johnnyclem/EP-DJ3000/artifacts/searched_images/0aDA2.jpg

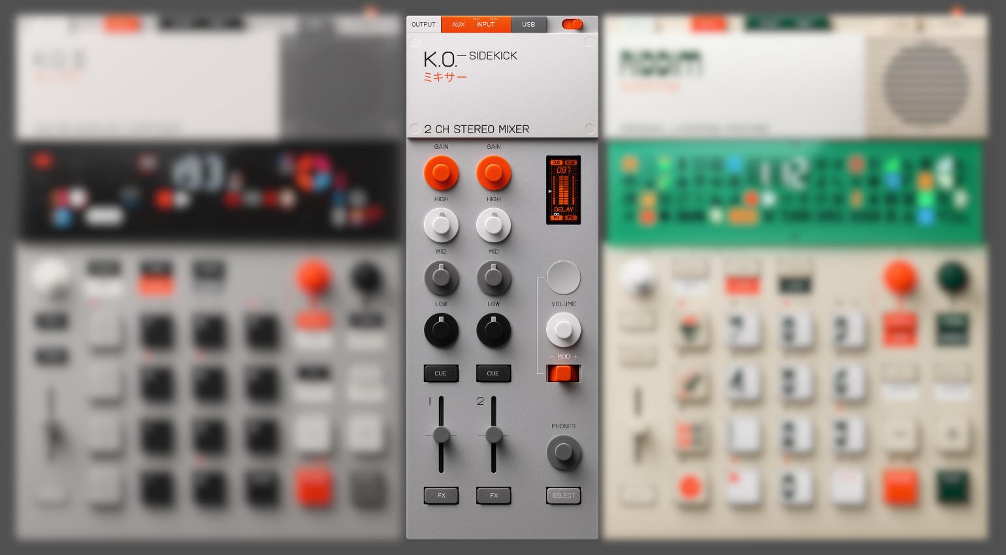
artifacts/searched_images/0aDA2.jpg
