johnnyclem/EP-DJ3000/artifacts/searched_images/1Hn3o.jpg

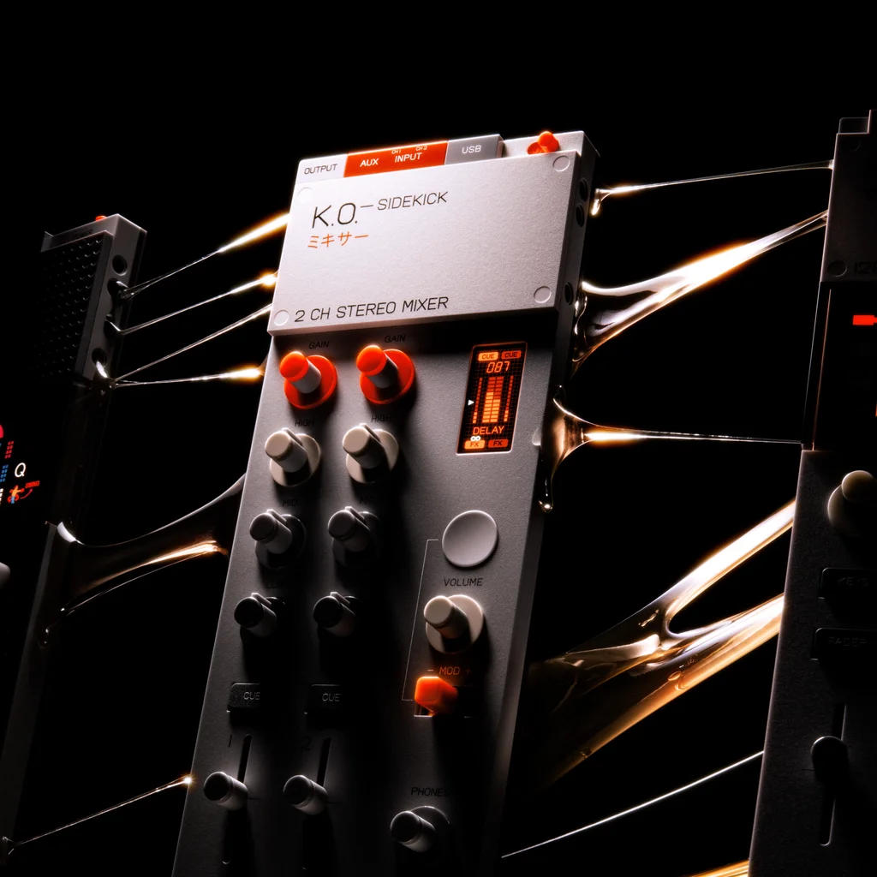
artifacts/searched_images/1Hn3o.jpg
