johnnyclem/EP-DJ3000/artifacts/searched_images/2lIIS.jpg

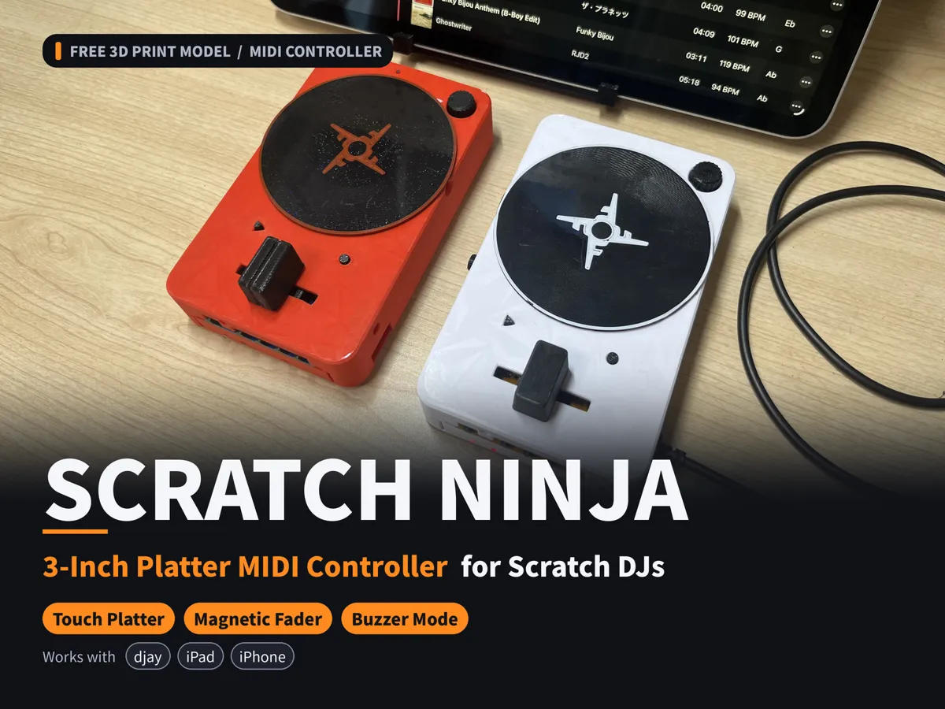
artifacts/searched_images/2lIIS.jpg
