johnnyclem/EP-DJ3000/artifacts/searched_images/Bpl0B.jpg

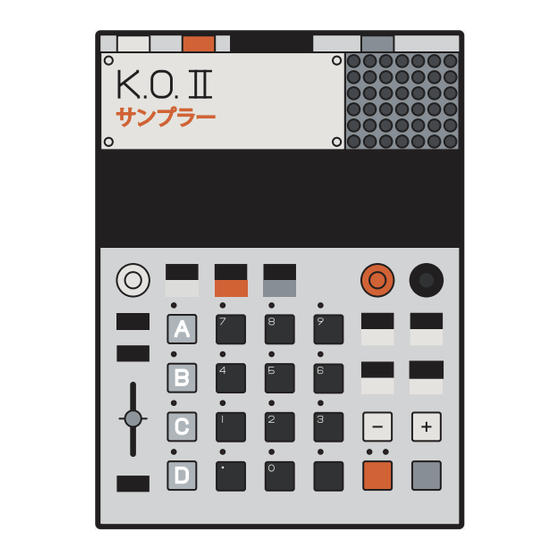
artifacts/searched_images/Bpl0B.jpg
