johnnyclem/EP-DJ3000/artifacts/searched_images/CU1t4.jpg

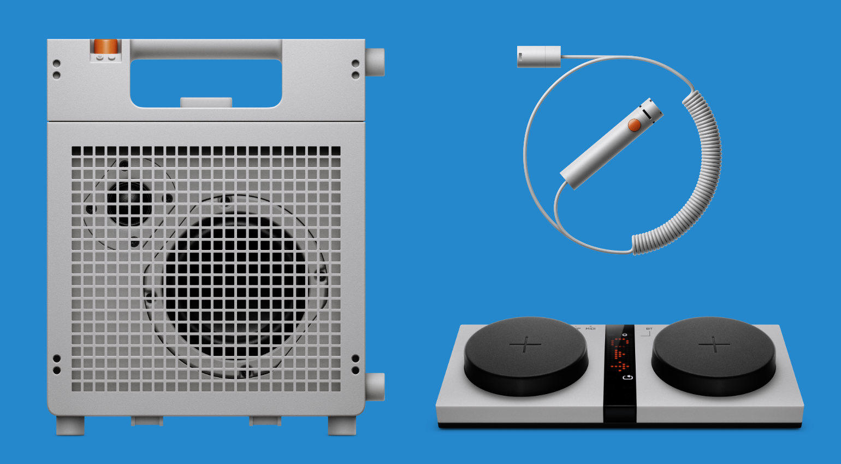
artifacts/searched_images/CU1t4.jpg
