johnnyclem/EP-DJ3000/artifacts/searched_images/eoEJe.jpg

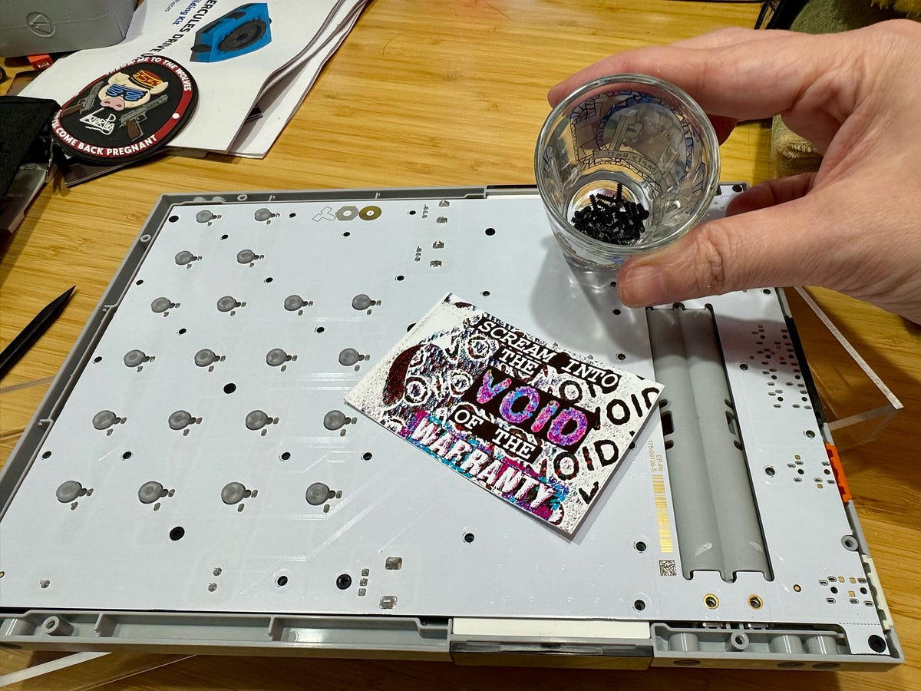
artifacts/searched_images/eoEJe.jpg
