johnnyclem/EP-DJ3000/artifacts/searched_images/ep7Hu.jpg

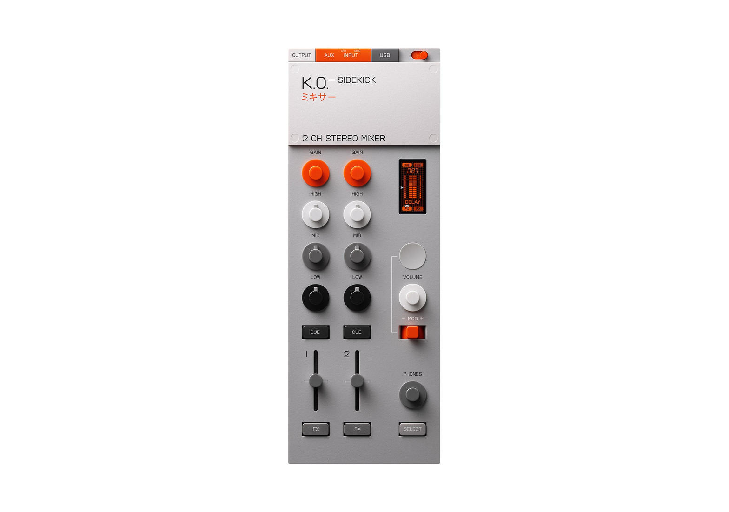
artifacts/searched_images/ep7Hu.jpg
