johnnyclem/EP-DJ3000/artifacts/searched_images/fRpeS.jpg

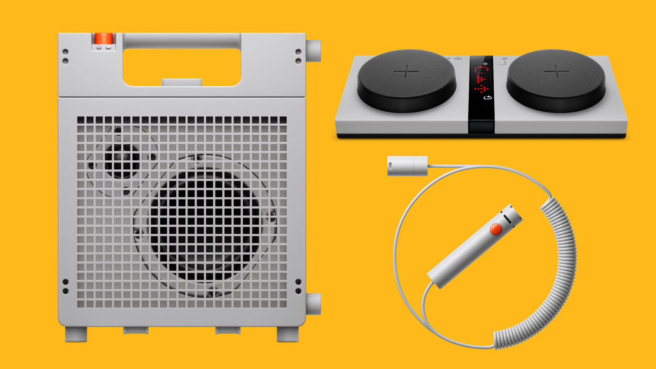
artifacts/searched_images/fRpeS.jpg
