johnnyclem/EP-DJ3000/artifacts/searched_images/FZIE1.jpg

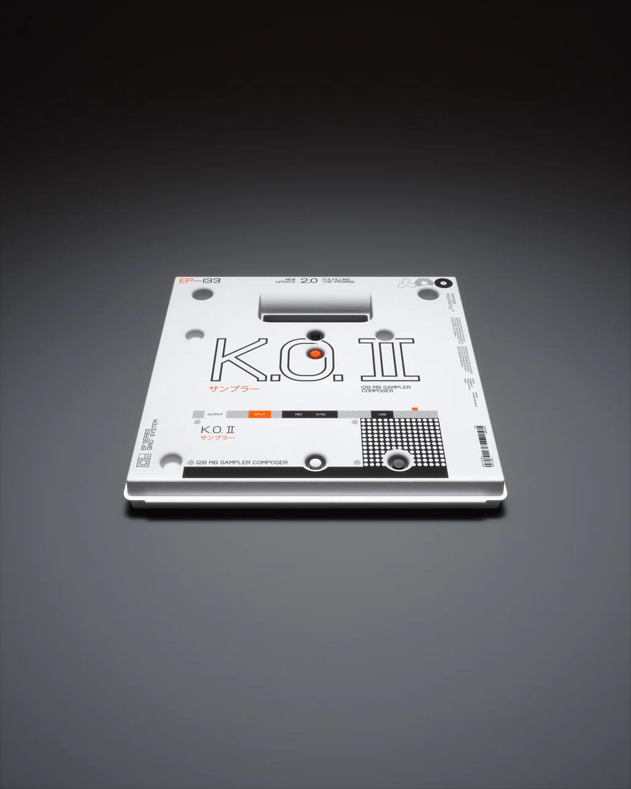
artifacts/searched_images/FZIE1.jpg
