johnnyclem/EP-DJ3000/artifacts/searched_images/GA8qb.jpg

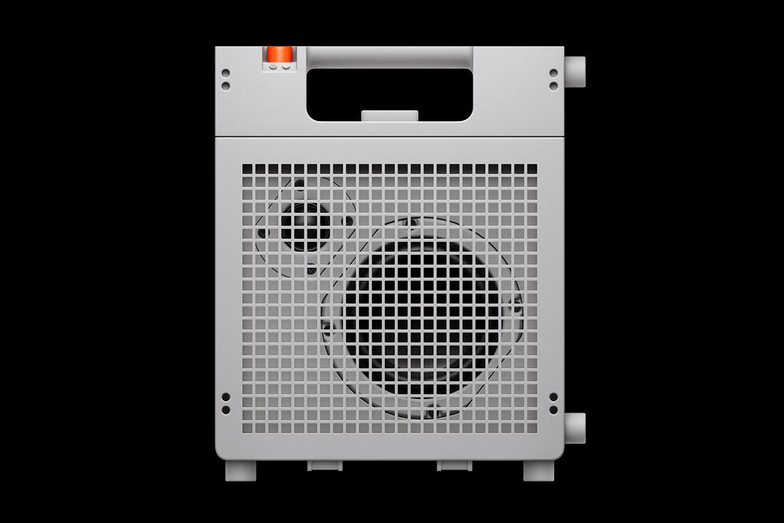
artifacts/searched_images/GA8qb.jpg
