johnnyclem/EP-DJ3000/artifacts/searched_images/iFiOh.jpg

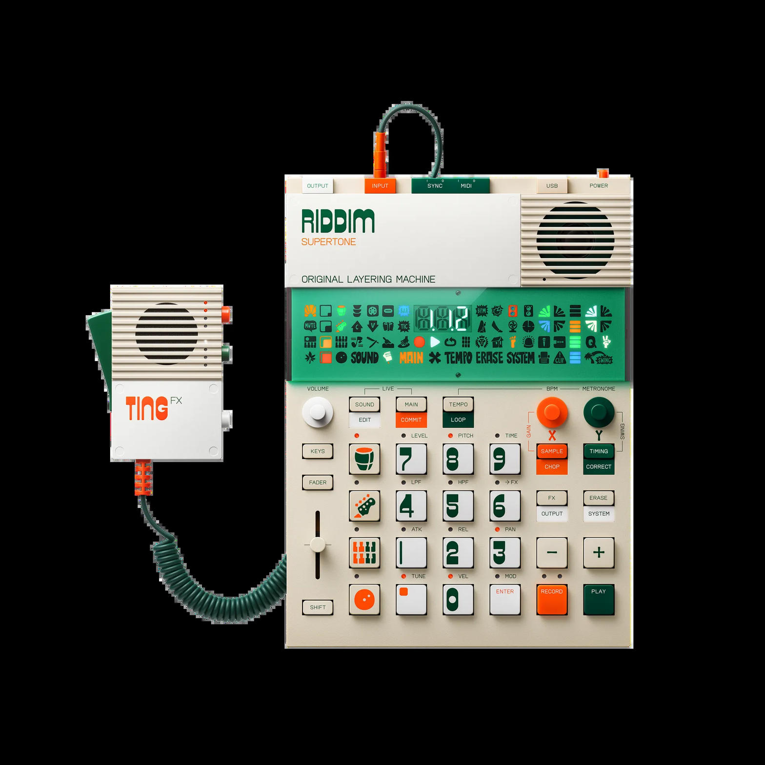
artifacts/searched_images/iFiOh.jpg
