johnnyclem/EP-DJ3000/artifacts/searched_images/ihluV.jpg

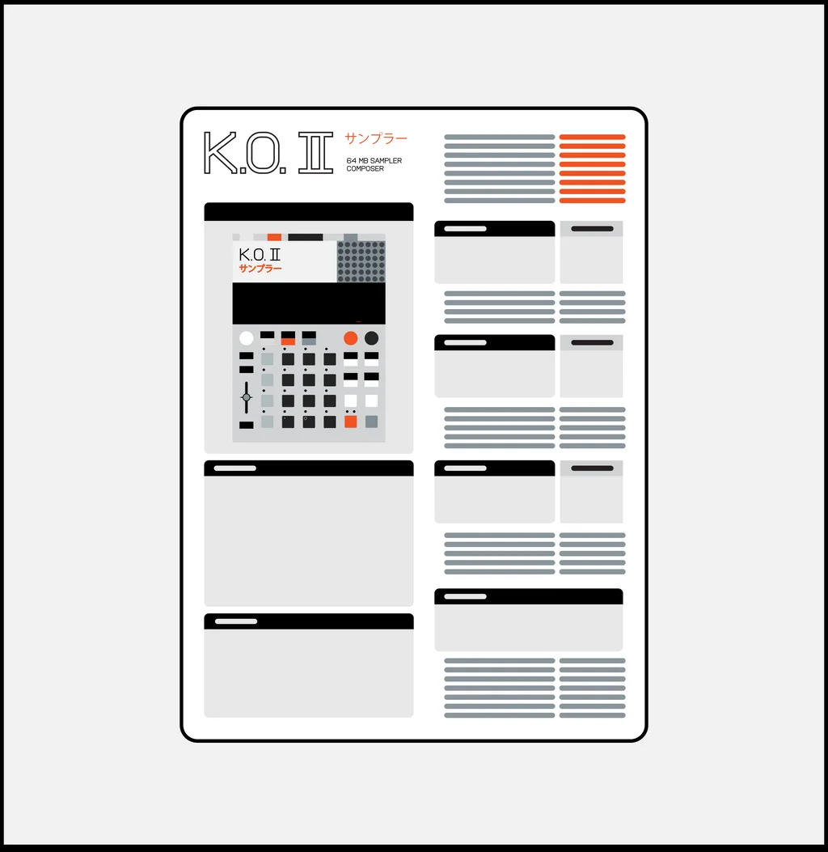
artifacts/searched_images/ihluV.jpg
