johnnyclem/EP-DJ3000/artifacts/searched_images/Iwwkr.jpg

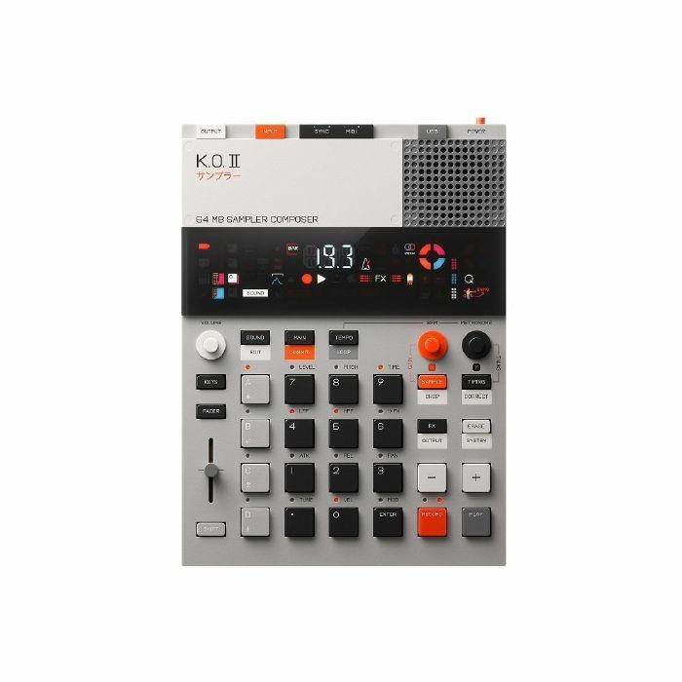
artifacts/searched_images/Iwwkr.jpg
