johnnyclem/EP-DJ3000/artifacts/searched_images/KVUyy.jpg

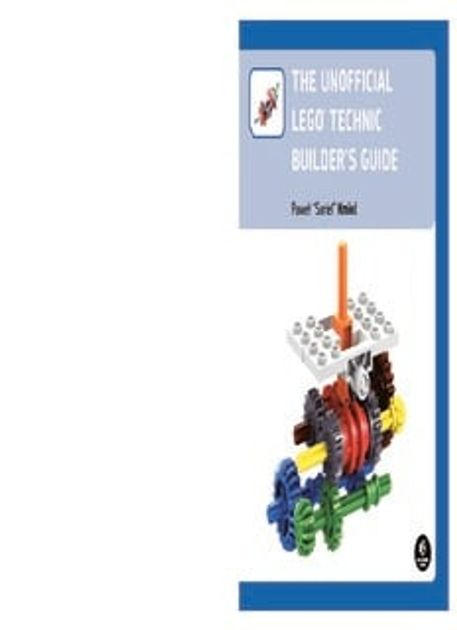
artifacts/searched_images/KVUyy.jpg
