johnnyclem/EP-DJ3000/artifacts/searched_images/Lq6Z9.jpg

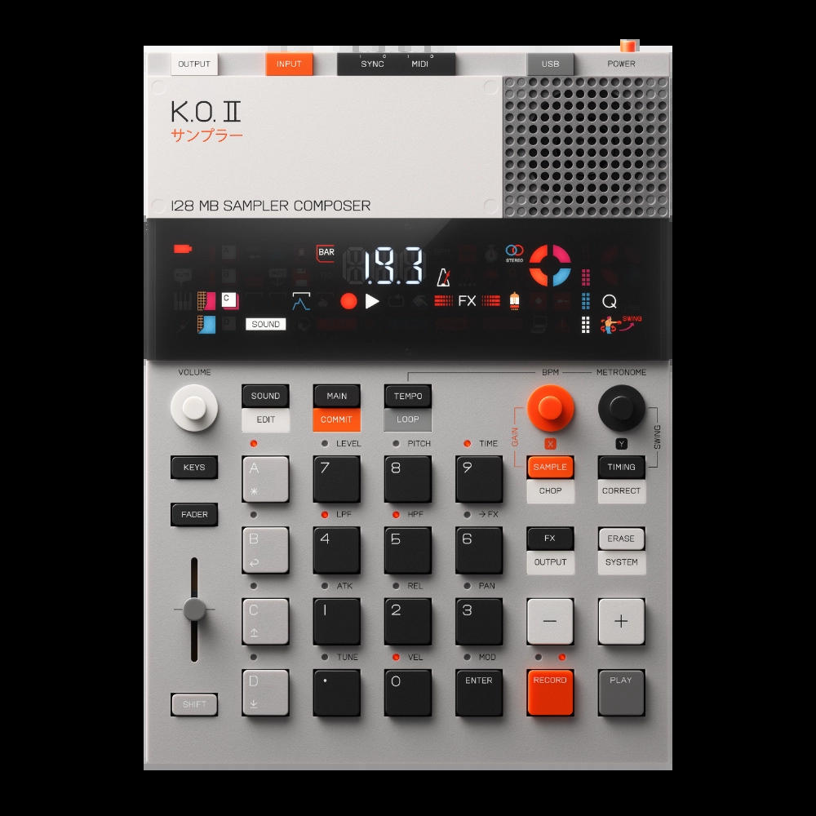
artifacts/searched_images/Lq6Z9.jpg
