johnnyclem/EP-DJ3000/artifacts/searched_images/m1aqs.jpg

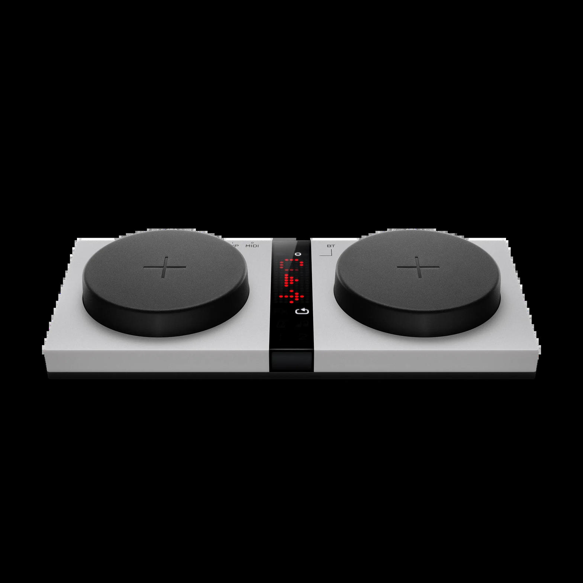
artifacts/searched_images/m1aqs.jpg
