johnnyclem/EP-DJ3000/artifacts/searched_images/nP86a.jpg

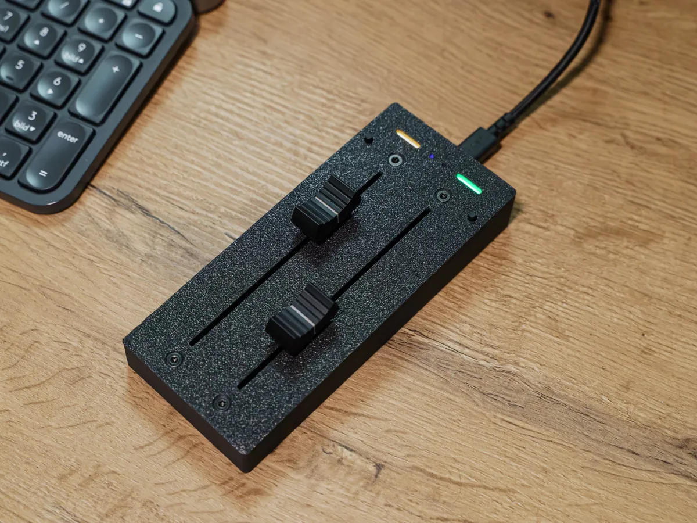
artifacts/searched_images/nP86a.jpg
