johnnyclem/EP-DJ3000/artifacts/searched_images/pBY69.jpg

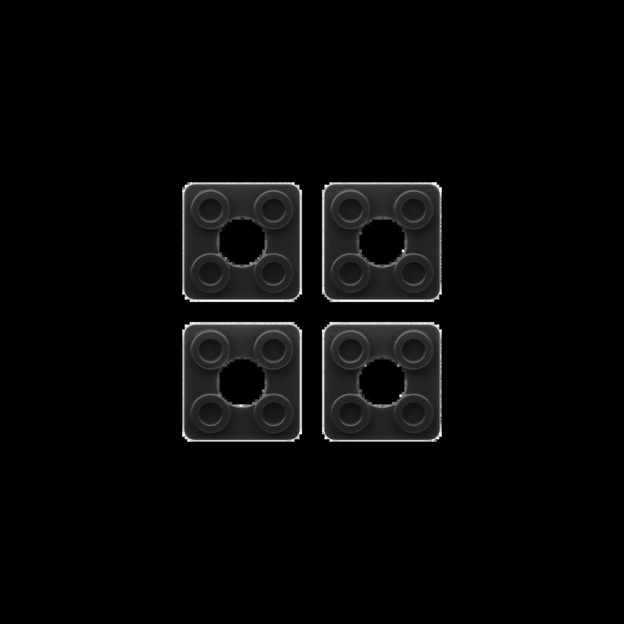
artifacts/searched_images/pBY69.jpg
