johnnyclem/EP-DJ3000/artifacts/searched_images/RAQyJ.jpg

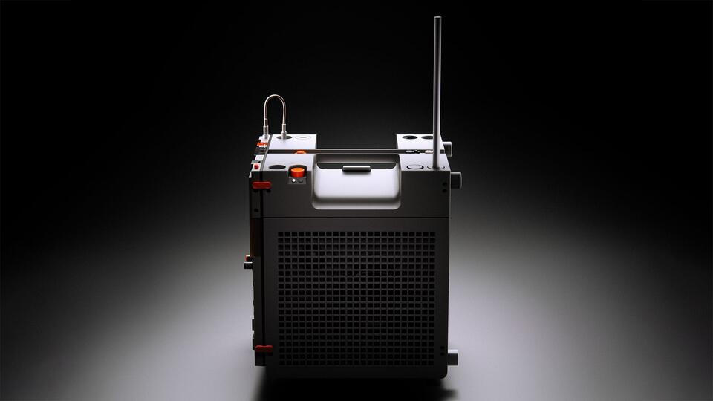
artifacts/searched_images/RAQyJ.jpg
