johnnyclem/EP-DJ3000/artifacts/searched_images/Tj97H.jpg

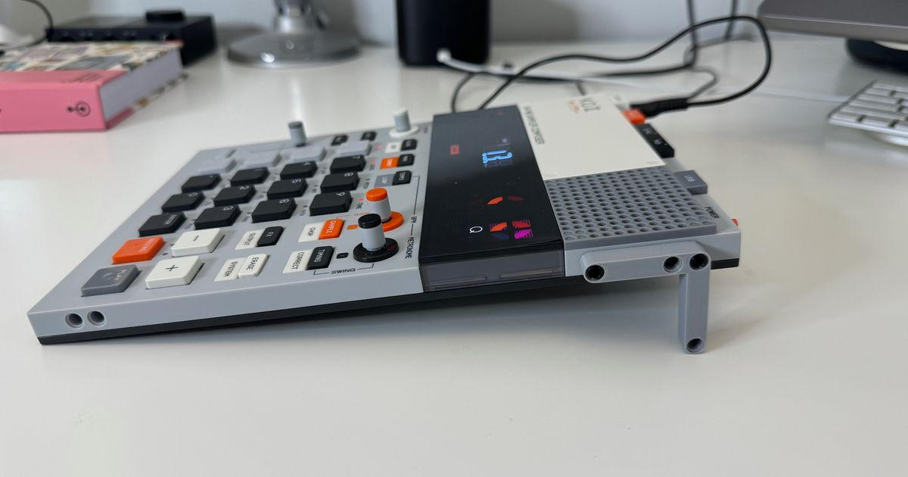
artifacts/searched_images/Tj97H.jpg
