johnnyclem/EP-DJ3000/artifacts/searched_images/U6moF.jpg

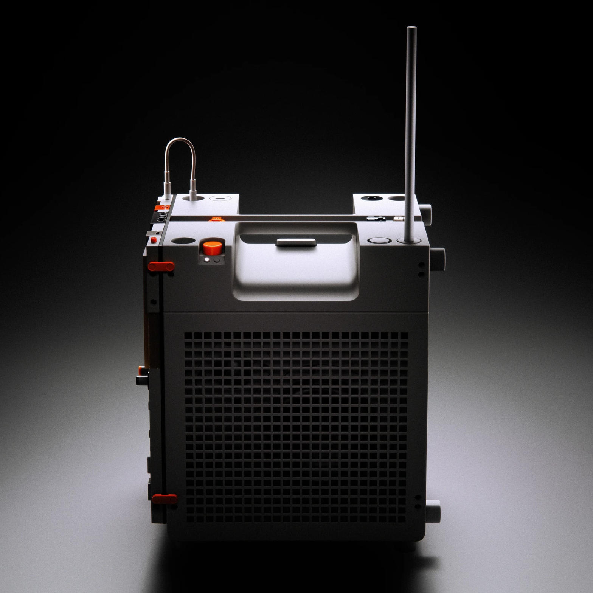
artifacts/searched_images/U6moF.jpg
