johnnyclem/EP-DJ3000/artifacts/searched_images/ufimg.jpg

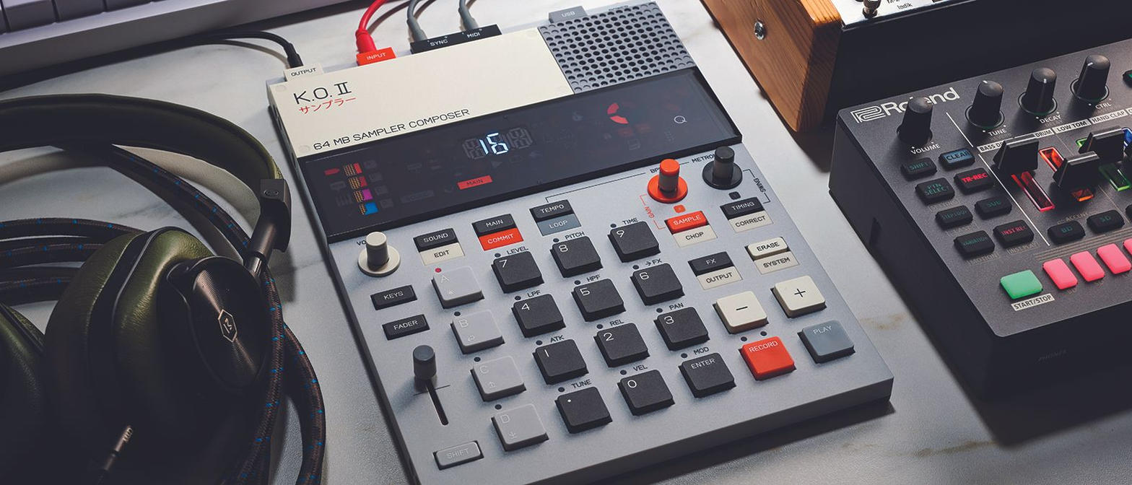
artifacts/searched_images/ufimg.jpg
