johnnyclem/EP-DJ3000/artifacts/searched_images/W83gK.jpg

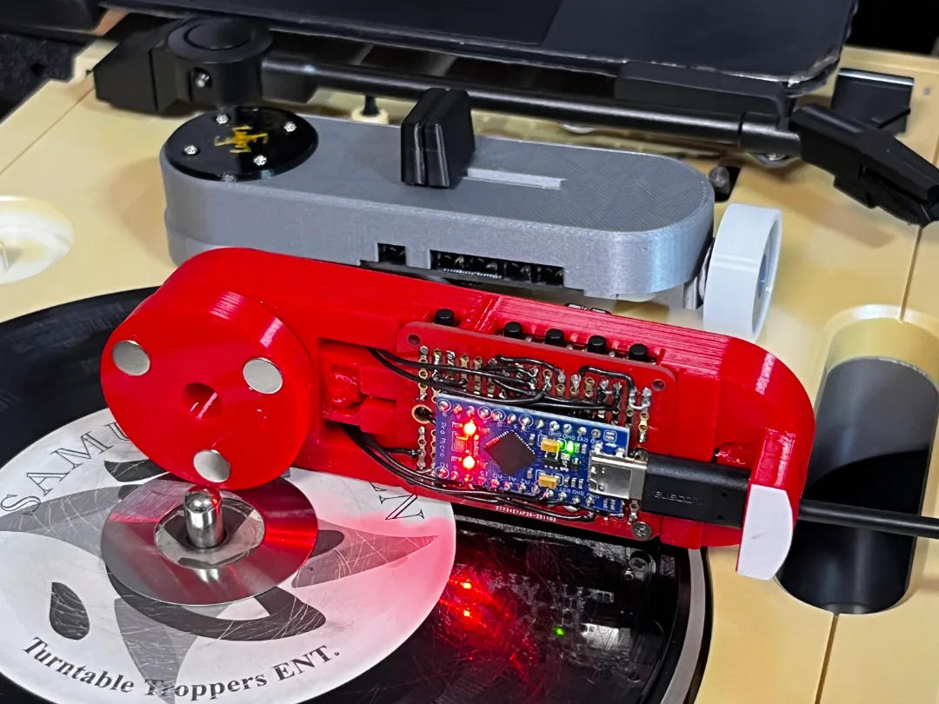
artifacts/searched_images/W83gK.jpg
