johnnyclem/EP-DJ3000/attachments/IMG_1222.jpg

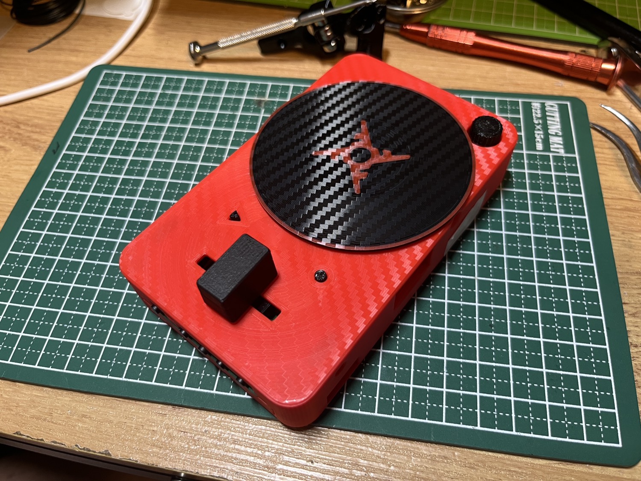
attachments/IMG_1222.jpg
