johnnyclem/EP-DJ3000/attachments/IMG_1223.jpg

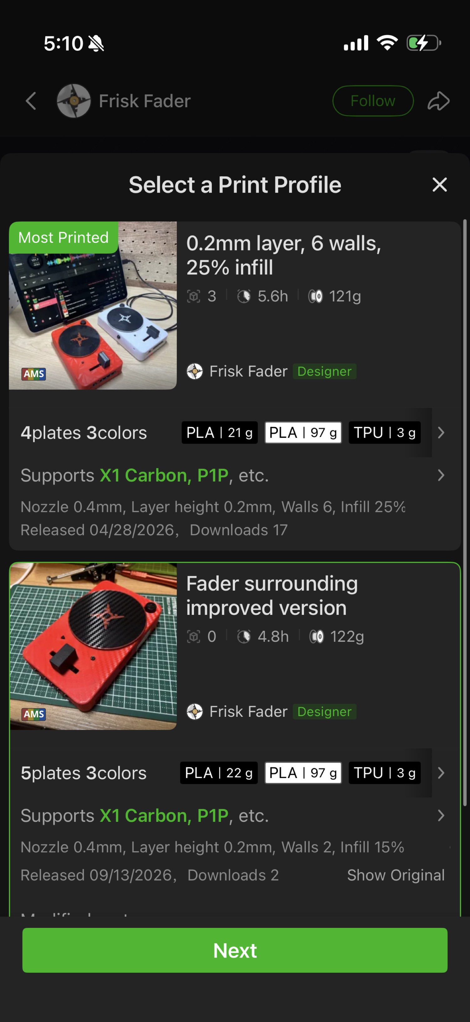
attachments/IMG_1223.jpg
