johnnyclem/EP-DJ3000/attachments/IMG_1224.jpg

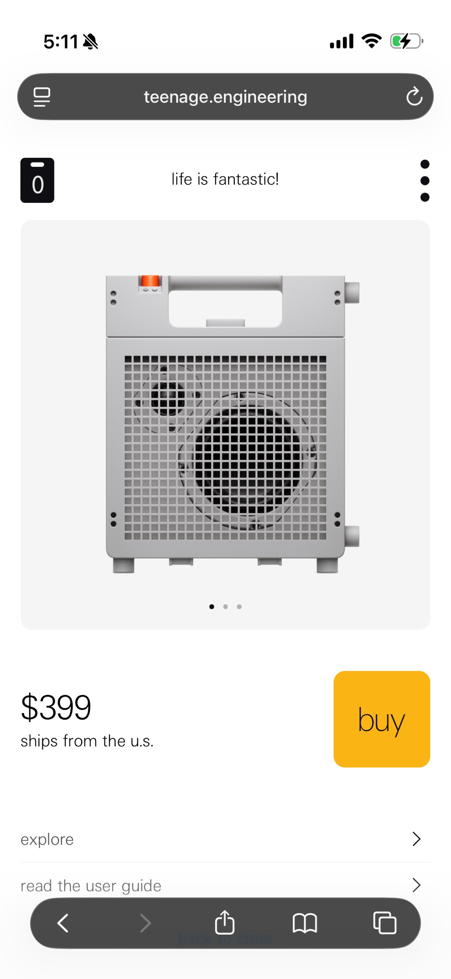
attachments/IMG_1224.jpg
