johnnyclem/EP-DJ3000/attachments/IMG_1225.jpg

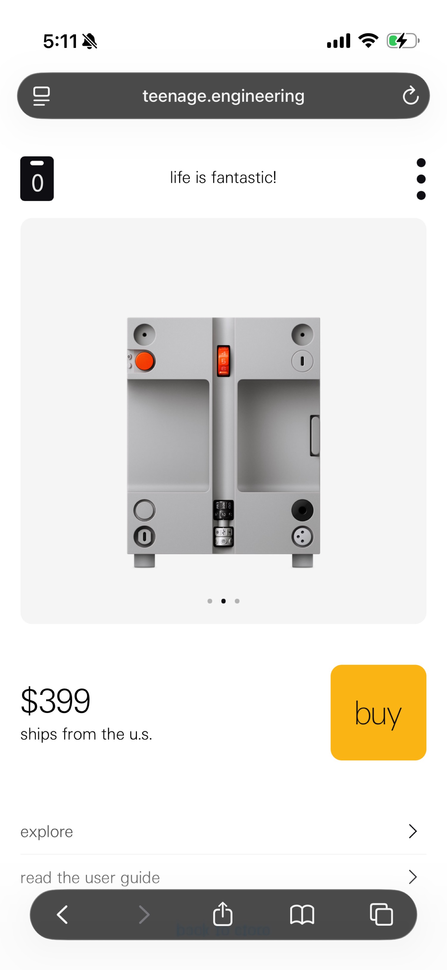
attachments/IMG_1225.jpg
