johnnyclem/EP-DJ3000/attachments/IMG_1226.jpg

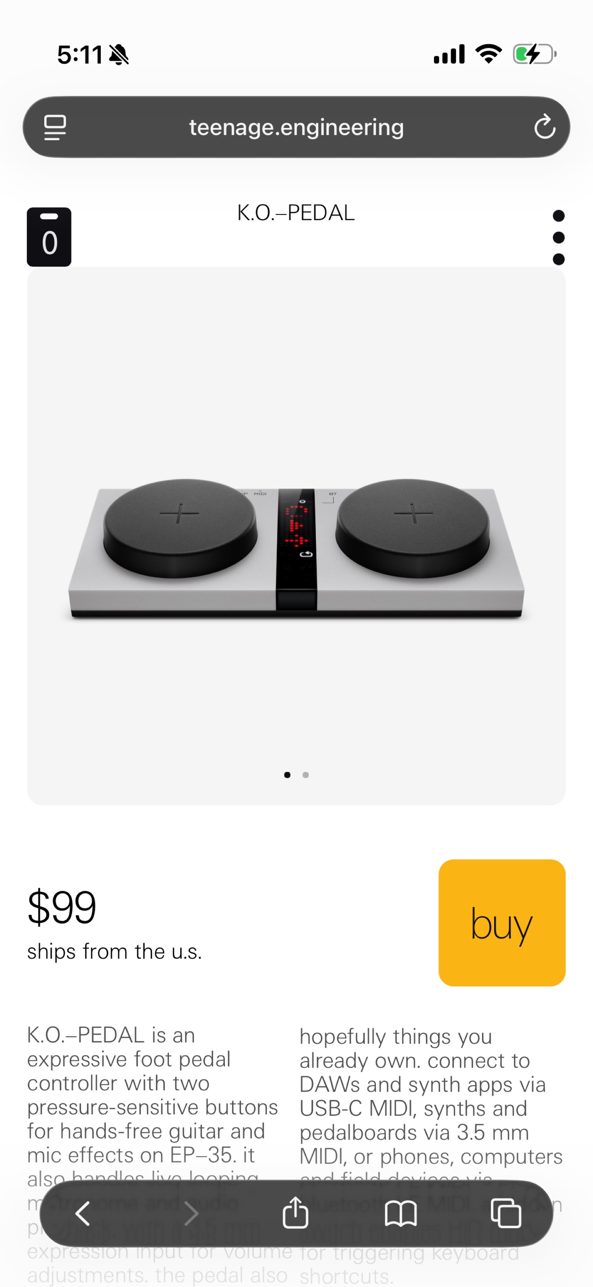
attachments/IMG_1226.jpg
