johnnyclem/EP-DJ3000/attachments/IMG_1227.jpg

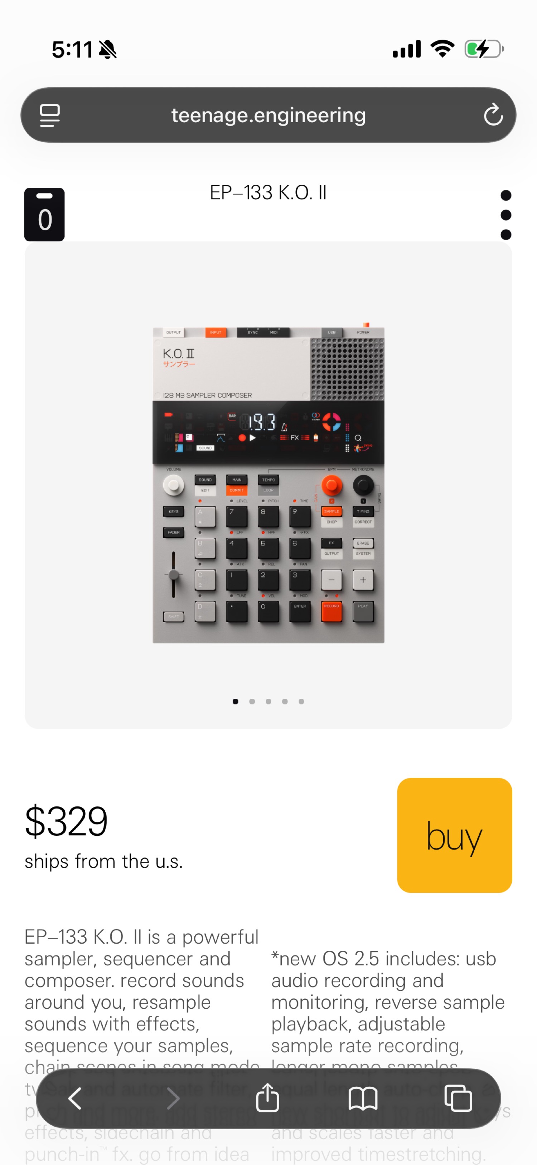
attachments/IMG_1227.jpg
