johnnyclem/EP-DJ3000/attachments/IMG_1228.jpg

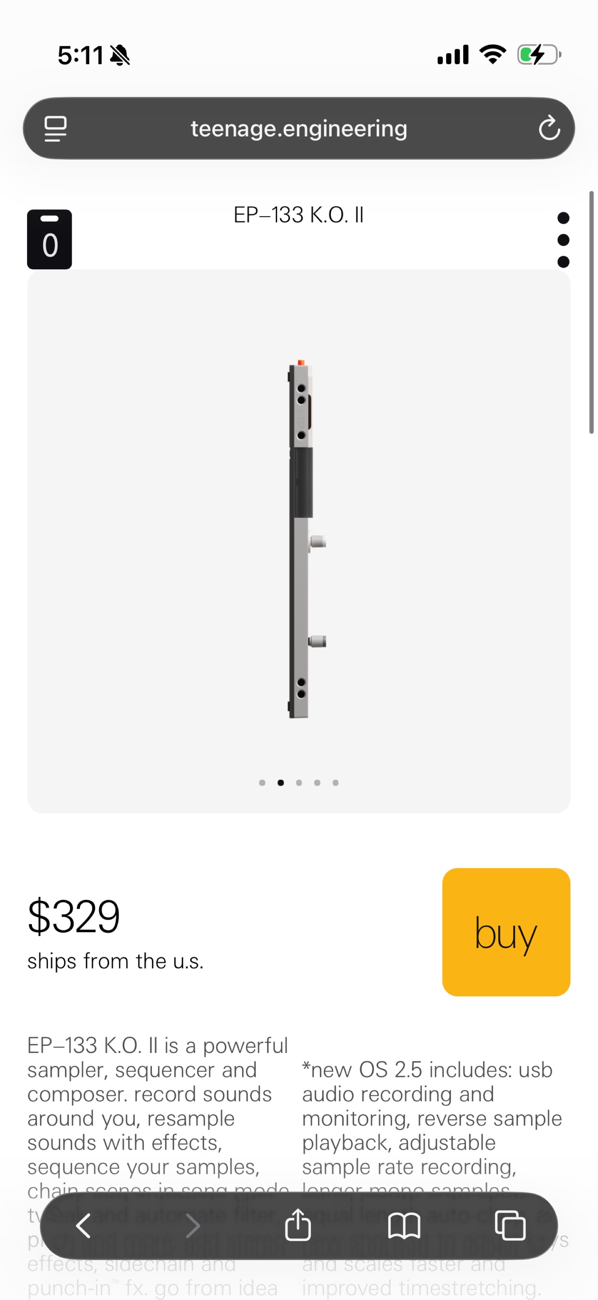
attachments/IMG_1228.jpg
