johnnyclem/EP-DJ3000/attachments/IMG_1229.jpg

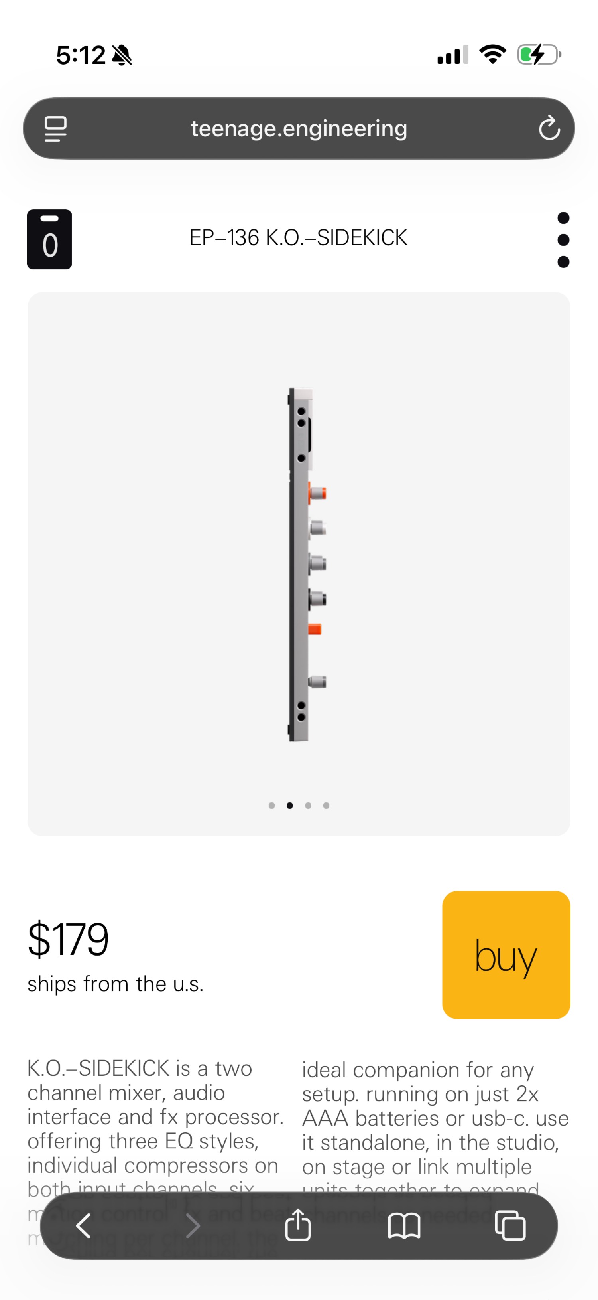
attachments/IMG_1229.jpg
