johnnyclem/EP-DJ3000/attachments/IMG_1230.jpg

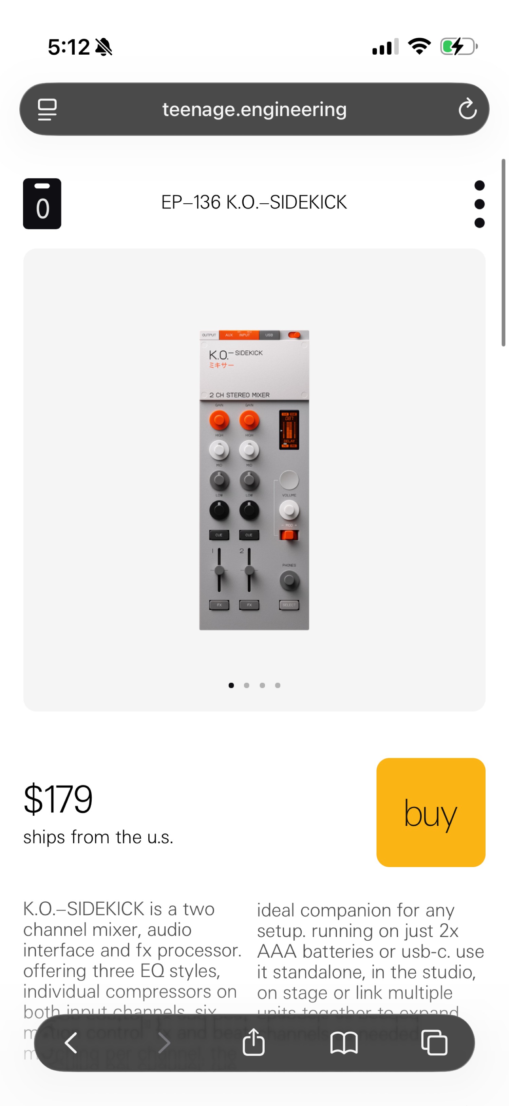
attachments/IMG_1230.jpg
