johnnyclem/EP-DJ3000/field-jog/preview/pins-section.png

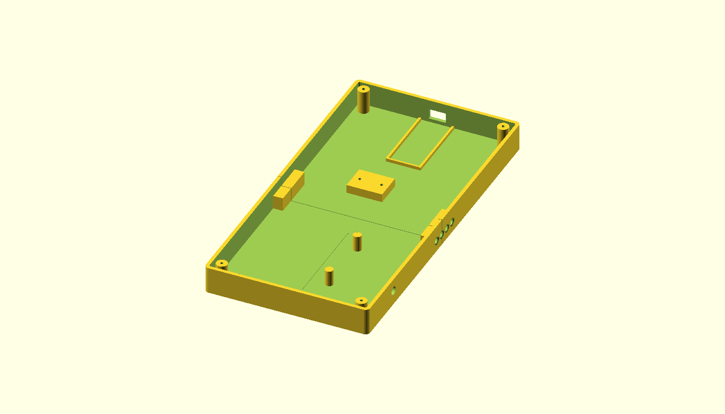
field-jog/preview/pins-section.png
