johnnyclem/EP-DJ3000/field-jog/preview/section.png

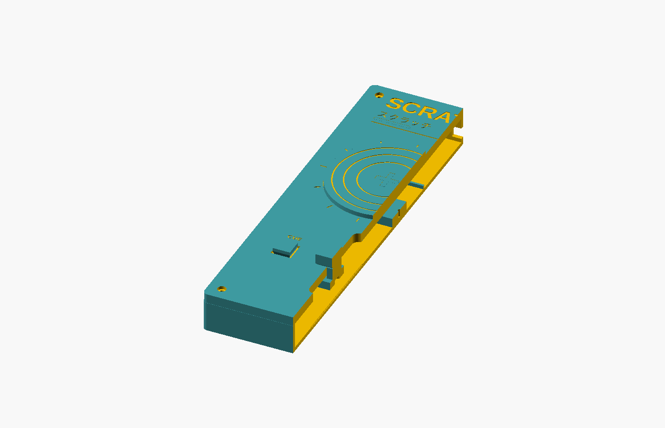
field-jog/preview/section.png
