johnnyclem/EP-DJ3000/field-jog/preview/side.png

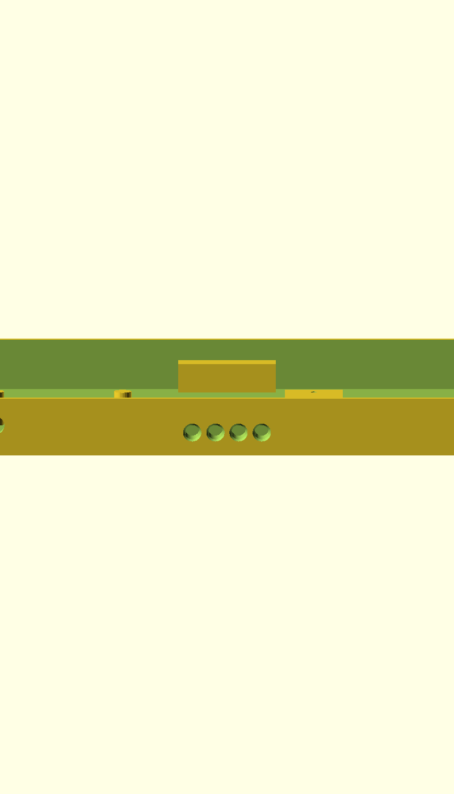
field-jog/preview/side.png
