johnnyclem/EP-DJ3000/screenshots/built-now-mobile.png

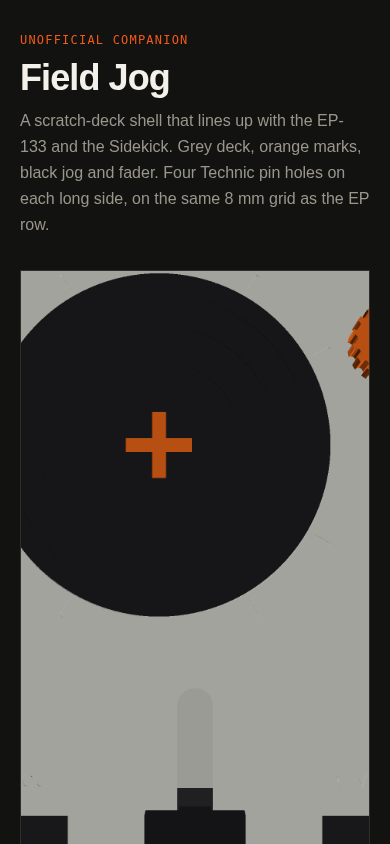
screenshots/built-now-mobile.png
