johnnyclem/EP-DJ3000/screenshots/built-now.png

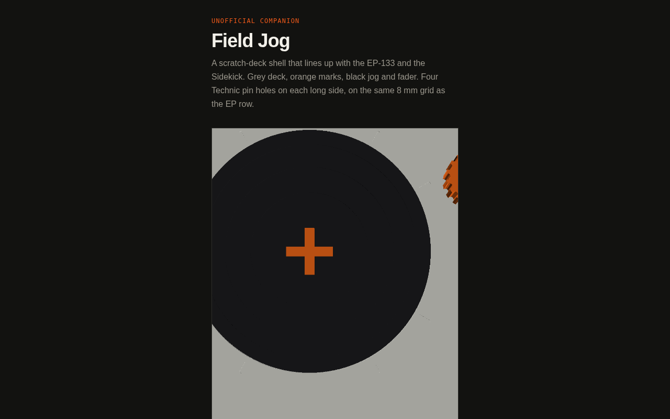
screenshots/built-now.png
