johnnyclem/EP-DJ3000/screenshots/viewer-built.png

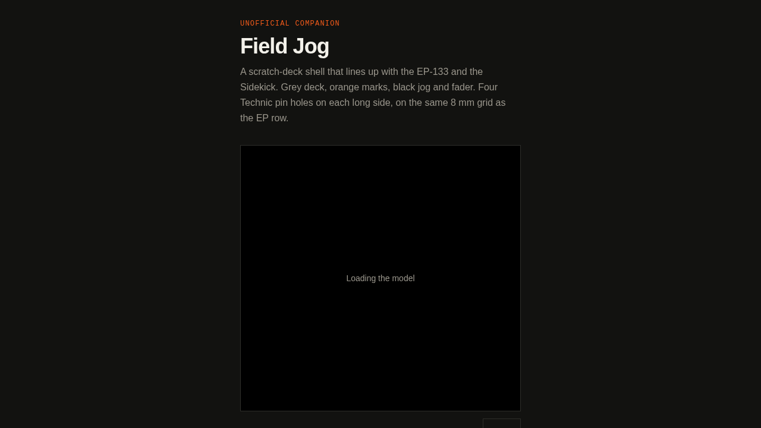
screenshots/viewer-built.png
