johnnyclem/EP-DJ3000/screenshots/viewer-fader.png

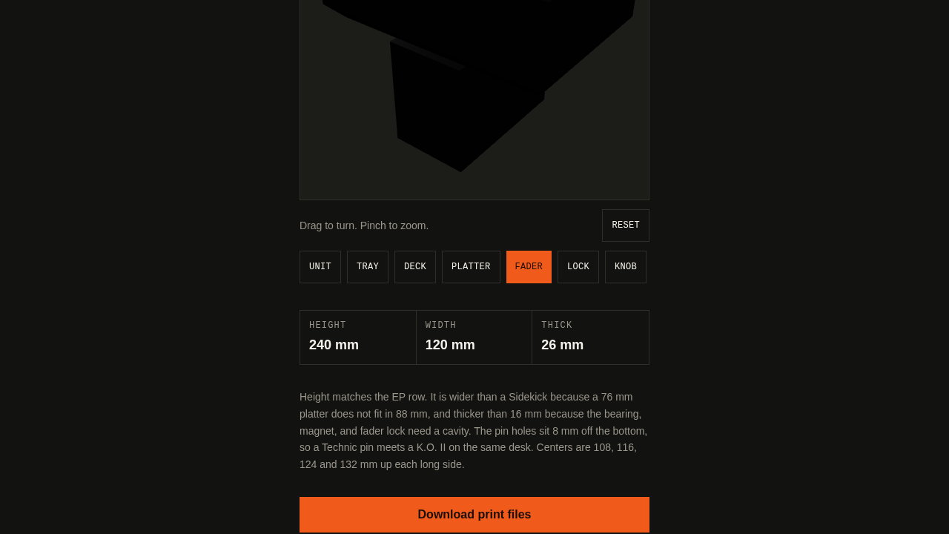
screenshots/viewer-fader.png
