johnnyclem/EP-DJ3000/screenshots/viewer-knob.png

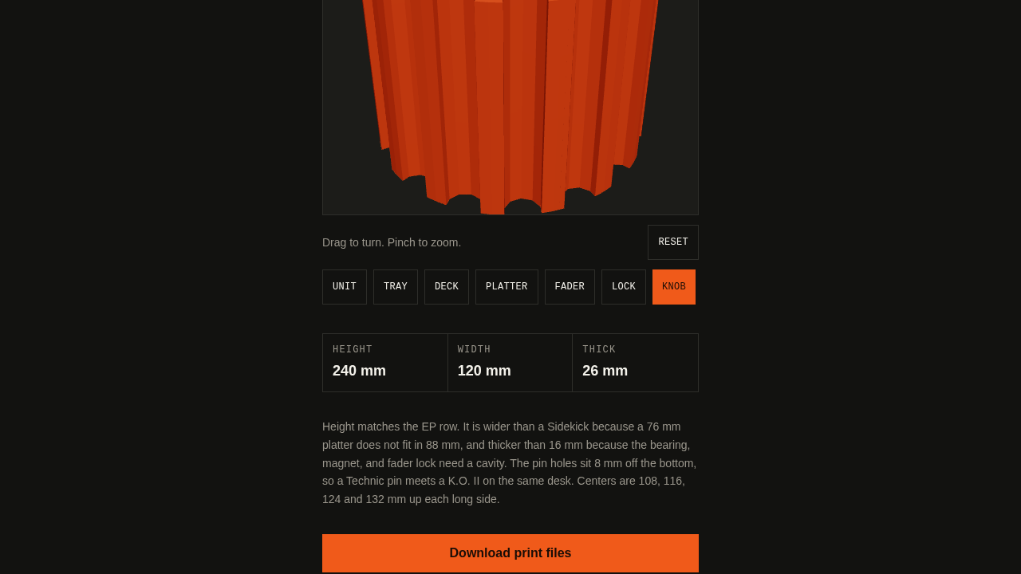
screenshots/viewer-knob.png
