johnnyclem/EP-DJ3000/screenshots/viewer-platter.png

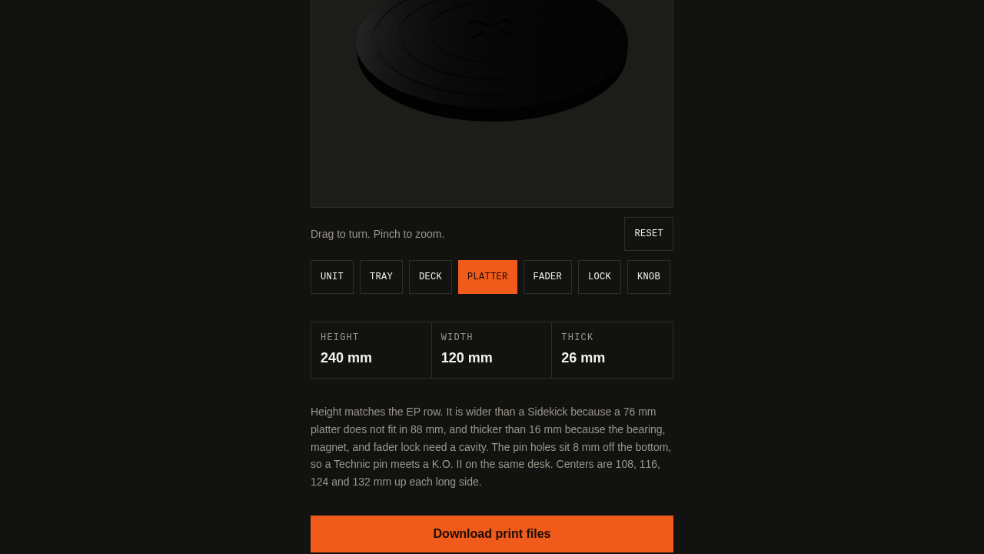
screenshots/viewer-platter.png
