johnnyclem/EP-DJ3000/screenshots/viewer-show.png

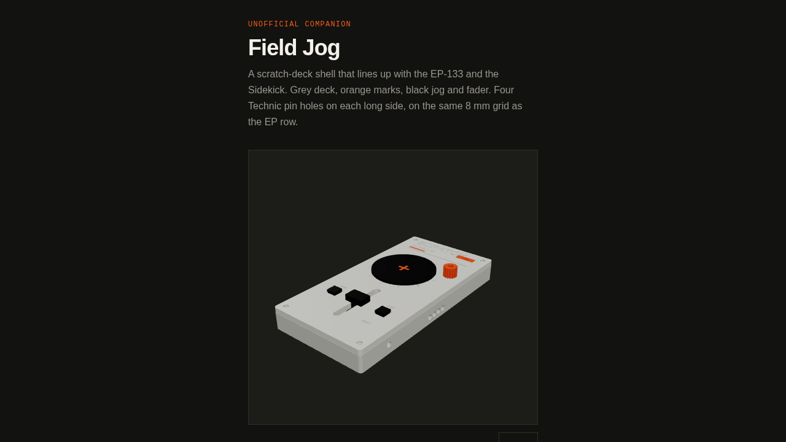
screenshots/viewer-show.png
