johnnyclem/EP-DJ3000/.vercel/output/static/ecm-handy/button.stl

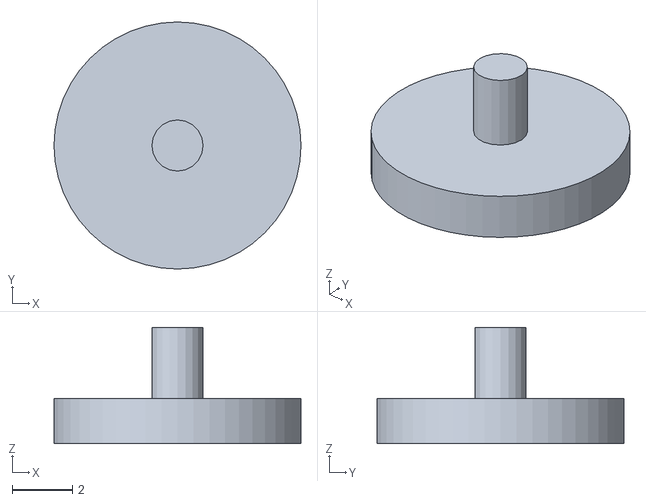
[picture p50: CAD file, 2026-11-05]
.vercel/output/static/ecm-handy/button.stl
8.20 x 8.20 x 3.86
