johnnyclem/EP-DJ3000/.vercel/output/static/field-jog/four/tray.stl

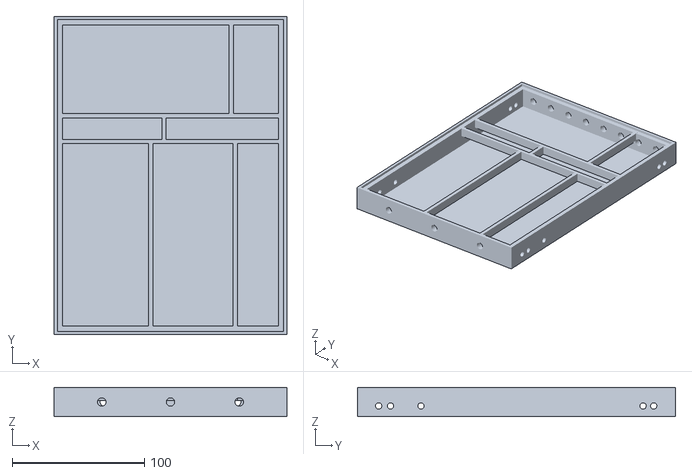
[picture p51: CAD file, 2026-11-06]
.vercel/output/static/field-jog/four/tray.stl
176.0 x 240.5 x 22.0
