johnnyclem/EP-DJ3000/.vercel/output/static/field-jog/stl/wide-twin-top.stl

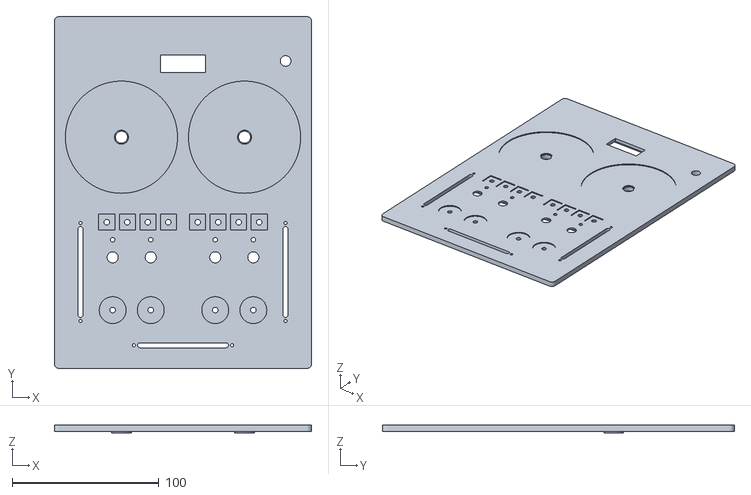
[picture p52: CAD file, 2026-11-08]
.vercel/output/static/field-jog/stl/wide-twin-top.stl
175.7 x 240.2 x 5.30
