johnnyclem/EP-DJ3000/field-jog/stl/go-util.stl

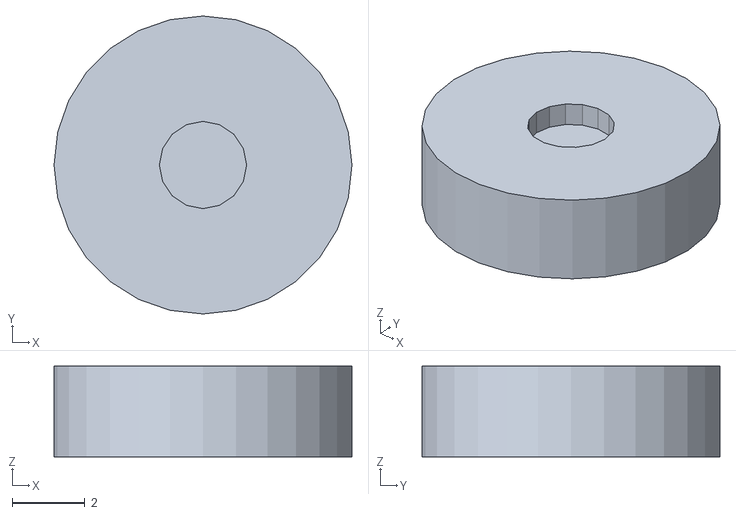
[picture p53: CAD file, 2026-11-13]
field-jog/stl/go-util.stl
8.20 x 8.20 x 2.50
