johnnyclem/EP-DJ3000/hardware/platter-test/stl/wedge.stl

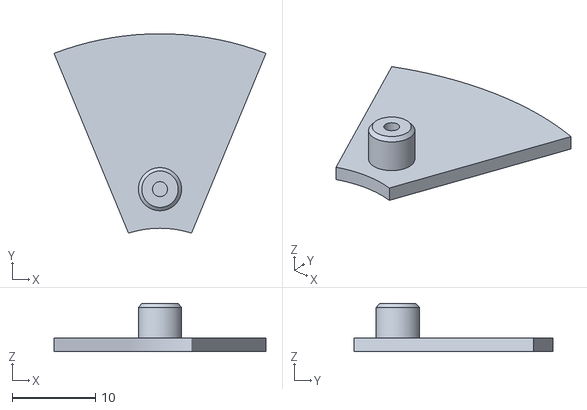
[picture p54: CAD file, 2026-11-05]
hardware/platter-test/stl/wedge.stl
25.5 x 24.0 x 5.78
