johnnyclem/EP-DJ3000/public/field-jog/loop.stl

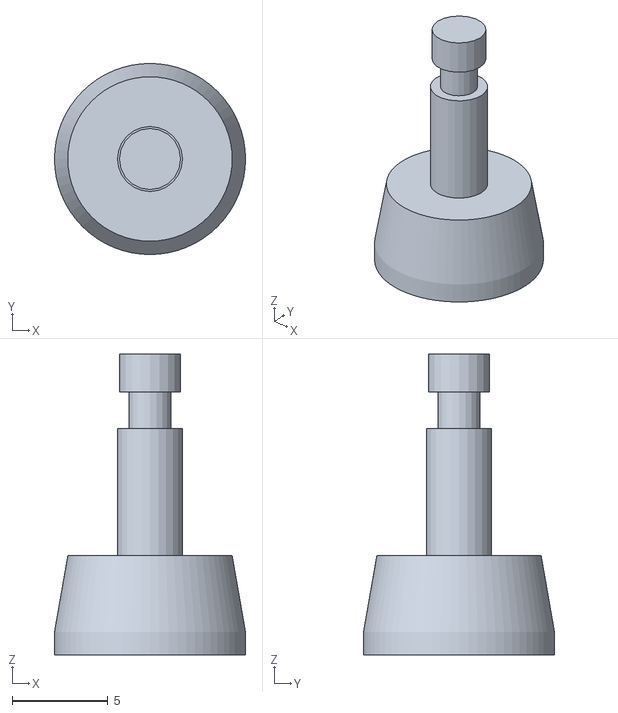
[picture p55: CAD file, 2026-11-10]
public/field-jog/loop.stl
10.0 x 10.0 x 15.8
