johnnyclem/EP-DJ3000/public/field-jog/stl/go-cap.stl

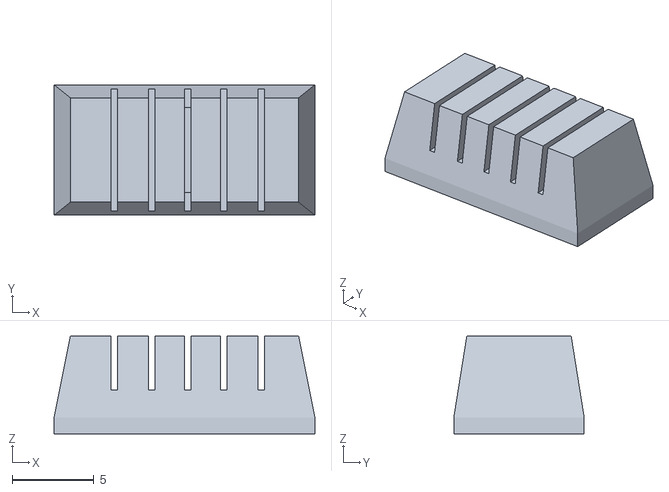
[picture p56: CAD file, 2026-11-13]
public/field-jog/stl/go-cap.stl
16.0 x 8.00 x 6.00
