johnnyclem/EP-DJ3000/.vercel/output/static/ecm-handy/body.stl

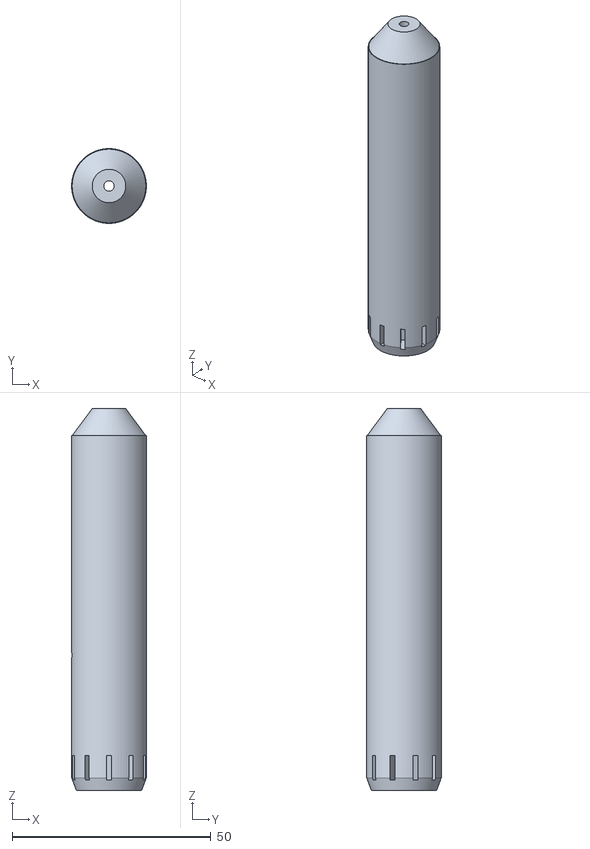
[picture p57: CAD file, 2026-11-05]
.vercel/output/static/ecm-handy/body.stl
18.8 x 18.8 x 96.0
