johnnyclem/EP-DJ3000/.vercel/output/static/field-jog/four/faders-34.stl

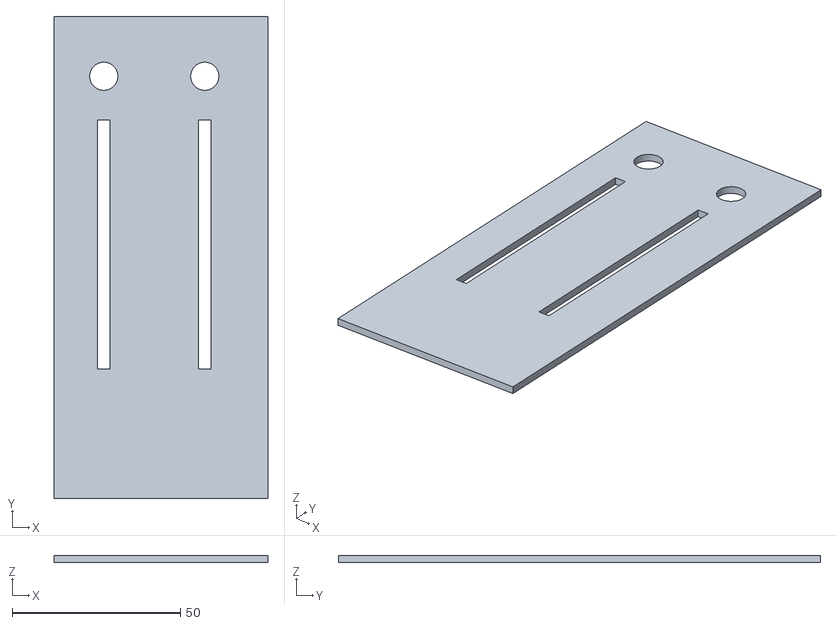
[picture p58: CAD file, 2026-11-06]
.vercel/output/static/field-jog/four/faders-34.stl
63.5 x 143.2 x 2.20
