johnnyclem/EP-DJ3000/.vercel/output/static/field-jog/stl/wide-six-bottom.stl

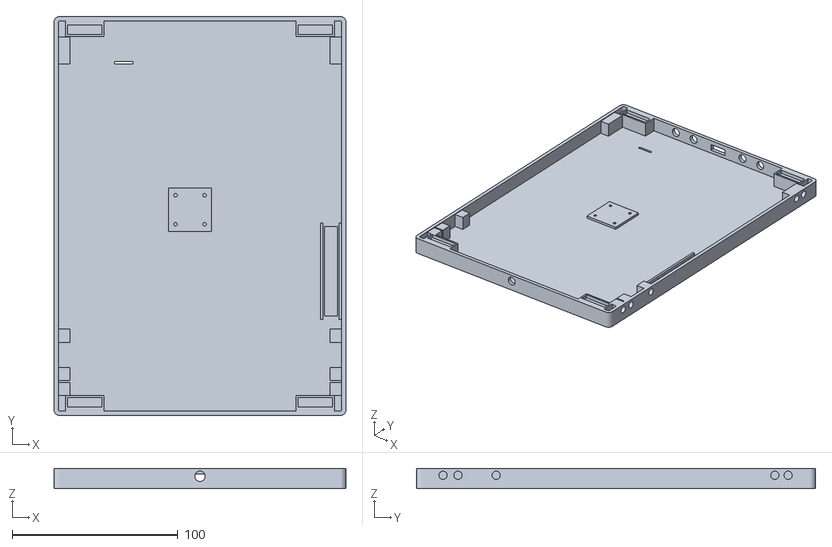
[picture p59: CAD file, 2026-11-08]
.vercel/output/static/field-jog/stl/wide-six-bottom.stl
176.0 x 240.5 x 12.1
