johnnyclem/EP-DJ3000/field-jog/stl/go-bezel.stl

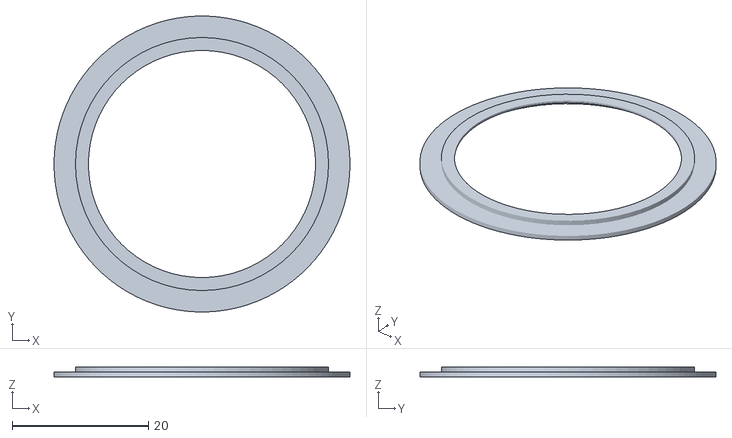
[picture p60: CAD file, 2026-11-13]
field-jog/stl/go-bezel.stl
43.4 x 43.4 x 1.45
