johnnyclem/EP-DJ3000/hardware/platter-test/stl/wedges.stl

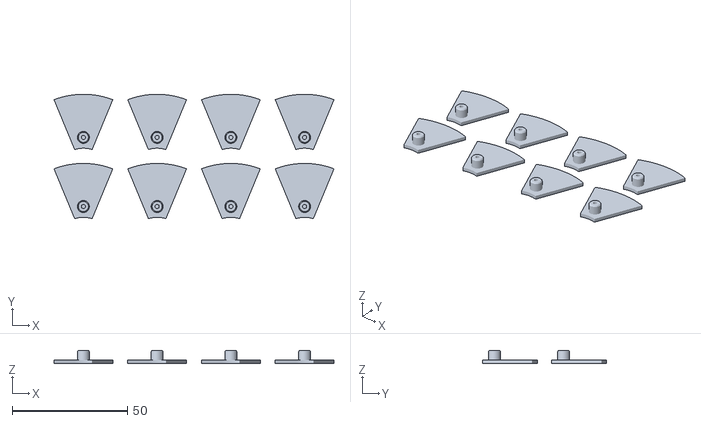
[picture p61: CAD file, 2026-11-05]
hardware/platter-test/stl/wedges.stl
121.5 x 54.0 x 5.78
