johnnyclem/EP-DJ3000/public/field-jog/button.stl

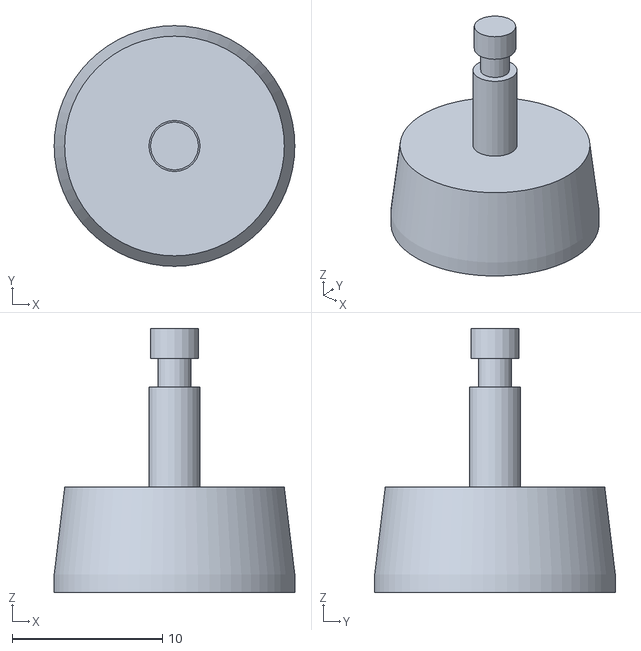
[picture p62: CAD file, 2026-11-10]
public/field-jog/button.stl
16.0 x 16.0 x 17.6
