johnnyclem/EP-DJ3000/public/field-jog/stl/go-knob.stl

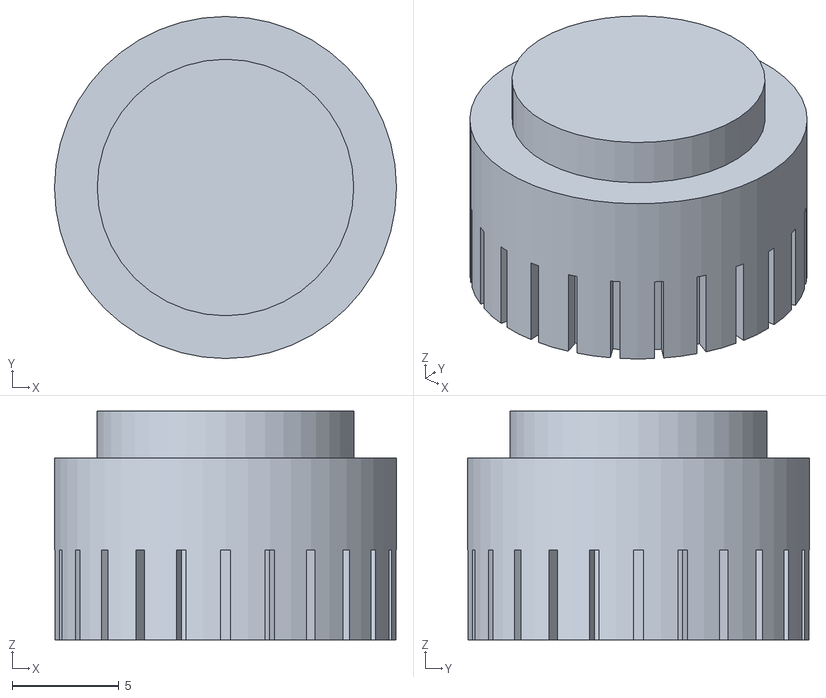
[picture p63: CAD file, 2026-11-13]
public/field-jog/stl/go-knob.stl
16.0 x 16.0 x 10.7
