johnnyclem/EP-DJ3000/.vercel/output/static/field-jog/four/cap-master.stl

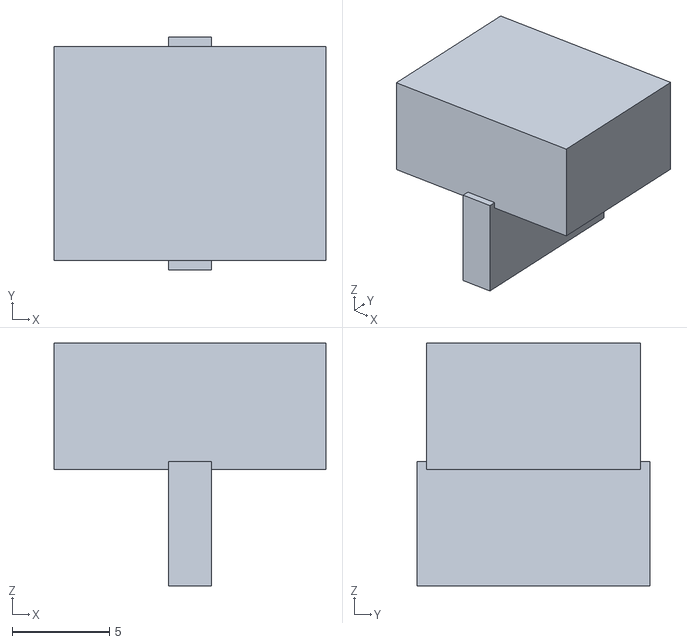
[picture p64: CAD file, 2026-11-06]
.vercel/output/static/field-jog/four/cap-master.stl
14.0 x 12.0 x 12.5
