johnnyclem/EP-DJ3000/.vercel/output/static/field-jog/stl/wide-six-top.stl

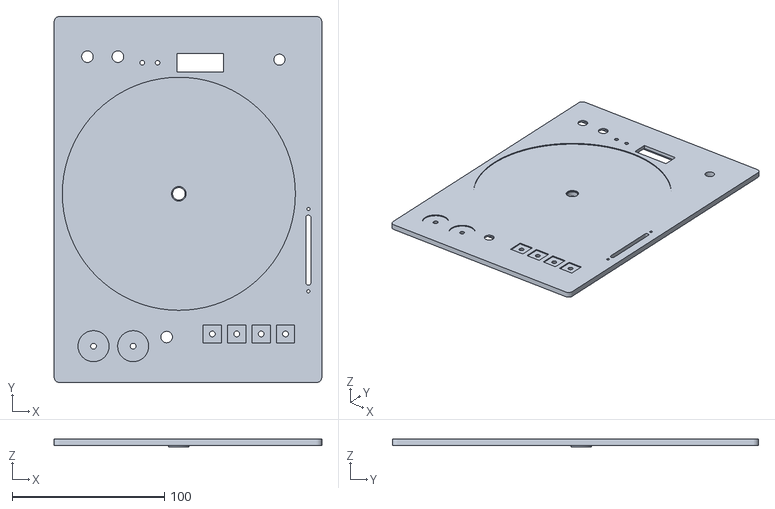
[picture p65: CAD file, 2026-11-08]
.vercel/output/static/field-jog/stl/wide-six-top.stl
175.7 x 240.2 x 5.30
