johnnyclem/EP-DJ3000/field-jog/stl/go-bottom.stl

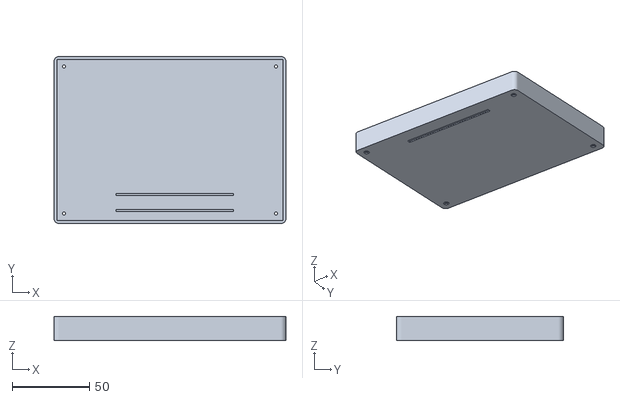
[picture p66: CAD file, 2026-11-13]
field-jog/stl/go-bottom.stl
150.0 x 108.0 x 15.6
