johnnyclem/EP-DJ3000/hardware/platter-test/stl/stand.stl

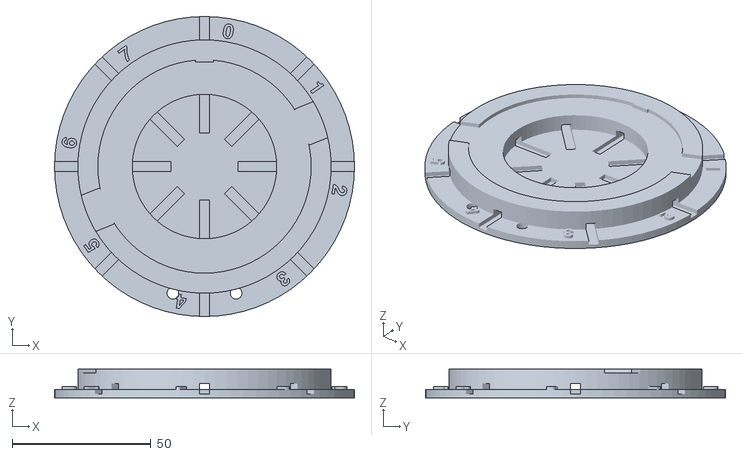
[picture p67: CAD file, 2026-11-05]
hardware/platter-test/stl/stand.stl
108.0 x 108.0 x 10.4
