johnnyclem/EP-DJ3000/public/field-jog/stl/go-pinion.stl

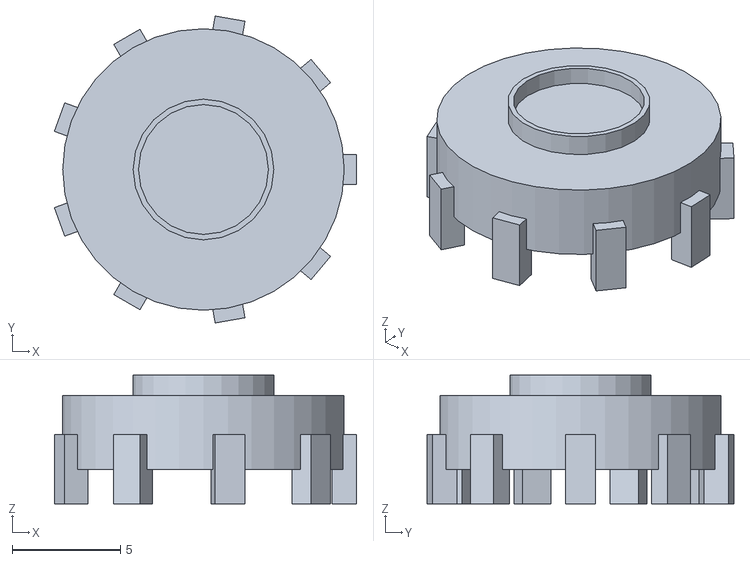
[picture p68: CAD file, 2026-11-13]
public/field-jog/stl/go-pinion.stl
14.0 x 14.2 x 5.95
