johnnyclem/EP-DJ3000/.vercel/output/static/field-jog/four/master.stl

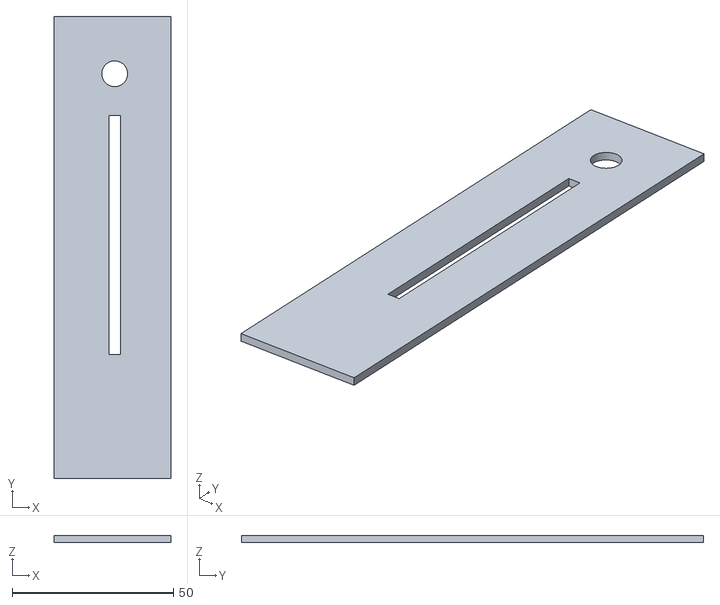
[picture p69: CAD file, 2026-11-06]
.vercel/output/static/field-jog/four/master.stl
36.1 x 143.2 x 2.20
