johnnyclem/EP-DJ3000/hardware/platter-test/stl/carrier.stl

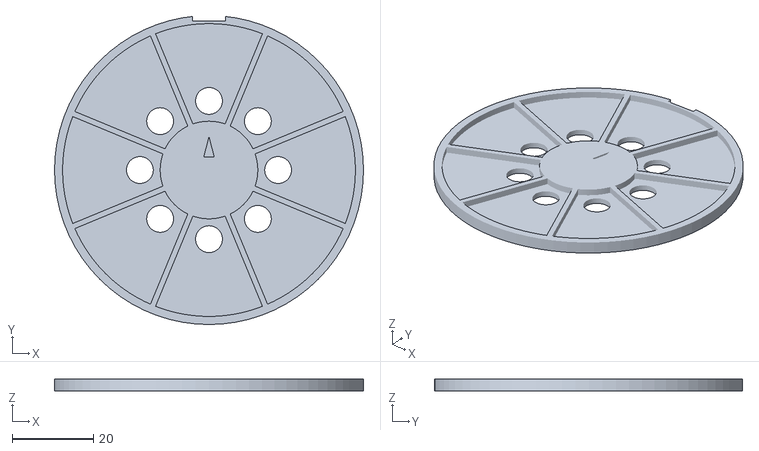
[picture p70: CAD file, 2026-11-05]
hardware/platter-test/stl/carrier.stl
76.0 x 75.8 x 3.00
