johnnyclem/EP-DJ3000/public/field-jog/stl/go-top.stl

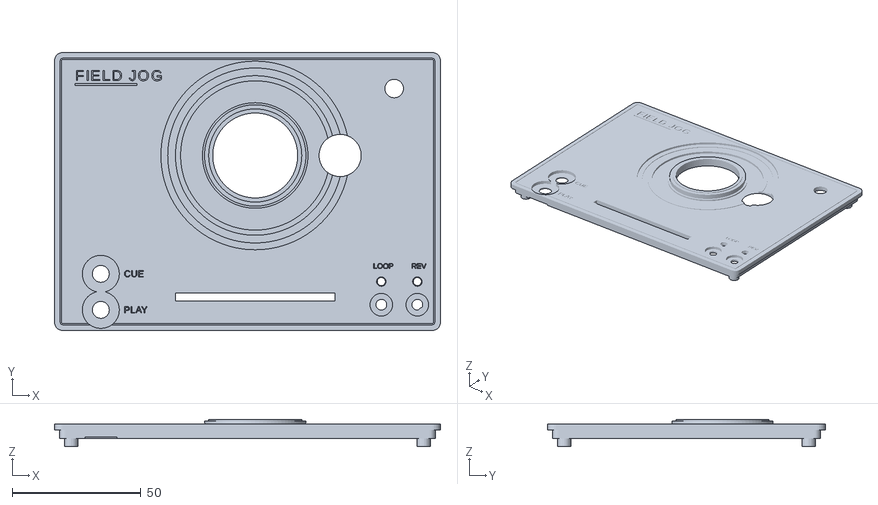
[picture p71: CAD file, 2026-11-13]
public/field-jog/stl/go-top.stl
150.0 x 108.0 x 10.5
