johnnyclem/EP-DJ3000/.vercel/output/static/field-jog/four/transport-l.stl

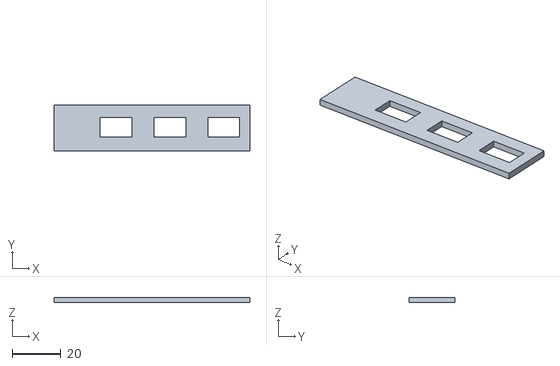
[picture p72: CAD file, 2026-11-06]
.vercel/output/static/field-jog/four/transport-l.stl
80.2 x 19.0 x 2.20
