johnnyclem/EP-DJ3000/.vercel/output/static/field-jog/stl/bottom.stl

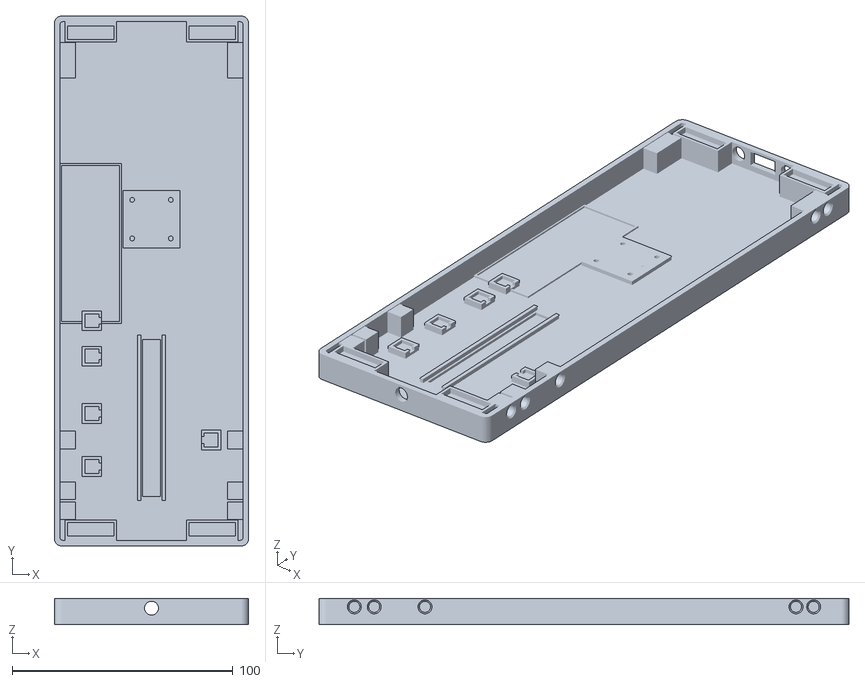
[picture p73: CAD file, 2026-11-07]
.vercel/output/static/field-jog/stl/bottom.stl
88.0 x 240.0 x 11.8
