johnnyclem/EP-DJ3000/.vercel/output/static/field-jog/four/ear-r.stl

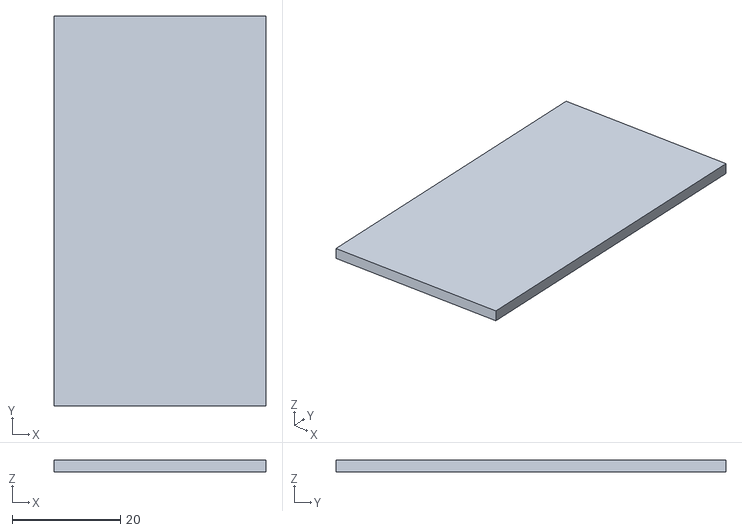
[picture p74: CAD file, 2026-11-06]
.vercel/output/static/field-jog/four/ear-r.stl
39.1 x 72.1 x 2.20
