johnnyclem/EP-DJ3000/.vercel/output/static/field-jog/stl/top.stl

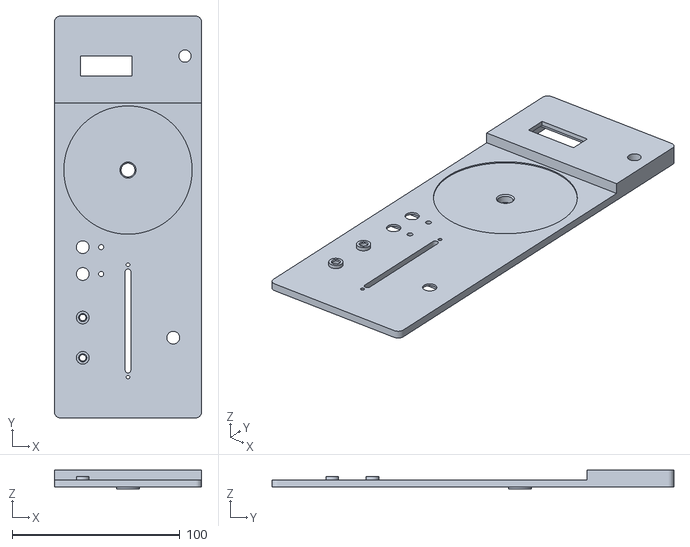
[picture p75: CAD file, 2026-11-07]
.vercel/output/static/field-jog/stl/top.stl
87.7 x 239.7 x 11.3
