johnnyclem/EP-DJ3000/.vercel/output/static/field-jog/four/faders-12.stl

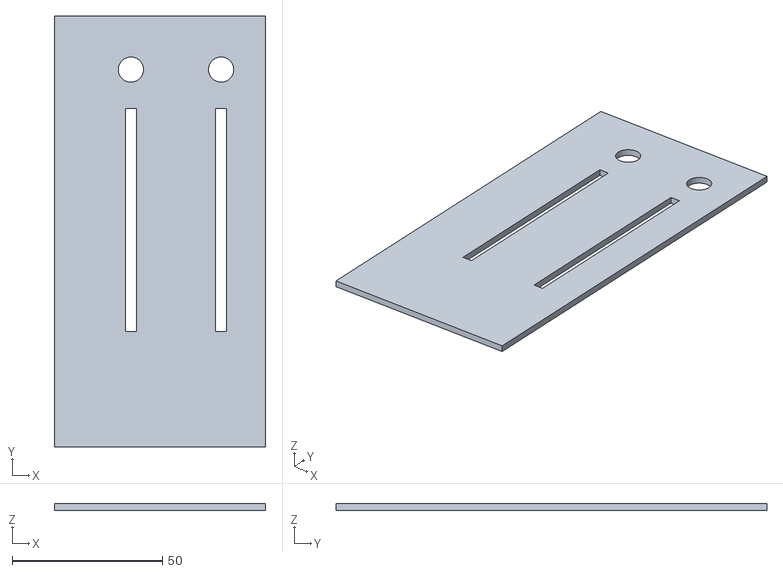
[picture p76: CAD file, 2026-11-06]
.vercel/output/static/field-jog/four/faders-12.stl
70.2 x 143.2 x 2.20
