johnnyclem/EP-DJ3000/.vercel/output/static/field-jog/stl/platter.stl

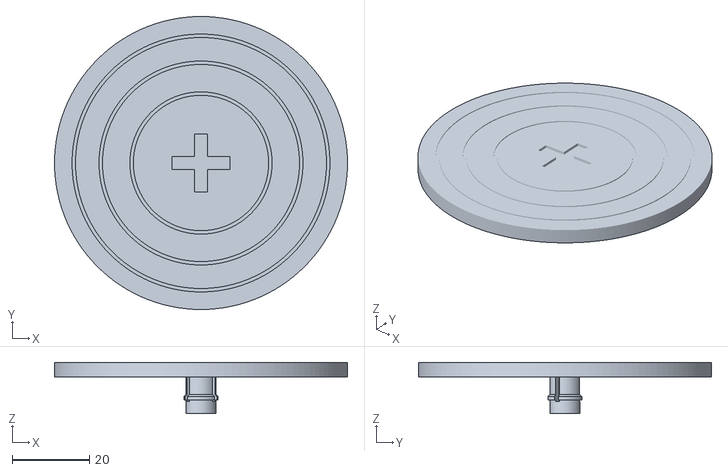
[picture p77: CAD file, 2026-11-06]
.vercel/output/static/field-jog/stl/platter.stl
76.0 x 76.0 x 13.4
