johnnyclem/EP-DJ3000/field-jog/stl/go-ring.stl

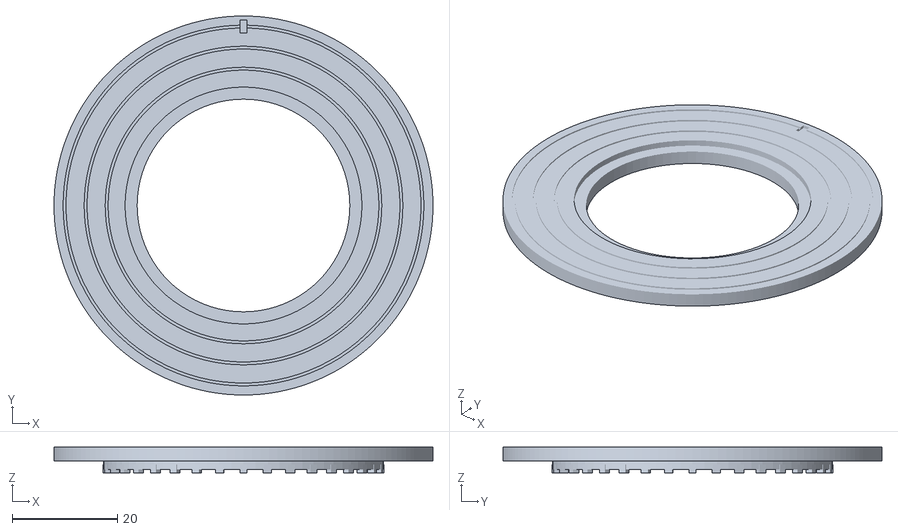
[picture p78: CAD file, 2026-11-13]
field-jog/stl/go-ring.stl
72.0 x 72.0 x 4.90
