johnnyclem/EP-DJ3000/.vercel/output/static/field-jog/four/transport-r.stl

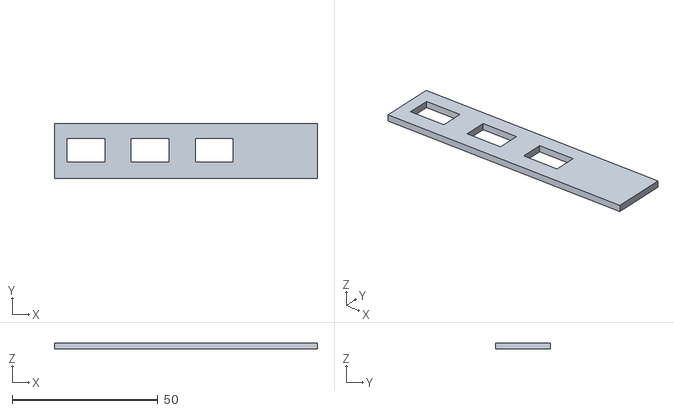
[picture p79: CAD file, 2026-11-06]
.vercel/output/static/field-jog/four/transport-r.stl
90.1 x 19.0 x 2.20
