johnnyclem/EP-DJ3000/.vercel/output/static/field-jog/stl/wide-six-platter.stl

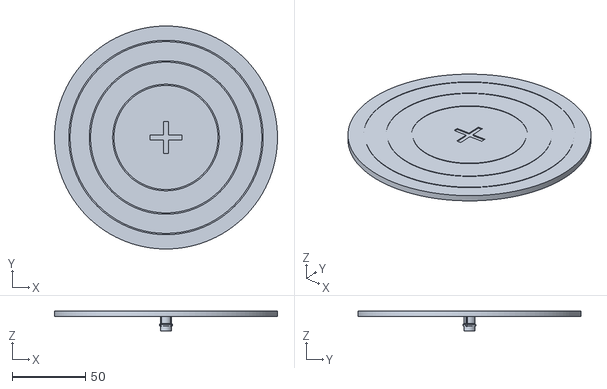
[picture p80: CAD file, 2026-11-06]
.vercel/output/static/field-jog/stl/wide-six-platter.stl
152.4 x 152.4 x 13.7
