johnnyclem/EP-DJ3000/public/field-jog/stl/go-cue.stl

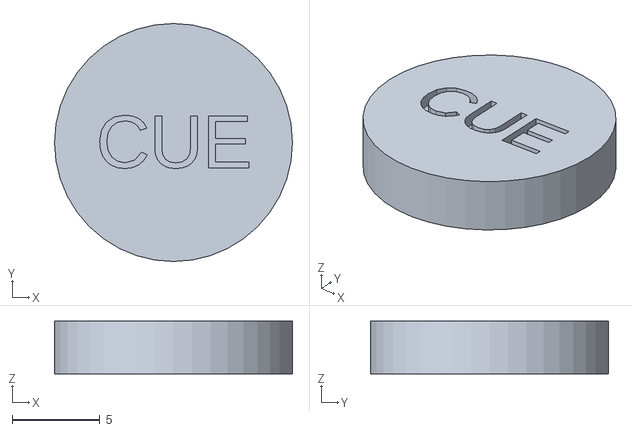
[picture p81: CAD file, 2026-11-13]
public/field-jog/stl/go-cue.stl
13.6 x 13.6 x 3.00
