johnnyclem/EP-DJ3000/.vercel/output/static/field-jog/four/rec.stl

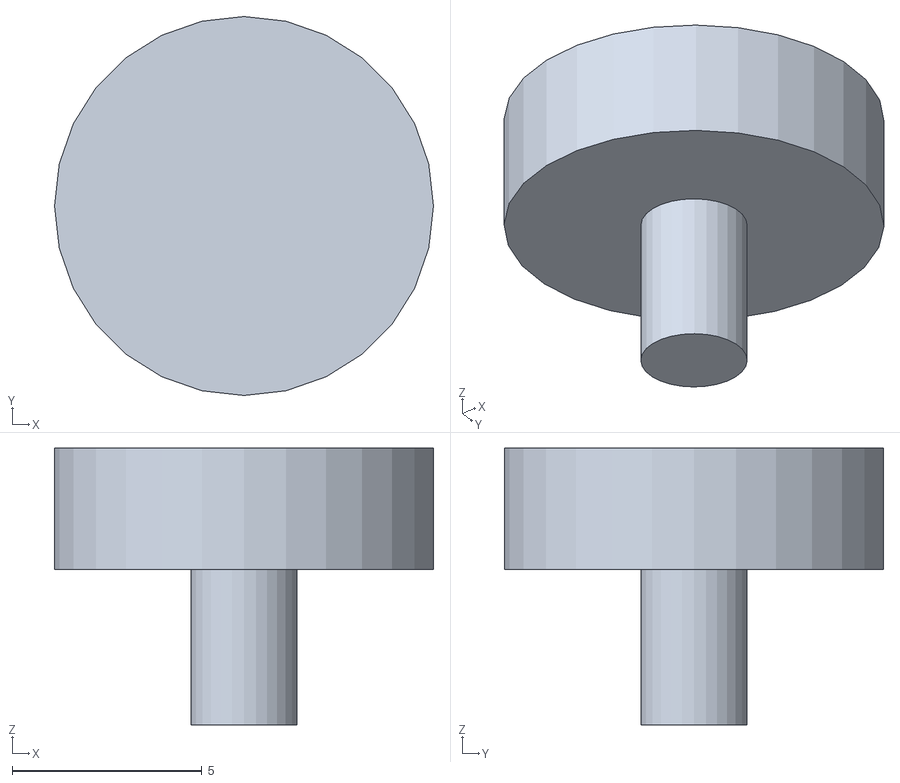
[picture p82: CAD file, 2026-11-06]
.vercel/output/static/field-jog/four/rec.stl
10.0 x 10.0 x 7.30
