johnnyclem/EP-DJ3000/.vercel/output/static/field-jog/stl/wide-twin-platter.stl

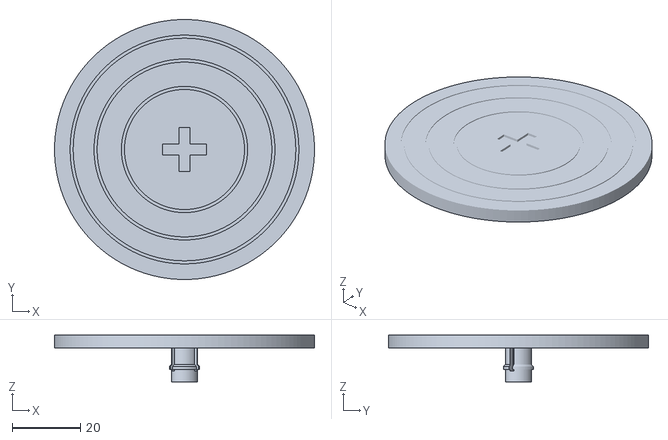
[picture p83: CAD file, 2026-11-06]
.vercel/output/static/field-jog/stl/wide-twin-platter.stl
76.0 x 76.0 x 13.7
