johnnyclem/EP-DJ3000/.vercel/output/static/field-jog/four/caps-plate.stl

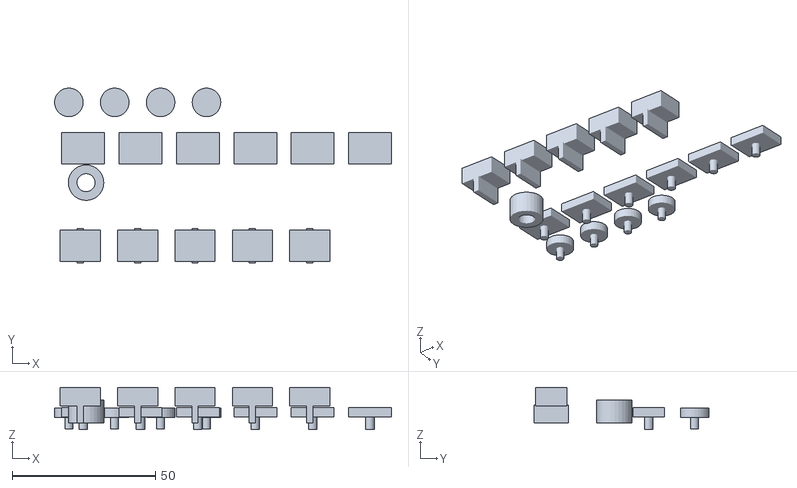
[picture p84: CAD file, 2026-11-06]
.vercel/output/static/field-jog/four/caps-plate.stl
117.5 x 61.0 x 14.8
