johnnyclem/EP-DJ3000/field-jog/stl/go-play.stl

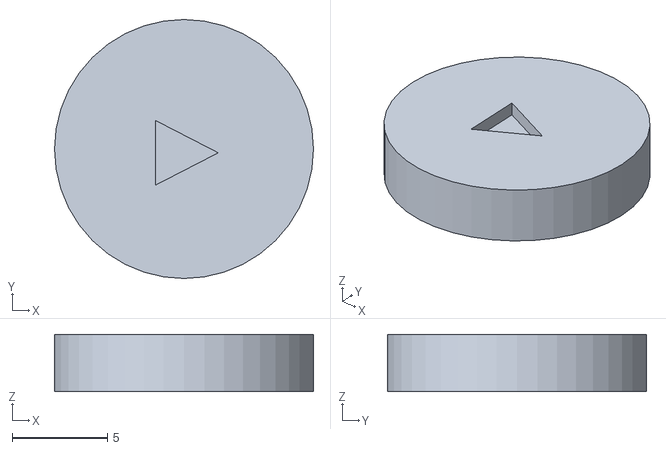
[picture p85: CAD file, 2026-11-12]
field-jog/stl/go-play.stl
13.6 x 13.6 x 3.00
