johnnyclem/EP-DJ3000/.vercel/output/static/field-jog/four/screen.stl

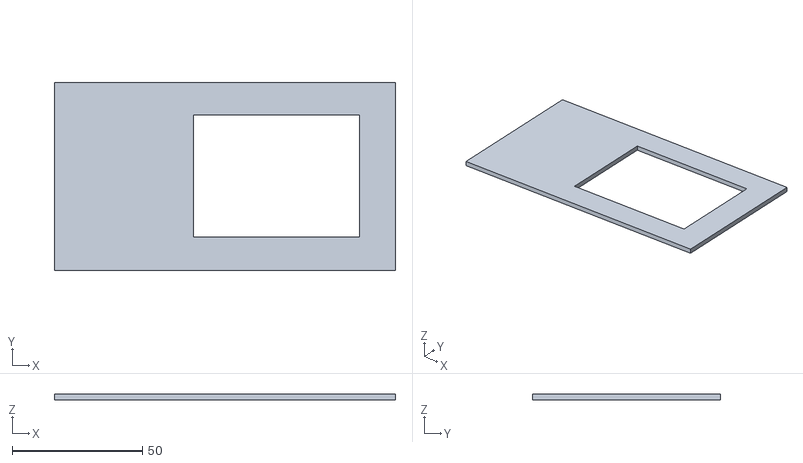
[picture p86: CAD file, 2026-11-06]
.vercel/output/static/field-jog/four/screen.stl
131.2 x 72.1 x 2.20
