johnnyclem/EP-DJ3000/.vercel/output/static/field-jog/stl/flange.stl

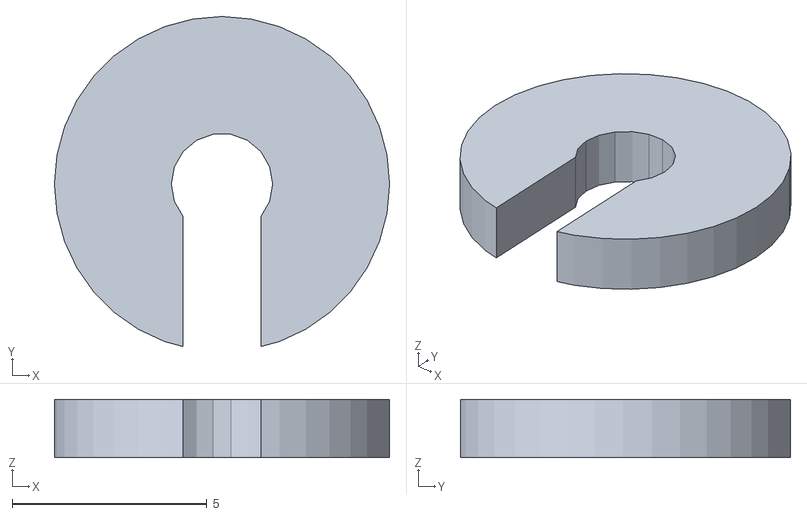
[picture p87: CAD file, 2026-11-04]
.vercel/output/static/field-jog/stl/flange.stl
8.60 x 8.47 x 1.50
