johnnyclem/EP-DJ3000/public/field-jog/stl/knob.stl

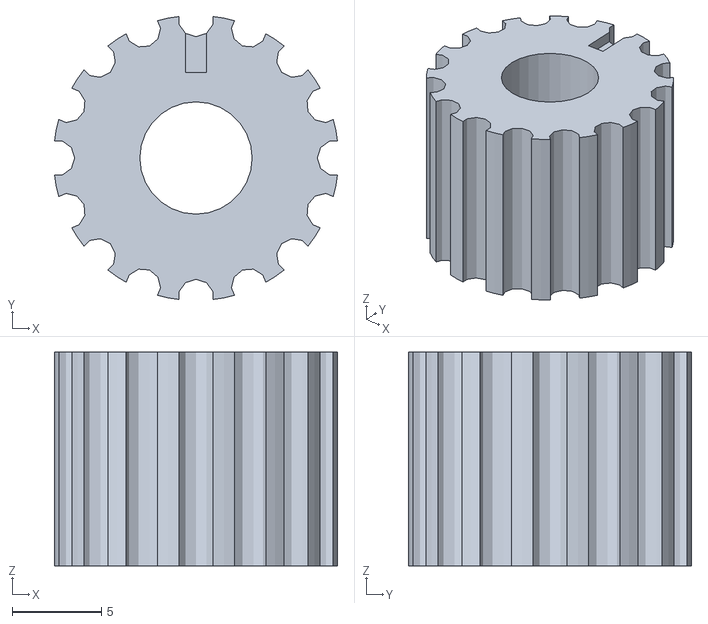
[picture p88: CAD file, 2026-11-10]
public/field-jog/stl/knob.stl
15.9 x 15.9 x 12.0
