johnnyclem/EP-DJ3000/.vercel/output/static/field-jog/four/knob.stl

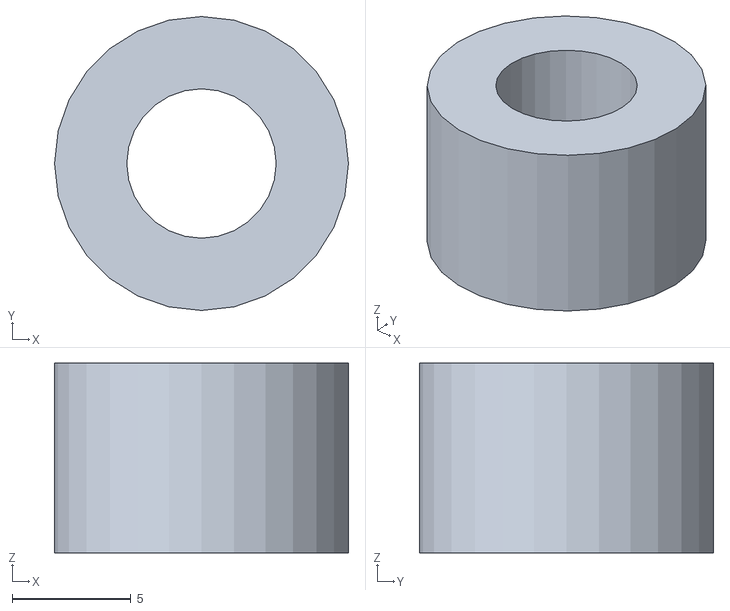
[picture p89: CAD file, 2026-11-06]
.vercel/output/static/field-jog/four/knob.stl
12.4 x 12.4 x 8.00
