johnnyclem/EP-DJ3000/.vercel/output/static/field-jog/stl/faceplate.stl

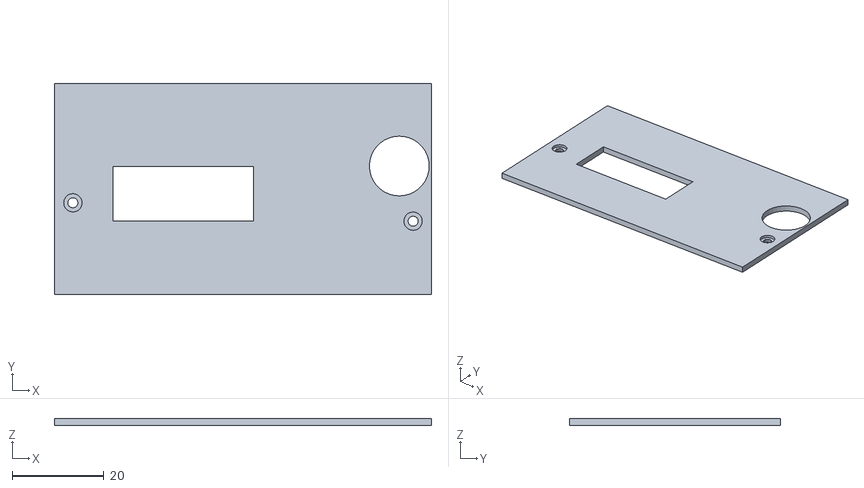
[picture p90: CAD file, 2026-11-04]
.vercel/output/static/field-jog/stl/faceplate.stl
82.0 x 46.0 x 1.60
