johnnyclem/EP-DJ3000/.vercel/output/static/field-jog/four/key.stl

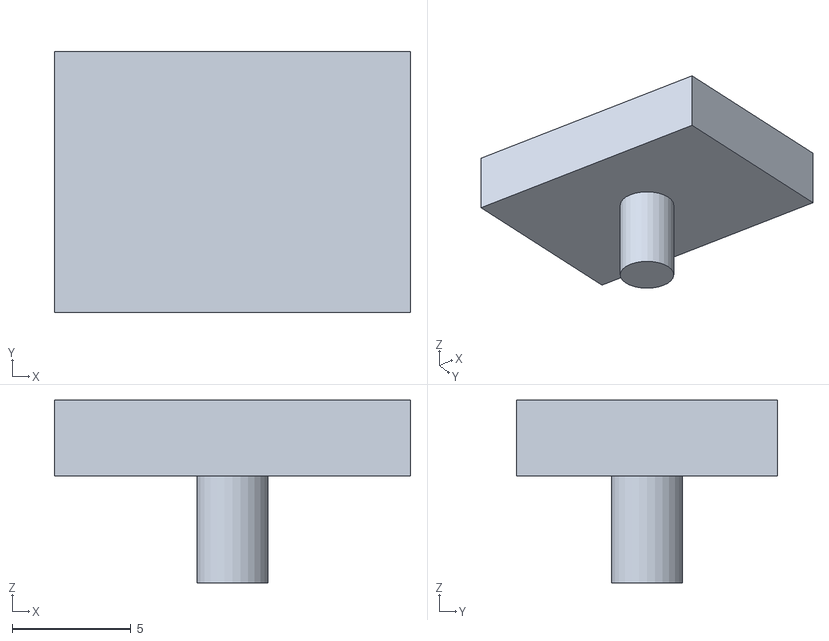
[picture p91: CAD file, 2026-11-06]
.vercel/output/static/field-jog/four/key.stl
15.0 x 11.0 x 7.70
