johnnyclem/EP-DJ3000/.vercel/output/static/field-jog/stl/fader.stl

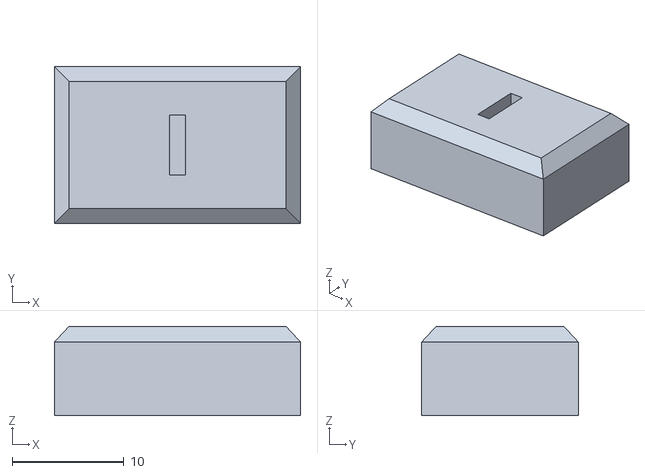
[picture p92: CAD file, 2026-11-04]
.vercel/output/static/field-jog/stl/fader.stl
22.0 x 14.0 x 8.00
