johnnyclem/EP-DJ3000/.vercel/output/static/field-jog/stl/foot.stl

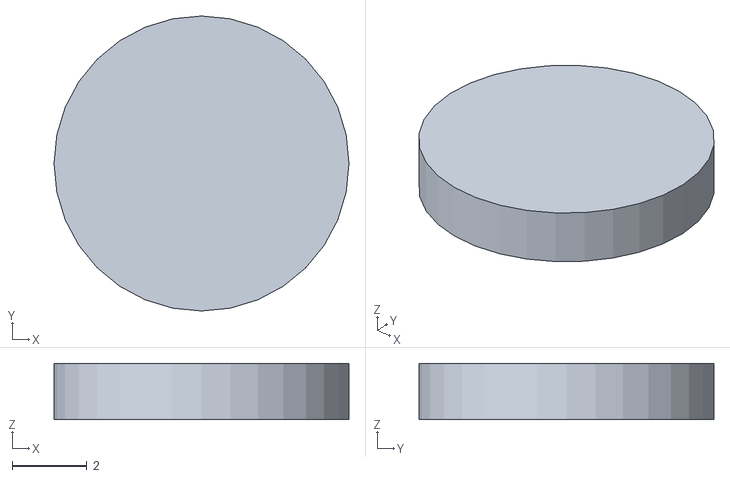
[picture p93: CAD file, 2026-10-31]
.vercel/output/static/field-jog/stl/foot.stl
7.90 x 7.90 x 1.50
