johnnyclem/EP-DJ3000/field-jog/stl/fader_lock.stl

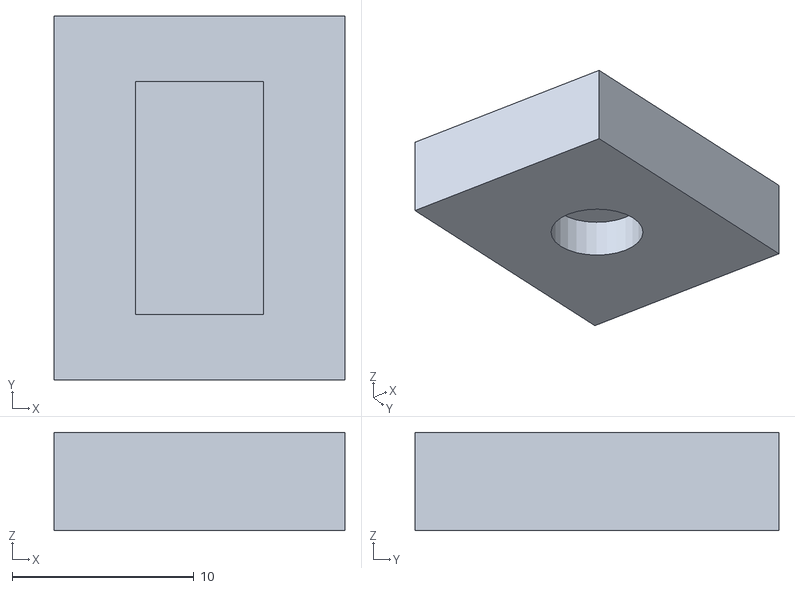
[picture p94: CAD file, 2026-11-10]
field-jog/stl/fader_lock.stl
16.0 x 20.0 x 5.40
