johnnyclem/EP-DJ3000/.vercel/output/static/field-jog/stl/bar.stl

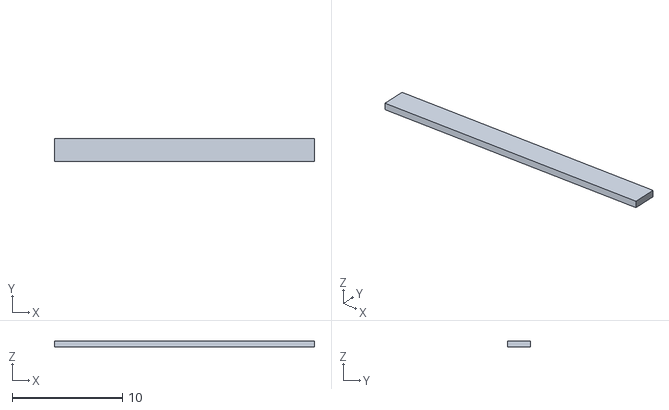
[picture p95: CAD file, 2026-10-31]
.vercel/output/static/field-jog/stl/bar.stl
23.6 x 2.05 x 0.55
