johnnyclem/EP-DJ3000/.vercel/output/static/field-jog/stl/plus.stl

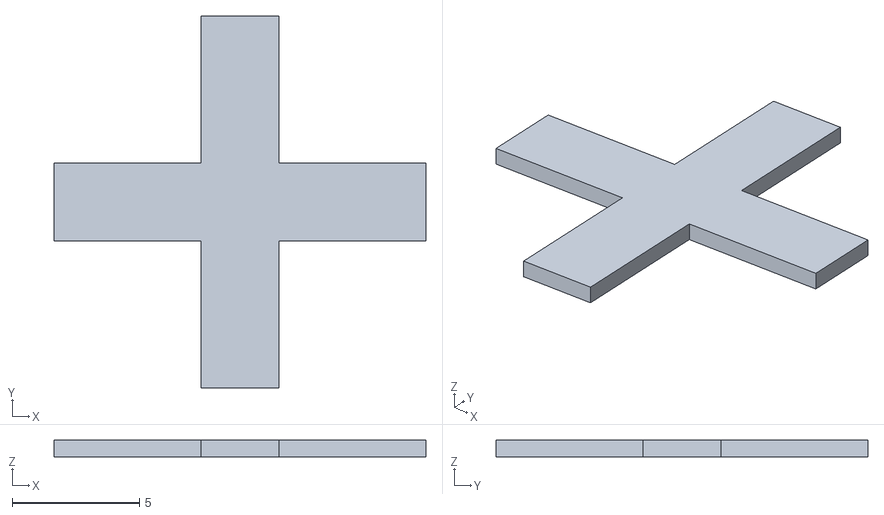
[picture p96: CAD file, 2026-10-31]
.vercel/output/static/field-jog/stl/plus.stl
14.6 x 14.6 x 0.65
