johnnyclem/EP-DJ3000/.vercel/output/static/field-jog/stl/tab.stl

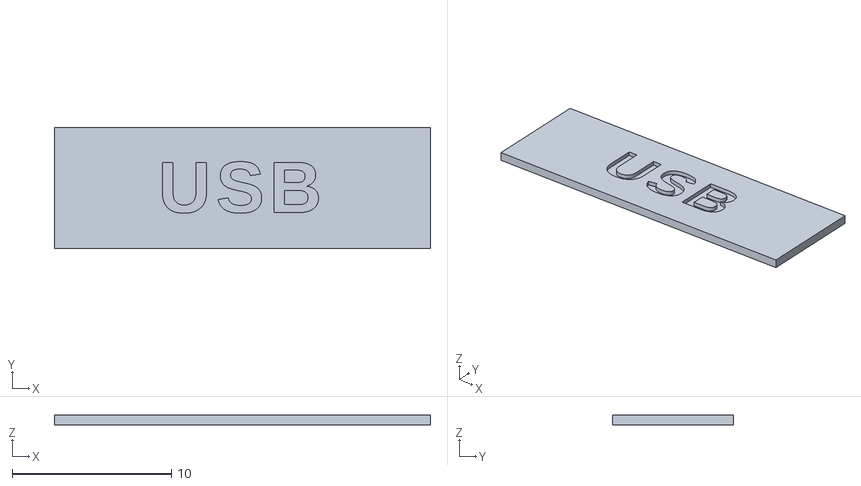
[picture p97: CAD file, 2026-10-31]
.vercel/output/static/field-jog/stl/tab.stl
23.6 x 7.60 x 0.6
