johnnyclem/EP-DJ3000/field-jog/stl/carry-bottom.stl

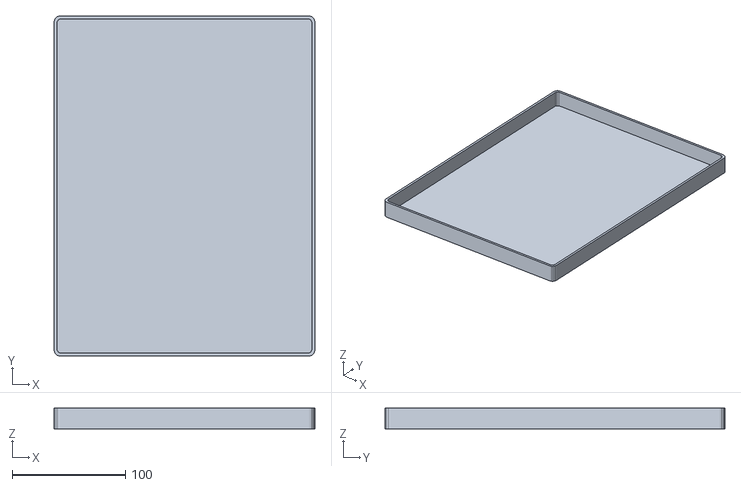
[picture p98: CAD file, 2026-11-10]
field-jog/stl/carry-bottom.stl
230.0 x 300.0 x 18.4
