johnnyclem/EP-DJ3000/public/field-jog/stl/carry-top.stl

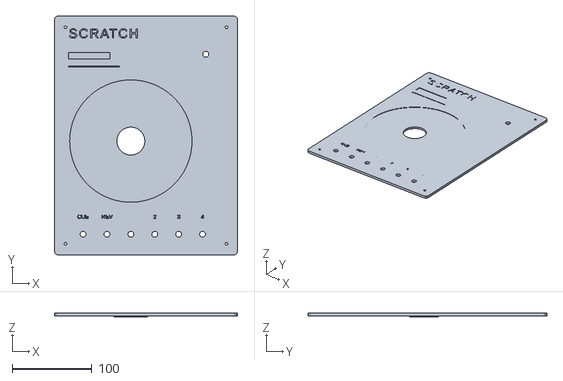
[picture p99: CAD file, 2026-11-10]
public/field-jog/stl/carry-top.stl
230.0 x 300.0 x 4.80
