johnnyclem/EP-DJ3000/field-jog/stl/carry-ring.stl

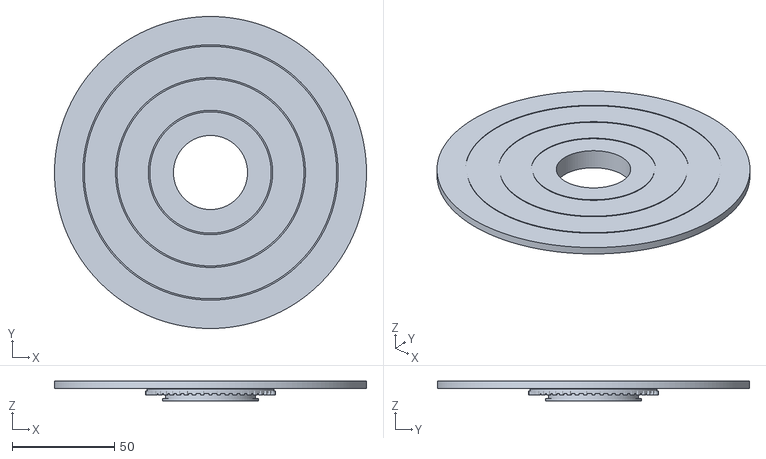
[picture p100: CAD file, 2026-11-10]
field-jog/stl/carry-ring.stl
152.4 x 152.4 x 9.60
