johnnyclem/EP-DJ3000/public/field-jog/stl/carry-knob.stl

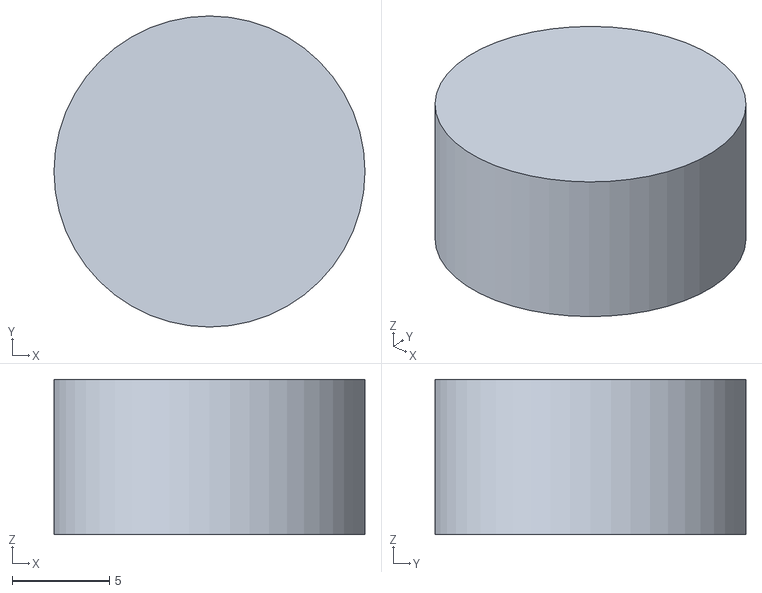
[picture p101: CAD file, 2026-11-10]
public/field-jog/stl/carry-knob.stl
16.0 x 16.0 x 8.00
