johnnyclem/EP-DJ3000/public/field-jog/stl/carry-pinion.stl

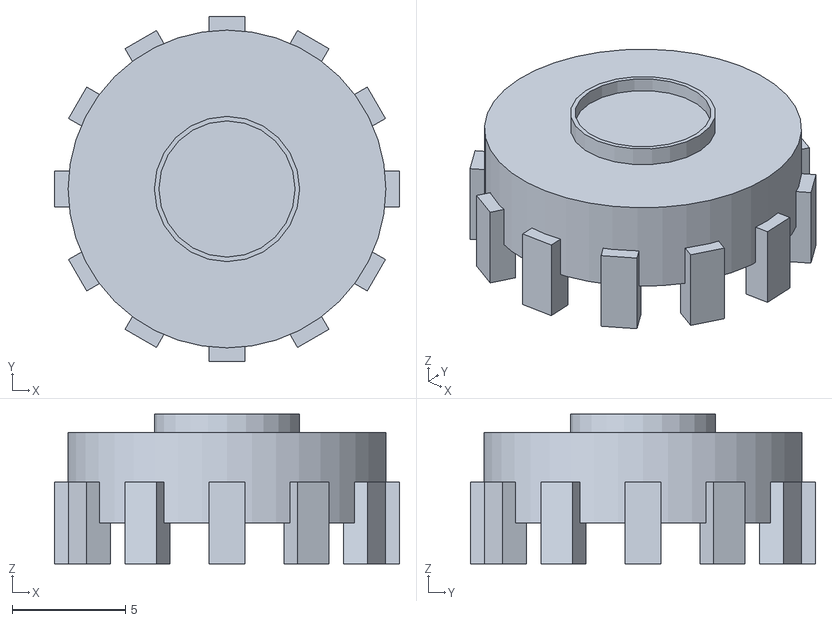
[picture p102: CAD file, 2026-11-10]
public/field-jog/stl/carry-pinion.stl
15.2 x 15.2 x 6.60
