johnnyclem/EP-DJ3000/field-jog/stl/v5.3mf

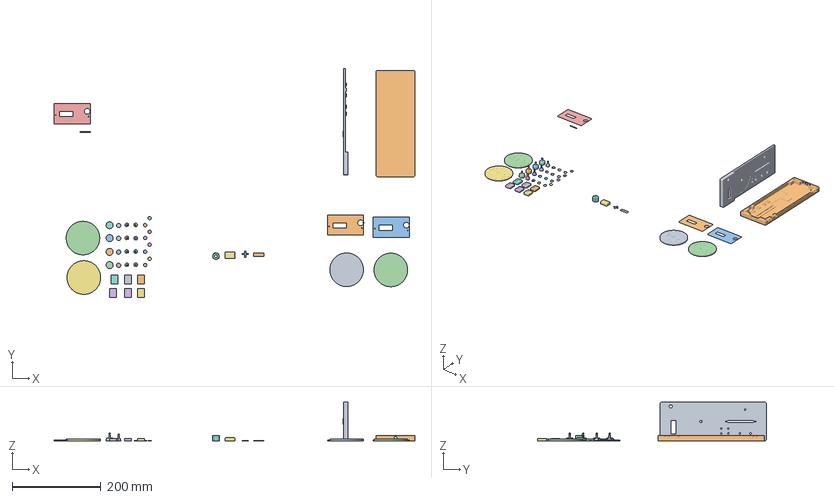
[picture p103: CAD file, 2026-11-06]
field-jog/stl/v5.3mf
815.0 x 516.3 x 87.7 mm
top.stl
bottom.stl
button.stl x 4
platter.stl x 4
faceplate.stl x 3
fader_lock.stl x 6
fader.stl
knob.stl
loop.stl x 4
tab.stl
plus.stl
bar.stl
flange.stl x 8
foot.stl x 8
