johnnyclem/EP-DJ3000/field-jog/stl/long-print.3mf

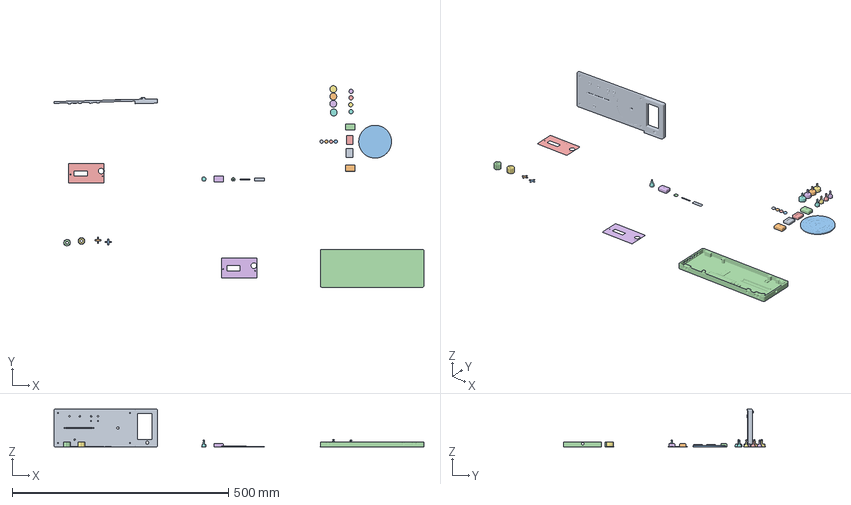
[picture p104: CAD file, 2026-11-05]
field-jog/stl/long-print.3mf
856.4 x 466.7 x 87.7 mm
top.stl
button.stl x 4
platter.stl
bottom.stl
fader_lock.stl x 2
fader.stl x 3
knob.stl x 2
loop.stl x 5
tab.stl
plus.stl x 2
bar.stl
flange.stl
foot.stl x 4
Assembly x 2
