johnnyclem/EP-DJ3000/(list of files, cad)

Other CAD files:
.vercel/output/static/field-jog/stl/wide-twin-bottom.stl
.vercel/output/static/field-jog/stl/button.stl
field-jog/stl/platter.stl
.vercel/output/static/field-jog/stl/loop.stl
public/field-jog/stl/bottom.stl
field-jog/stl/flange.stl
public/field-jog/stl/flange.stl
field-jog/stl/faceplate.stl
public/field-jog/stl/fader.stl
.vercel/output/static/field-jog/stl/knob.stl
public/field-jog/stl/platter.stl
.vercel/output/static/field-jog/stl/fader_lock.stl
field-jog/stl/bottom.stl
public/field-jog/stl/faceplate.stl
field-jog/stl/fader.stl
public/field-jog/stl/top.stl
field-jog/stl/top.stl
public/field-jog/stl/wide-twin-platter.stl
public/field-jog/stl/wide-twin-bottom.stl
field-jog/stl/wide-twin-top.stl
public/field-jog/stl/wide-six-bottom.stl
field-jog/stl/wide-twin-bottom.stl
public/field-jog/stl/wide-six-top.stl
field-jog/stl/wide-six-top.stl
public/field-jog/stl/wide-six-platter.stl
field-jog/stl/wide-twin-platter.stl
field-jog/stl/wide-six-platter.stl
public/field-jog/stl/wide-twin-top.stl
field-jog/stl/wide-six-bottom.stl
.vercel/output/static/field-jog/field-jog.scad
.vercel/output/static/field-jog/wide.scad
.vercel/output/static/field-jog/button.stl
.vercel/output/static/field-jog/loop.stl
field-jog/stl/v4.3mf
