johnnyclem/EP-DJ3000/screenshots/app-builder-built-mobile.png

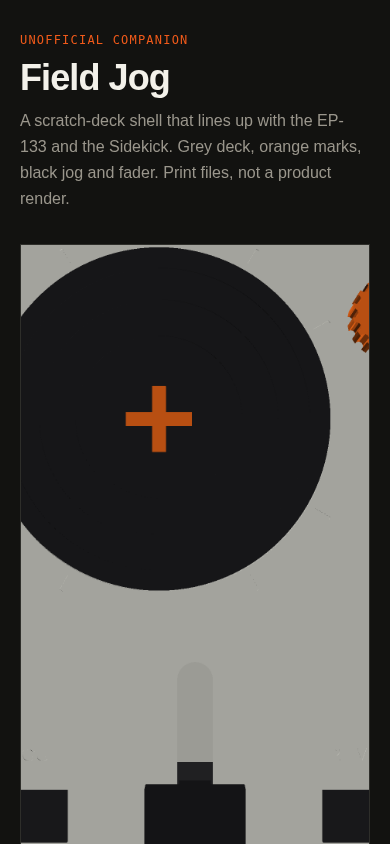
screenshots/app-builder-built-mobile.png
