johnnyclem/EP-DJ3000/screenshots/app-builder-preview-mobile.png

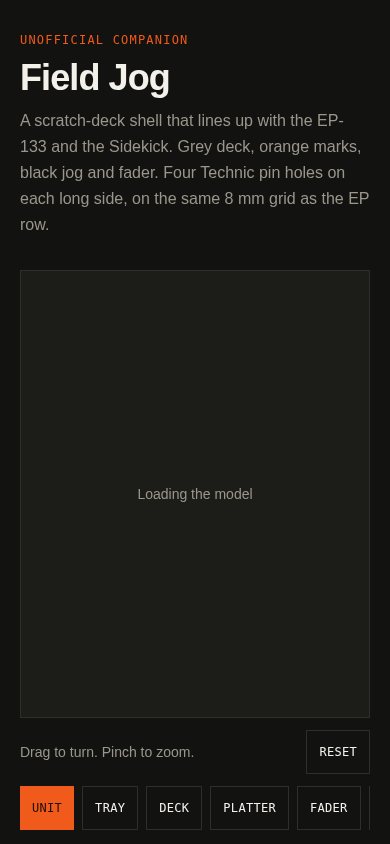
screenshots/app-builder-preview-mobile.png
