johnnyclem/EP-DJ3000/screenshots/app-builder-preview.png

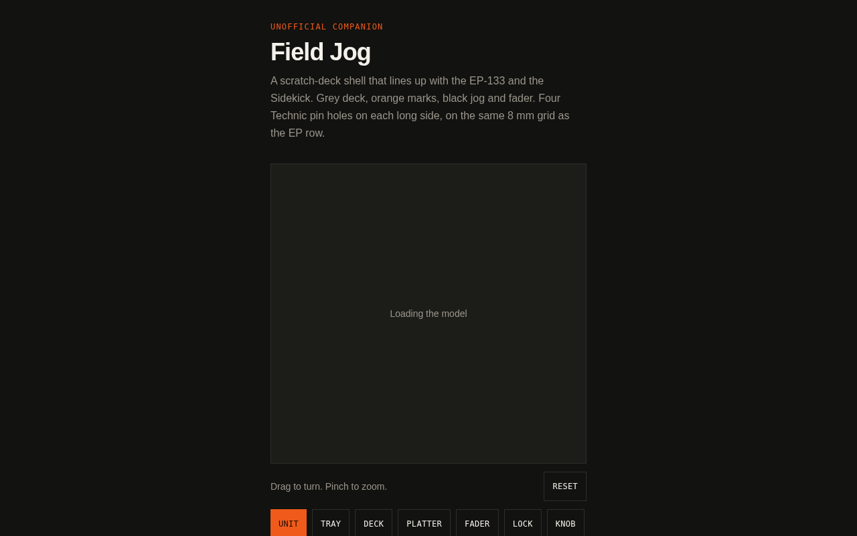
screenshots/app-builder-preview.png
