johnnyclem/EP-DJ3000/hardware/platter-test/preview/section.png

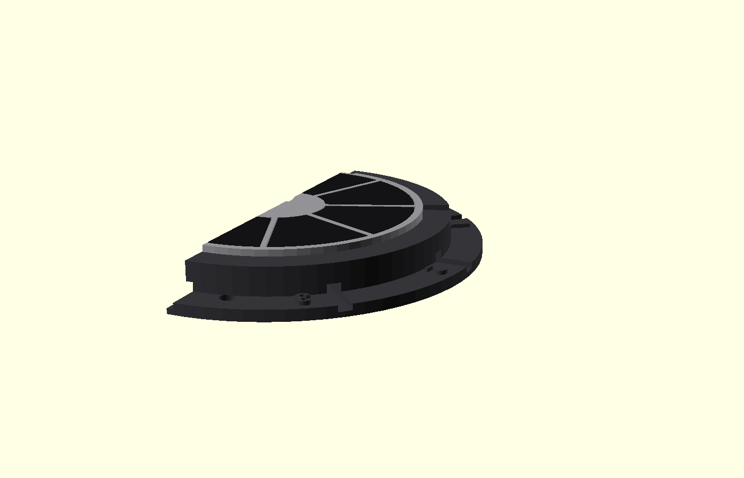
hardware/platter-test/preview/section.png
