johnnyclem/EP-DJ3000/hardware/platter-test/preview/top.png

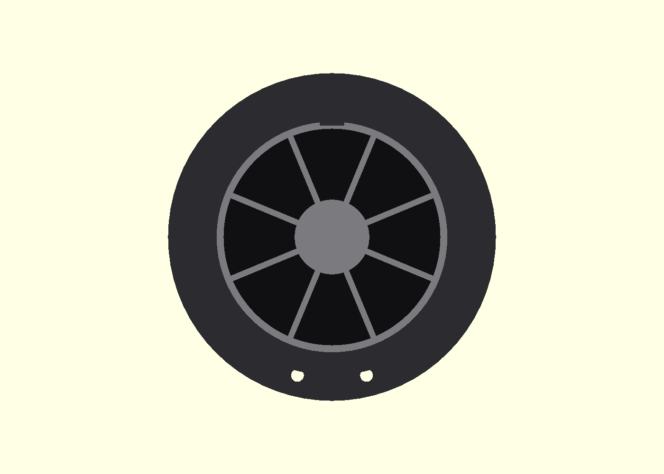
hardware/platter-test/preview/top.png
