johnnyclem/EP-DJ3000/hardware/platter-test/preview/wedges.png

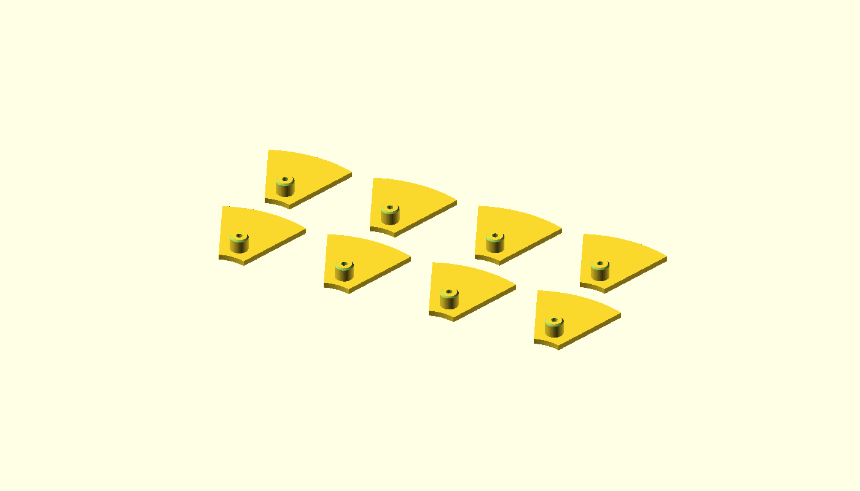
hardware/platter-test/preview/wedges.png
