johnnyclem/EP-DJ3000/firmware/esp32s3/main/main.cpp

/*
 * EP-DJ3000 firmware for the ESP32-S3: boots the hardware, then hands everything to the portable engine
 * (firmware/core) which runs on one task.
 *
 * THREADING MODEL
 * ---------------
 *   task            core  prio  what it does
 *   engine           1     24   every 1 ms: drain input queues -> sample AS5600/ADC/touch/buttons -> Engine::step()
 *                               -> deliver Engine output (USB, TRS, radio) -> LED. The ONLY caller of the core.
 *   tinyusb          1     22   esp_tinyusb's tud_task(): enumeration, control requests (USB audio volume/mute),
 *                               MIDI endpoint servicing. Its callbacks only copy into queues or atomics.
 *   audio            0     22   one 48-frame block per ms: ring -> drift compensator -> volume/tone -> I2S. Paced by
 *                               i2s_channel_write blocking on the DMA ring; computes the USB audio feedback value.
 *   link             0     21   paces ESP-NOW sends (one in flight, waits for the send callback).
 *   trs_rx           0     20   UART1 events -> time-stamped byte chunks.
 *   diag             0      3   the only task that prints in steady state.
 *   (IDF) Wi-Fi 23, esp_timer 22 (restart timer), main task (this function) exits after boot.
 *   interrupts: USB OTG (on the TinyUSB task's core), I2S DMA, UART1, RMT.
 *
 *   What crosses a task boundary, and how
 *     input to the engine   every producer time-stamps at RECEIPT (esp_timer) and pushes to its own FreeRTOS queue;
 *                           the engine task pops a bounded number per millisecond.
 *                             USB MIDI   TinyUSB task, tud_midi_rx_cb        -> usb_dev::popRx
 *                             TRS MIDI   trs_rx task, UART event             -> TrsMidi::pop
 *                             radio      Wi-Fi task, ESP-NOW recv callback   -> radio::pop
 *     output of the engine  USB: tud_midi_n_packet_write straight from the engine task (TinyUSB serialises endpoint
 *                           access with a priority-inheriting mutex; the pattern its own FreeRTOS examples use). A full
 *                           FIFO keeps ONE event in hand and retries next tick; after 100 ms it is dropped, and from then
 *                           on USB is "stalled": later events are dropped on their first refused packet instead of each
 *                           waiting 100 ms, so a host that does not read the port never slows TRS or the radio (output_pump.h).
 *                           TRS: UART TX ring, never blocks (drops when full). Radio: radio::send -> tx queue -> link task.
 *     USB audio             USB interrupt -> lock-free SPSC ring (no float, no locks) -> audio task. Feedback goes back
 *                           as one 32-bit store (tud_audio_n_fb_set). Float is used only in tasks: the S3 does not allow
 *                           FPU instructions in interrupts.
 *     engine <-> audio      atomics only (test tone request, volume, streaming flag).
 *
 *   Pacing: the engine task sleeps until the next 1 ms tick every iteration; after an overrun of more than two ticks
 *   the lost ticks are dropped rather than caught up (tick_pacing.h), so it can never run without sleeping and starve the
 *   TinyUSB task (same core, lower priority), IDLE1 or the watchdog. ADC conversions run with interrupts off and the
 *   AS5600 read waits on the I2C driver; both are timed at boot and together kept under 400 us of each millisecond
 *   (hal/sensor_budget.h; the ADC oversampling gives way to the I2C read).
 *
 *   Priority inversion: the engine task is the highest application priority but waits on nothing a lower task can hold
 *   except TinyUSB's endpoint mutex (inheritance, critical sections of microseconds). Every queue operation it makes is
 *   non-blocking, the UART write checks for room first, and it does not log in normal operation (only when a reboot or
 *   deck swap is requested). The audio task blocks only on the I2S DMA.
 *
 *   Known stall: a flash write (NVS save on SAVE_CONFIG / SET_DECK) disables the flash cache for its duration. The USB
 *   interrupt handler is not in IRAM, so USB audio can glitch and one or more engine ticks run late while a save is in
 *   progress. Saves are user-initiated; nothing in normal playing writes flash.
 */

#include <cstdio>
#include <cstring>
#include <new>

#include "device_platform.h"
#include "diag_task.h"
#include "engine_task.h"
#include "epdj/config.h"
#include "epdj/engine.h"
#include "epdj/protocol.h"
#include "epdj/version.h"
#include "epdj_audio/audio_out.h"
#include "epdj_hal/dac_detect.h"
#include "epdj_hal/board_pins.h"
#include "epdj_hal/i2c_bus.h"
#include "epdj_hal/oled.h"
#include "epdj_hal/twin_io.h"
#include "epdj_hal/twin_pins.h"
#include "epdj_sd/sd_card.h"
#include "epdj_hal/nvs_store.h"
#include "epdj_hal/sensor_budget.h"
#include "epdj_link/radio.h"
#include "epdj_usb/usb_device.h"
#include "esp_idf_version.h"
#include "esp_log.h"
#include "esp_random.h"
#include "freertos/FreeRTOS.h"
#include "freertos/task.h"
#include "sdkconfig.h"

using namespace epdj;

namespace {

const char* TAG = "main";

hal::NvsConfigStore g_store;
Config g_cfg;
hal::TouchPads g_touch;
hal::AdcInputs g_adc;
hal::ButtonPins g_buttons;
hal::I2cBus g_i2c;
hal::I2cBus g_i2cB;
hal::As5600 g_as5600;
hal::TwinIo g_twin;
hal::TrsMidi g_trs;
hal::StatusLed g_led;
app::DevicePlatform g_platform(g_store);
app::Runtime g_rt;
alignas(Engine) uint8_t g_engineStorage[sizeof(Engine)];  // constructed once the identity is known; never freed

const char* loadStatusText(LoadStatus s) {
  switch (s) {
    case LoadStatus::Ok: return "ok";
    case LoadStatus::Repaired: return "ok, some out-of-range values reset";
    case LoadStatus::Empty: return "nothing saved";
    case LoadStatus::BadLength: return "bad length";
    case LoadStatus::BadMagic: return "bad magic";
    case LoadStatus::BadVersion: return "written by another firmware version";
    case LoadStatus::BadCrc: return "bad CRC";
  }
  return "?";
}

const char* platterText(proto::PlatterSource s) {
  switch (s) {
    case proto::PlatterSource::As5600: return "AS5600";
    case proto::PlatterSource::TouchRing: return "TOUCH_RING (experimental)";
    case proto::PlatterSource::TouchHoldOnly: return "TOUCH_HOLD_ONLY";
  }
  return "?";
}

// What the platter sensing found, in one line, then a WARN for each thing that will make the platter misbehave.
// Needs the config, the I2C bus, the AS5600 and the touch pads to be initialised.
void logPlatter() {
  using hal::sensor_budget::Magnet;
  const auto source = static_cast<proto::PlatterSource>(g_cfg.get(proto::ConfigKey::PlatterSource));
  const bool encoder = g_as5600.present();
  const unsigned pads = g_touch.count();

  char enc[200];
  if (encoder) {
    std::snprintf(enc, sizeof enc, "MT6701 answered at 0x%02X, 14-bit angle reg 0x%02X (top 12 bits), read %u us",
                  hal::As5600::kAddress, static_cast<unsigned>(hal::As5600::angleRegister()), g_as5600.readUs());
  } else {
    std::snprintf(enc, sizeof enc, "MT6701 NOT answering at 0x%02X (SDA GPIO%d, SCL GPIO%d)%s", hal::As5600::kAddress,
                  pins::kI2cSda, pins::kI2cScl, g_as5600.canRetry() ? ", asking again every 500 ms" : "");
  }
  ESP_LOGI(TAG, "platter: source %s | %s | touch pads wired: %u%s", platterText(source), enc, pads,
           pads == 1 ? " (GPIO4 = hold pad)" : (pads == 0 ? " (no hold pad)" : ""));

  if (source == proto::PlatterSource::As5600 && !encoder) {
#if CONFIG_EPDJ_AS5600_ENABLE
    const char* why = !g_i2c.ok() ? "the I2C bus did not start" : "nothing ACKed the address";
#else
    const char* why = "the AS5600 probe is compiled out (EPDJ_AS5600_ENABLE is off)";
#endif
    if (g_as5600.canRetry()) {
      ESP_LOGW(TAG, "!!! platterSource is AS5600 but no encoder answered (%s): JOG IS SILENT until one does. It is asked again every 500 ms, "
                    "so fixing the wiring is enough, no reboot. Check the I2C wiring (SDA GPIO%d, SCL GPIO%d, 3V3, GND). "
                    "The chip is an MT6701 at 0x06. Leave Analog/PWM open. Magnet gap is about 1 mm off the SOP-8 !!!",
               why, pins::kI2cSda, pins::kI2cScl);
    } else {
      ESP_LOGW(TAG, "!!! platterSource is AS5600 but no encoder answered (%s): JOG WILL BE SILENT. Check the I2C wiring (SDA GPIO%d, SCL GPIO%d, "
                    "3V3, GND). The chip is an MT6701 at 0x06. Leave Analog/PWM open. Then reboot !!!",
               why, pins::kI2cSda, pins::kI2cScl);
    }
  }
  if (encoder && hal::As5600::writesConf() && !g_as5600.confOk()) {
    if (g_as5600.confKnown()) {
      ESP_LOGW(TAG, "AS5600 CONF reads back 0x%04X after writing 0x%04X: the chip did not take the filter settings (a burned configuration "
                    "or a bus fault). Jog still works with whatever the chip does",
               static_cast<unsigned>(g_as5600.conf()), static_cast<unsigned>(hal::as5600::kScratchConfWord));
    } else {
      ESP_LOGW(TAG, "AS5600 CONF could not be written or read back (I2C error): the filter settings are whatever the chip powered up with");
    }
  }
  if (encoder && hal::As5600::reportsMagnet() && g_as5600.magnet() != Magnet::Ok) {
    ESP_LOGW(TAG, "AS5600 magnet %s (STATUS 0x%02X): %s", hal::sensor_budget::magnetText(g_as5600.magnet()), g_as5600.status(),
             g_as5600.magnet() == Magnet::TooStrong ? "move it away from the chip (gap 1-3 mm)"
             : g_as5600.magnet() == Magnet::Unknown ? "the status register could not be read"
                                                    : "move it closer, centre it on the chip, and check it is diametrically magnetised");
  }
  if (encoder && source != proto::PlatterSource::As5600) {
    ESP_LOGW(TAG, "an encoder answered but platterSource is %s, so it is ignored (a config saved before contract v1.3 keeps "
                  "TOUCH_RING: LOAD_DEFAULTS and SAVE_CONFIG, or set platterSource 0)",
             platterText(source));
  }
  if (source == proto::PlatterSource::As5600 && pads == 0) {
    ESP_LOGW(TAG, "no hold pad wired (EPDJ_TOUCH_PAD_COUNT = 0): the unit never sends a touch note, so DJ apps never enter scratch mode");
  }
  if (source == proto::PlatterSource::As5600) {
    const auto policy = static_cast<proto::JogUntouched>(g_cfg.get(proto::ConfigKey::JogUntouched));
    const char* what = policy == proto::JogUntouched::Report    ? "REPORT: always sent"
                       : policy == proto::JogUntouched::Suppress ? "SUPPRESS: never sent"
                       : pads > 0 ? "AUTO: sent until the hold pad registers a touch, then NOT sent"
                                  : "AUTO: sent, no hold pad configured";
    ESP_LOGI(TAG, "jog: platter motion with no hand on it is %s", what);
  }
  if (source == proto::PlatterSource::TouchRing && pads < 3) {
    ESP_LOGW(TAG, "platterSource is TOUCH_RING but only %u pad(s) are wired: touch works, finger angle does not", pads);
  }
}

}  // namespace

extern "C" void app_main(void) {
  ESP_LOGI(TAG, "EP-DJ3000 core %d.%d.%d, protocol v%u, ESP-IDF %s", kVersionMajor, kVersionMinor, kVersionPatch,
           static_cast<unsigned>(proto::kProtocolVersion), esp_get_idf_version());

  // ---- configuration ----
  if (!g_store.begin()) ESP_LOGE(TAG, "NVS unavailable: running on defaults, nothing can be saved");
  const LoadStatus ls = loadConfig(g_store, &g_cfg);
  if (ls == LoadStatus::Empty) app::applyFirstBootDefaults(&g_cfg);
#if CONFIG_EPDJ_TWIN
  if (g_cfg.deck() != proto::Deck::A) {
    g_cfg.set(proto::ConfigKey::DeckId, static_cast<int32_t>(proto::Deck::A));
    ESP_LOGW(TAG, "twin is both decks; ignoring a saved deck B. Left is channel 1, right is channel 2");
  }
#endif
  ESP_LOGI(TAG, "config: %s; deck %c", loadStatusText(ls), g_cfg.deck() == proto::Deck::A ? 'A' : 'B');

  uint8_t mac[6];
  radio::readStationMac(mac);

  // ---- sensors ----
  // The encoder first: the ADC's share of the 1 ms sensor budget is what the AS5600 read leaves (sensor_budget.h).
  g_buttons.begin();
  if (pins::kLoopOutRight >= 0) {
    ESP_LOGI(TAG,
             "twin: right pitch GPIO%d, crossfader GPIO%d, play GPIO%d, loop in GPIO%d, "
             "right cue/play/in/out GPIO%d/%d/%d/%d",
             pins::kPitchRight, pins::kCrossfader, pins::kPlay, pins::kLoopIn, pins::kCueRight, pins::kPlayRight,
             pins::kLoopInRight, pins::kLoopOutRight);
  } else {
    ESP_LOGI(TAG, "twin: right pitch GPIO%d, crossfader GPIO%d; right loop out has no pin (status LED owns GPIO48)",
             pins::kPitchRight, pins::kCrossfader);
  }
#if CONFIG_EPDJ_AS5600_ENABLE || CONFIG_EPDJ_DAC_PROBE_I2C
  g_i2c.begin();
#endif
#if CONFIG_EPDJ_AS5600_ENABLE
  if (g_i2c.ok()) g_as5600.begin(g_i2c);
#endif
#if CONFIG_EPDJ_TWIN
  if (!g_i2cB.beginOn(twin_pins::kEncSda, twin_pins::kEncScl)) {
    ESP_LOGE(TAG, "twin: second I2C bus failed (SDA GPIO%d SCL GPIO%d)", twin_pins::kEncSda, twin_pins::kEncScl);
  }
  g_twin.begin(g_i2c, g_i2cB);
  ESP_LOGI(TAG, "twin: right encoder %s", g_twin.encoderB().present() ? "answered at 0x06" : "NOT answering at 0x06");
#endif
  // The ADC takes what the encoder read leaves of the 400 us. An encoder that did not answer may still turn up (it is asked
  // again while running), so its share is reserved anyway when the AS5600 is the platter: finding it later must not push the
  // sensors past the budget.
  const bool encoderExpected = g_as5600.canRetry() && g_cfg.get(proto::ConfigKey::PlatterSource) ==
                                                           static_cast<int32_t>(proto::PlatterSource::As5600);
  if (!g_adc.begin(hal::sensor_budget::i2cReserveUs(encoderExpected, g_as5600.present(), g_as5600.readUs()))) {
    ESP_LOGE(TAG, "ADC failed: the slide pots and the knob will read 0");
  }
  unsigned touchPads = CONFIG_EPDJ_TOUCH_PAD_COUNT;
#if CONFIG_EPDJ_TWIN
  if (touchPads != 2) {
    ESP_LOGW(TAG, "twin scans exactly two hold pads (GPIO4 left, GPIO5 right); menuconfig had %u", touchPads);
    touchPads = 2;
  }
#endif
  if (touchPads > 0 && !g_touch.begin(touchPads)) {
    ESP_LOGE(TAG, "touch pads failed: no platter input");
  }
  logPlatter();

  // ---- DAC ----
  // dacMode decides at boot because the USB descriptors cannot change afterwards. Only AUTO looks at the strap
  // (16 ms of samples, so noise on an open wire cannot enable USB audio); ON and OFF are not second-guessed.
  const auto dacMode = static_cast<proto::DacMode>(g_cfg.get(proto::ConfigKey::DacMode));
  bool dacPresent = false;
  if (dacMode == proto::DacMode::On) {
    dacPresent = true;
    ESP_LOGI(TAG, "dac: mode ON (forced) -> present");
  } else if (dacMode == proto::DacMode::Off) {
    ESP_LOGI(TAG, "dac: mode OFF -> absent (MIDI only)");
  } else {
    const hal::DacDetection dd = hal::detectDac(&g_i2c);
    dacPresent = dd.present();
    ESP_LOGI(TAG, "dac: mode AUTO, strap low %u/%u samples%s, codec %s -> %s", static_cast<unsigned>(dd.strapLow),
             static_cast<unsigned>(hal::DacDetection::kStrapSamples), dd.strapUnstable() ? " (UNSTABLE: wire or contact?)" : "",
             dd.codec ? "found" : "none", dacPresent ? "present" : "absent (MIDI only)");
  }
  if (dacPresent && !audio_out::start(usb_dev::audioFeedbackSink())) {
    ESP_LOGE(TAG, "I2S output failed to start: continuing without audio");
    dacPresent = false;
  }

  // ---- USB ----
  usb_dev::Params up;
  up.deck = static_cast<uint8_t>(g_cfg.deck());
  up.audio = dacPresent;
  std::memcpy(up.mac, mac, sizeof mac);
  const bool usbOk = usb_dev::start(up);
  if (!usbOk) ESP_LOGE(TAG, "USB failed to start");

  // ---- radio, TRS MIDI, LED ----
  bool radioOn = false;
#if CONFIG_EPDJ_LINK
  radioOn = radio::start(CONFIG_EPDJ_LINK_CHANNEL);
#endif
  bool trsOn = false;
#if CONFIG_EPDJ_TRS_MIDI
  trsOn = g_trs.begin();
#endif
  const bool ledOn = g_led.begin();

  // ---- engine ----
  Engine::Identity id;
  id.hwRev = CONFIG_EPDJ_HW_REV;
  id.serial = (static_cast<uint32_t>(mac[2]) << 24) | (static_cast<uint32_t>(mac[3]) << 16) |
              (static_cast<uint32_t>(mac[4]) << 8) | mac[5];
  if (g_as5600.present()) id.caps |= proto::caps::kAs5600;
  if (g_touch.count() >= 3) id.caps |= proto::caps::kTouchRing;
  if (trsOn) id.caps |= proto::caps::kTrsMidi;
  if (radioOn) id.caps |= proto::caps::kLink;
  if (usbOk && usb_dev::audioEnabled()) id.caps |= proto::caps::kUsbAudio;
  if (ledOn) id.caps |= proto::caps::kStatusLed;
  std::memcpy(id.mac.b, mac, sizeof mac);
  id.epoch = static_cast<uint16_t>(esp_random() & 0xFFFFu);
  if (id.epoch == 0) id.epoch = 1;
#ifdef CONFIG_EPDJ_LINK_GROUP
  id.linkGroup = CONFIG_EPDJ_LINK_GROUP;  // build-time default: the engine uses it while the linkGroup config key is 0
#endif

  Engine* engine = new (g_engineStorage) Engine(g_cfg, g_platform, id);

  g_rt.cfg = &g_cfg;
  g_rt.engine = engine;
  g_rt.touch = &g_touch;
  g_rt.adc = &g_adc;
  g_rt.buttons = &g_buttons;
  g_rt.as5600 = &g_as5600;
#if CONFIG_EPDJ_TWIN
  g_rt.twin = &g_twin;
#endif
  g_rt.trs = trsOn ? &g_trs : nullptr;
  g_rt.led = ledOn ? &g_led : nullptr;
  g_rt.radioOn = radioOn;
  g_rt.linkGroupDefault = id.linkGroup;
  g_rt.caps = id.caps;
  g_rt.dacPresent = dacPresent;

  if (radioOn) ESP_LOGI(TAG, "link group %u (%s)", static_cast<unsigned>(app::effectiveLinkGroup(g_rt)),
                        g_cfg.get(proto::ConfigKey::LinkGroup) != 0 ? "linkGroup config key" : "build default");

  // 512 bytes on the 100 kHz display bus. Painted here, once, before the engine task exists, so a frame
  // can never sit in front of an encoder read.
  const char* encLine = "NO ENCODER";
  if (g_as5600.present()) {
    switch (g_as5600.magnet()) {
      case hal::sensor_budget::Magnet::Ok: encLine = "MAGNET OK"; break;
      case hal::sensor_budget::Magnet::TooWeak: encLine = "MAGNET TOO WEAK"; break;
      case hal::sensor_budget::Magnet::TooStrong: encLine = "MAGNET TOO CLOSE"; break;
      case hal::sensor_budget::Magnet::Missing: encLine = "NO MAGNET"; break;
      default: encLine = "MAGNET ?"; break;
    }
  }
  const hal::OledBringup oled = hal::oledBringup(g_i2c, g_cfg.deck() == proto::Deck::A ? 'A' : 'B', encLine);
  sd::start(g_i2c);
  if (ledOn) {
    // Long enough to read before the engine task takes the LED: green answered, red did not.
    g_led.set(oled.present ? hal::StatusLed::Rgb{0, 180, 0} : hal::StatusLed::Rgb{180, 0, 0});
    vTaskDelay(pdMS_TO_TICKS(600));
  }
  if (!oled.present && g_i2c.ok()) {
    ESP_LOGW(TAG, "oled stayed blank: no SSD1306 on SDA GPIO%d SCL GPIO%d", g_i2c.sda(), g_i2c.scl());
  }

  app::startEngineTask(&g_rt);
  app::startDiagTask(&g_rt);
  ESP_LOGI(TAG, "ready: caps 0x%04X, serial %08lX, MIDI channel %u", static_cast<unsigned>(id.caps),
           static_cast<unsigned long>(id.serial), static_cast<unsigned>(g_cfg.effectiveChannel()) + 1u);
}
