johnnyclem/EP-DJ3000/field-jog/firmware/rp2040/src/tusb_config.h

#ifndef TUSB_CONFIG_H_
#define TUSB_CONFIG_H_

#ifdef __cplusplus
extern "C" {
#endif

#ifndef BOARD_TUD_RHPORT
#define BOARD_TUD_RHPORT 0
#endif

#ifndef BOARD_TUD_MAX_SPEED
#define BOARD_TUD_MAX_SPEED OPT_MODE_FULL_SPEED
#endif

#ifndef CFG_TUSB_MCU
#error CFG_TUSB_MCU must be defined
#endif

#ifndef CFG_TUSB_OS
#define CFG_TUSB_OS OPT_OS_NONE
#endif

#ifndef CFG_TUSB_DEBUG
#define CFG_TUSB_DEBUG 0
#endif

#define CFG_TUD_ENABLED 1
#define CFG_TUD_MAX_SPEED BOARD_TUD_MAX_SPEED

#ifndef CFG_TUSB_MEM_SECTION
#define CFG_TUSB_MEM_SECTION
#endif

#ifndef CFG_TUSB_MEM_ALIGN
#define CFG_TUSB_MEM_ALIGN __attribute__((aligned(4)))
#endif

#ifndef CFG_TUD_ENDPOINT0_SIZE
#define CFG_TUD_ENDPOINT0_SIZE 64
#endif

#define CFG_TUD_AUDIO 1
#define CFG_TUD_CDC 0
#define CFG_TUD_MSC 0
#define CFG_TUD_HID 0
#define CFG_TUD_MIDI 0
#define CFG_TUD_VENDOR 0

// One format: 16-bit stereo, 48 kHz. RP2040 is full-speed, so this is UAC1.
#define CFG_TUD_AUDIO_FUNC_1_N_CHANNELS_TX 2
#define CFG_TUD_AUDIO_FUNC_1_FORMAT_1_N_BYTES_PER_SAMPLE_TX 2

#define CFG_TUD_AUDIO_ENABLE_EP_IN 1

// (48000 + 999) / 1000 + 1 samples, times 2 bytes, times 2 channels = 200.
#define CFG_TUD_AUDIO_FUNC_1_EP_IN_SZ_MAX \
  TUD_AUDIO_EP_SIZE(false, 48000, CFG_TUD_AUDIO_FUNC_1_FORMAT_1_N_BYTES_PER_SAMPLE_TX, CFG_TUD_AUDIO_FUNC_1_N_CHANNELS_TX)

// Flow control wants at least four packets queued.
#define CFG_TUD_AUDIO_FUNC_1_EP_IN_SW_BUF_SZ (4 * CFG_TUD_AUDIO_FUNC_1_EP_IN_SZ_MAX)

#ifdef __cplusplus
}
#endif

#endif
