johnnyclem/EP-DJ3000/firmware/esp32s3/main/device_platform.h

// What only the platform can do for the engine: restart, persist, play the test tone (epdj::EnginePlatform).
#pragma once
#include "epdj/config.h"
#include "epdj/engine.h"
#include "epdj_hal/nvs_store.h"

namespace epdj {
namespace app {

// Values a unit with nothing saved starts with, from Kconfig (first-boot platter source and deck).
void applyFirstBootDefaults(Config* cfg);

class DevicePlatform final : public EnginePlatform {
 public:
  explicit DevicePlatform(hal::NvsConfigStore& store) : store_(store) {}

  // Restarts in ~200 ms so the ACK that is already queued can leave on the USB endpoint first.
  // BOOTLOADER stops the USB stack, hands the native port back to the ROM's USB-Serial-JTAG and sets the ROM
  // "force download boot" flag (esptool over the native port). Not tested on a chip.
  void reboot(proto::RebootMode mode) override;
  // Persists the new deck (only the deck: unsaved live tweaks stay unsaved) and restarts to re-enumerate.
  void setDeck(proto::Deck deck) override;
  bool testTone(bool on, uint16_t freqHz, uint8_t attenDb) override;
  bool saveConfig(const Config& cfg) override;

 private:
  hal::NvsConfigStore& store_;
};

}  // namespace app
}  // namespace epdj
