johnnyclem/EP-DJ3000/firmware/core/test/test_engine_core.cpp

// Engine in DJ mode: platter, fader, knob, buttons and gestures, channels, host feedback, USB presence,
// TRS pass-through. Scripted sessions over simulated sensors, simulated time only.
#include <cstdlib>
#include <memory>

#include "test_engine_sim.h"

using namespace esim;

namespace {

constexpr int kSettleMs = 3600;  // the touch detector learns its baseline for 250 ms and settles for 3 s

// A unit as the firmware ships it: AS5600 platter, one hold pad, nothing configured.
std::unique_ptr<Deck> makeDeck(int deckId = 0) {
  std::unique_ptr<Deck> d(new Deck(deckId));
  d->touchIdle(kSettleMs);
  d->clearLog();
  return d;
}

// The experimental touch ring, selected explicitly: it is not the default platter.
std::unique_ptr<Deck> makeRingDeck(int deckId = 0) {
  std::unique_ptr<Deck> d(new Deck(deckId));
  d->useRing();
  d->touchIdle(kSettleMs);
  d->clearLog();
  return d;
}

// Runs a test body on the default platter (AS5600 + hold pad) and on the touch ring: touch, tap and scratch
// semantics are the same on both, the sensors in front of them are not.
std::unique_ptr<Deck> makeDeckFor(bool ring, int deckId = 0) { return ring ? makeRingDeck(deckId) : makeDeck(deckId); }

bool allOnChannel(const std::vector<Bytes>& v, uint8_t ch) {
  for (const Bytes& m : v) {
    if (m.empty() || m[0] < 0x80 || m[0] >= 0xF0) continue;
    if ((m[0] & 0x0F) != ch) return false;
  }
  return true;
}

std::vector<Bytes> notesOnly(const std::vector<Bytes>& v) {
  std::vector<Bytes> r;
  for (const Bytes& m : v) {
    if (m.size() == 3 && ((m[0] & 0xF0) == 0x90 || (m[0] & 0xF0) == 0x80)) r.push_back(m);
  }
  return r;
}

// USB cable 0 messages grouped by the step that produced them.
std::vector<std::vector<Bytes>> perStep(const std::vector<Rec>& log) {
  std::vector<std::vector<Bytes>> g;
  uint64_t last = ~0ull;
  for (const Rec& r : log) {
    if (r.kind != OutEvent::Kind::Message || !(r.portMask & ports::kUsb) || r.cable != 0) continue;
    if (r.t != last) g.emplace_back();
    last = r.t;
    g.back().push_back(r.bytes);
  }
  return g;
}

bool ccPresent(const std::vector<Bytes>& v, uint8_t cc) {
  for (const Bytes& m : v) {
    if (m.size() == 3 && (m[0] & 0xF0) == 0xB0 && m[1] == cc) return true;
  }
  return false;
}

}  // namespace

// ---- platter ---------------------------------------------------------------------------------

EPDJ_TEST(engine_ring_sweep_jog_on_channel_with_conservation) {
  for (int deckId = 0; deckId < 2; ++deckId) {
    for (int dir = -1; dir <= 1; dir += 2) {
      std::unique_ptr<Deck> d = makeRingDeck(deckId);
      d->ringGesture(0.25, 0.5 * dir, 2.0, 100);
      d->run(300);  // let the 500 Hz emitter flush

      const uint8_t ch = static_cast<uint8_t>(deckId);  // Deck B = channel 2 (zero-based 1)
      const std::vector<Bytes> msgs = usbMsgs(d->log, 0);
      CHECK(allOnChannel(msgs, ch));
      const int64_t sum = ccSum(msgs, ch, proto::cc::kJog);
      CHECK_EQ(sum, d->engine.jogTotal());  // every tick the tracker produced reached the host
      CHECK(sum * dir > 0);
      CHECK_NEAR(static_cast<double>(sum) * dir, 2.0 * 1024, 2.0 * 1024 * 0.04);  // two revolutions, within 4%

      // Wire rules: never 64 (no change), never 0, at most one message per 2 ms.
      uint64_t lastT = 0;
      int jogMsgs = 0;
      for (const Rec& r : d->log) {
        if (r.kind != OutEvent::Kind::Message || r.bytes.size() != 3 || r.bytes[1] != proto::cc::kJog) continue;
        CHECK(r.bytes[2] != 64 && r.bytes[2] != 0);
        if (jogMsgs++ > 0) CHECK(r.t - lastT >= 2000);
        lastT = r.t;
      }
      CHECK(jogMsgs > 100);
      CHECK_EQ(countEq(notesOnly(msgs), b({0x90 | ch, 38, 127})), 1);  // touch down
      CHECK_EQ(countEq(notesOnly(msgs), b({0x80 | ch, 38, 0})), 1);    // touch up
    }
  }
}

EPDJ_TEST(engine_as5600_spin_is_exact_and_respects_invert) {
  for (int invert = 0; invert <= 1; ++invert) {
    Deck d(0);  // contract defaults: the AS5600 is the platter
    CHECK_EQ(d.cfg.get(ConfigKey::PlatterSource), static_cast<int>(proto::PlatterSource::As5600));
    d.reportUntouched();  // nobody touches the hold pad here: this is about the exactness of the ticks, not the policy
    d.set(ConfigKey::JogInvert, invert);
    d.in.angle12 = 1234;
    d.run(50);
    d.clearLog();
    Rng rng(99);
    int64_t units = 0;  // angle units travelled, clockwise positive
    int angle = 1234;
    for (int i = 0; i < 8000; ++i) {
      const int speed = (i / 1000) % 2 == 0 ? 20 : -35;  // units per ms: about 5 and 8.5 ticks per ms
      const int delta = speed + rng.range(-3, 3);
      angle = (angle + delta + 4096) & 4095;
      units += delta;
      d.in.angle12 = static_cast<uint16_t>(angle);
      d.step();
    }
    d.run(300);
    const int64_t sum = ccSum(usbMsgs(d.log, 0), 0, proto::cc::kJog);
    CHECK_EQ(sum, d.engine.jogTotal());
    // Exact integer conservation: at most the sub-tick remainder (< 4 units) is held back.
    const int64_t want = invert ? -units : units;
    CHECK(std::llabs(sum * 4 - want) < 4);
    CHECK(std::llabs(sum) > 1000);
  }
}

EPDJ_TEST(engine_touch_and_tap_notes_and_play_pulse) {
  for (int ring = 0; ring <= 1; ++ring) {
    std::unique_ptr<Deck> d = makeDeckFor(ring != 0);
    for (int i = 0; i < 100; ++i) d->touchStep(true);  // a quick, motionless touch
    d->touchIdle(100);
    const std::vector<Bytes> notes = notesOnly(usbMsgs(d->log, 0));
    CHECK_EQ(notes.size(), 4);
    if (notes.size() == 4) {
      CHECK_BYTES(notes[0], b({0x90, 38, 127}));
      CHECK_BYTES(notes[1], b({0x80, 38, 0}));
      CHECK_BYTES(notes[2], b({0x90, 39, 127}));  // play pulse: 127 ...
      CHECK_BYTES(notes[3], b({0x80, 39, 0}));    // ... then 0
    }
    uint64_t on = 0, off = 0;
    for (const Rec& r : d->log) {
      if (r.bytes.size() == 3 && r.bytes[1] == 39) (r.bytes[0] == 0x90 ? on : off) = r.t;
    }
    CHECK(off - on >= 10000 && off - on <= 12000);

    // tapPlay = 0: the touch notes only.
    d->clearLog();
    d->set(ConfigKey::TapPlay, 0);
    for (int i = 0; i < 100; ++i) d->touchStep(true);
    d->touchIdle(100);
    CHECK_EQ(notesOnly(usbMsgs(d->log, 0)).size(), 2);
  }
}

EPDJ_TEST(engine_long_or_moving_touch_is_not_a_tap) {
  for (int ring = 0; ring <= 1; ++ring) {
    std::unique_ptr<Deck> d = makeDeckFor(ring != 0);
    for (int i = 0; i < 400; ++i) d->touchStep(true);  // held longer than tapMaxMs (180 ms)
    d->touchIdle(100);
    CHECK_EQ(countEq(notesOnly(usbMsgs(d->log, 0)), b({0x90, 39, 127})), 0);

    d->clearLog();
    d->gesture(0.2, 0.5, 0.2, 20, 0);  // short but travels far more than tapMoveTicks
    CHECK_EQ(countEq(notesOnly(usbMsgs(d->log, 0)), b({0x90, 39, 127})), 0);
    CHECK(ccSum(usbMsgs(d->log, 0), 0, proto::cc::kJog) > 100);
  }
}

EPDJ_TEST(engine_platter_source_change_does_not_strand_the_touch_note) {
  std::unique_ptr<Deck> d = makeRingDeck();
  for (int i = 0; i < 200; ++i) d->ringStep(0.4, 1.0);  // finger resting
  CHECK_EQ(countEq(notesOnly(usbMsgs(d->log, 0)), b({0x90, 38, 127})), 1);
  d->set(ConfigKey::PlatterSource, static_cast<int>(proto::PlatterSource::As5600));  // live switch to the AS5600 while touched
  for (int i = 0; i < 50; ++i) d->ringStep(0.4, 1.0);
  d->ringIdle(100);
  // Every touch-down has its touch-up before the next one: the host never sees a doubled note-on.
  int open = 0, downs = 0;
  for (const Bytes& m : notesOnly(usbMsgs(d->log, 0))) {
    if (m[1] != 38) continue;
    open += m[0] == 0x90 ? 1 : -1;
    downs += m[0] == 0x90 ? 1 : 0;
    CHECK(open == 0 || open == 1);
  }
  CHECK_EQ(open, 0);
  CHECK_EQ(downs, 2);  // the finger that stayed down is a new touch for the new platter source
}

// ---- fader and knob ----------------------------------------------------------------------------
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
