johnnyclem/EP-DJ3000/firmware/core/test/test_jog.cpp

#include <cmath>
#include <cstdlib>
#include <vector>

#include "epdj/jog.h"
#include "epdj/touch_ring.h"
#include "epdj/util.h"
#include "test_harness.h"

using namespace epdj;
using proto::PlatterSource;

namespace {

struct Rng {
  uint32_t s;
  explicit Rng(uint32_t seed) : s(seed ? seed : 1u) {}
  uint32_t next() {
    s ^= s << 13;
    s ^= s >> 17;
    s ^= s << 5;
    return s;
  }
  double uni() { return static_cast<double>(next()) * (1.0 / 4294967296.0); }
  double sym() { return 2.0 * uni() - 1.0; }
  int range(int lo, int hi) { return lo + static_cast<int>(next() % static_cast<uint32_t>(hi - lo + 1)); }
};

// Synthetic touch ring: finger = arc of `widthSectors` sectors with soft edges, rise per sector =
// covered fraction x peak x sector gain, +/- `noisePermille` uniform noise, quantised to counts.
struct RingSim {
  unsigned n;
  double baseline[8];
  double gain[8];
  double peakPermille = 40.0;
  double widthSectors = 1.5;
  double noisePermille = 3.0;
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
