johnnyclem/EP-DJ3000/(commit log)

2026-10-31 Export from Grok
    [bar.stl, bottom.stl, button.stl, fader.stl, fader_lock.stl, field-jog.scad, foot.stl, knob.stl]
2026-11-01 Fit Field Jog to the Sidekick footprint and show it on the page.
    88 by 240 mm shell, platter centered, knob above the jog, Technic holes at 16, 25, 48, 216 and 224 mm. Setup viewer, product renders, and rebuilt tray and deck STLs.
    [bottom.stl, field-jog.scad, top.stl]
2026-11-01 Add EP-DJ3000 wire contract, generators, spec and core test skeleton
    Single source of truth (protocol/epdj3000.json) with a generator that emits
    C++, Swift and JS plus doc tables (--check detects drift), an independent
    Python reference that produces byte-exact shared test vectors, the protocol
    and architecture docs, and a dependency-free host test harness for the
    portable firmware core.
    The Field Jog web viewer is untouched; eslint/prettier ignore the new
    hardware trees so the web app's lint gate is unaffected.
    Claude-Session: https://claude.ai/code/session_01LXpWQwrPCZnSMz4MWpnUa9
    [harness_main.cpp, test_harness.h, test_protocol.cpp]
2026-11-02 Add firmware core, ESP32-S3 platform layer, macOS app and DJ mappings
    First complete cut of the EP-DJ3000 stack against the frozen contract:
    - firmware/core: portable C++17 (touch-ring/AS5600 jog, fader/knob, buttons
    and gestures, MIDI/SysEx/config, clock/transport/MTC/BPM, radio link,
    UAC feedback + tone DSP, Engine). 27 host test binaries pass under
    ASan+UBSan, including a 1 h simulated-session stability run.
    - firmware/esp32s3: ESP-IDF project (HAL, TinyUSB composite MIDI + UAC2,
    I2S, ESP-NOW, NVS). Links for ESP32-S3 via PlatformIO and idf.py.
    - macos: pure-Swift protocol/engine libraries (226 tests on Linux) and the
    CoreMIDI/AVAudio/SwiftUI app. The Apple layer is NOT compile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
    [EP-DJ3000-Deck-A.midi.csv, EP-DJ3000-Deck-B.midi.csv, partitions.csv]
2026-11-02 Contract v1.1: Peer.status, linkGroup, channel-volume fader default
    Applies the contract questions raised by the first implementation round:
    - Peer.reserved -> Peer.status with a PeerStatus bit field (CONFLICT).
    - New config key linkGroup (units only link within the same group).
    - faderRole defaults to CHANNEL_VOLUME so two decks never fight over one
    crossfader in the two-deck + mixer rig.
    - Generated headers now carry the USB identity (VID/PID, names), and the
    generator writes the Mixxx constants copy itself.
    - Spec prose settles behaviour the implementations had to guess:
    channel filtering, play note is feedback-only, LOAD_DEFAULTS keeps
    deckId, SET_CONFIG(deckId) is NOT_SUPPORTED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
2026-11-02 Fix pass: contract v1.1 conformance, UAC1 audio, app and driver updates
    Brings every component in line with contract v1.1 and resolves the
    issues the first implementation round flagged:
    - core: LOAD_DEFAULTS keeps deckId, SET_CONFIG(deckId) is NOT_SUPPORTED,
    GET_CONFIG dump ends with an ACK, the inbound play note is feedback
    only in every mode, linkGroup from config, knob-BPM pickup.
    - platform: USB audio migrated per the TinyUSB evidence, generated USB
    identity used by the descriptor builder, doc/toolchain wording fixed.
    - macOS libraries: dump terminated by ACK, tolerant of key-count
    differences, KitPure target so the pure Kit logic is tested on Linux.
    - drivers: defaults table ch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
    [EP-DJ3000-Deck-A.midi.csv, EP-DJ3000-Deck-B.midi.csv]
2026-11-02 Add e2e harness, USB/RT hardening, Apple-layer fix, root README and docs
    Fix-pass round 2, all re-verified (core 27/27 under ASan+UBSan, Swift 363
    tests, drivers 6/6, e2e suites green, ESP32-S3 links warning-free).
    - e2e harness: the real firmware Engine runs as a host process and the
    real Swift client / ControllerState / DeckModel and the real Mixxx
    script are driven against it. It proves jog/fader/calibration agreement
    across the three implementations and tracks three open disagreements as
    KNOWN ISSUE (CAL_END apply=0, ControllerState role switch-back,
    SYNC_MASTER play LED).
    - platform: UAC1 audio (descriptor byte-identical to TinyUSB macros;
    TinyUSB's real audio driver drives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
    [adc_inputs.cpp, as5600.cpp, device_platform.cpp, device_platform.h, diag_task.cpp]
2026-11-02 Contract v1.2: slide pot defaults to PITCH; close the three e2e findings
    The completeness review showed the v1.1 default (CHANNEL_VOLUME) leaves the
    fader dead in VirtualDJ, djay Pro and rekordbox when an external mixer is
    used (the headline two-deck + Sidekick rig). A CDJ's slider is the tempo
    fader, so faderRole now defaults to PITCH (CC 25/57): audible in all four
    apps, and two units still never fight over one control.
    The end-to-end harness found three real disagreements between the
    firmware, the Swift client and the spec; all are now fixed and pinned:
    - CAL_END apply=0 returns the measured extremes (apply=1 the inset range).
    - ControllerState updates faderRole on any pair, even at an u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
    [EP-DJ3000-Deck-A.midi.csv, EP-DJ3000-Deck-B.midi.csv]
2026-11-02 Contract v1.3: AS5600 platter is the default; touch ring kept as experimental
    Owner decision: use the AS5600 platter for now. platterSource now defaults
    to AS5600 (a free-spinning platter on a bearing over a magnetic encoder);
    touch/hold comes from one touch pad. The segmented touch ring is kept,
    tested and documented as an experimental option, not deleted.
    - firmware: Kconfig first-boot defaults (AS5600 platter, one hold pad,
    encoder on), a single boot log line for the platter/encoder/magnet
    status with a loud WARN when no encoder answers, and the AS5600 read
    now shares the 400 us sensor budget with the ADC.
    - core + e2e: the five tests that assumed the ring now select it
    explicitl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
2026-11-02 Slim the shell to 16 mm and add the top-end jacks.
    The case matches the EP-133 thickness. USB-C sits on the top end between MIDI and line jacks, with a headphone jack on the fader end. Includes the RP2040 USB Audio Class firmware.
    [bottom.stl, fader.stl, field-jog.scad, top.stl]
2026-11-02 Replace engraved type with a blank battery faceplate.
    FDM tore the lettering out of the deck. The top 45 mm is now a flat 1.6 mm plate over a battery bay, meant to be silkscreened.
    [bottom.stl, faceplate.stl, field-jog.scad, top.stl]
2026-11-02 Add a 128x32 OLED slot to the battery faceplate.
    The opening fits the 0.91 inch SSD1306, left of the knob. Playback stays on the ESP32-S3.
    [faceplate.stl, field-jog.scad]
2026-11-02 Call the battery bay a board bay, not a Pico bay.
2026-11-02 Add round cue, play, and loop buttons.
    Cue and play are 16 mm caps on the lower left. Loop in and out sit above them with LED holes. Tempo stays on the knob.
    [button.stl, field-jog.scad, loop.stl, top.stl]
2026-11-02 Join the button stems to the caps.
    [button.stl, field-jog.scad, loop.stl]
2026-11-02 Seat the 82x73 audio kit below the platter.
    The 73 mm side runs across the deck. The scratch fader shortens to a 40 mm slot so the board clears the pin ribs and the encoder pad.
    [bottom.stl, field-jog.scad, top.stl]
2026-11-02 Apply lessons from the original firmware: AS5600 filter config, sticky touch release, jogUntouched
    The owner shared the original creator's Arduino sketch. We took the ideas,
    not the code (no licence known; none copied):
    - AS5600: the HAL now writes the chip's CONF register (watchdog off,
    hysteresis 0, 16x slow filter, fast-filter threshold 7 = 0x1C00), reads
    it back, and by default reads the filtered ANGLE register 0x0E
    (Kconfig EPDJ_AS5600_FILTERED_ANGLE; n keeps raw 0x0C for a bench A/B).
    A missing chip is re-probed every 500 ms instead of never.
    - Engine: sticky touch release (after a 7 s touch, release only after the
    platter has been still for 80 ms) so a dropping pad signal c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
    [as5600.cpp, diag_task.cpp, engine.cpp, engine.h]
2026-11-02 Record the Audio Kit board conflict and date the shell-dependent hardware statements
    The owner's latest shell redraw (main b06055e) is built around an ESP32-Audio-Kit V2.2,
    a classic ESP32 with no USB device mode, while the rest of the repo targets the ESP32-S3.
    Documented as an explicit open question; hardware docs now say which shell commit their
    mechanical arithmetic is based on.
    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
2026-11-03 Seat a headerless ESP32-S3 DevKit and lower the encoder pad.
    The audio kit is out. The AS5600 pad drops to 3.5 mm and the axle is an M3x6, so the magnet clears the chip and the floor.
    [bottom.stl, field-jog.scad, top.stl]
2026-11-03 Record the ESP32-S3-DevKitC-1 board decision across the docs.
    The board is now chosen (headerless ESP32-S3-DevKitC-1), so the
    "board conflict" notes and Audio Kit/Pico-era wording are replaced
    with the settled plan:
    - hardware/WIRING.md: pin plan checked against Espressif's J1/J3
    header tables; free clean GPIOs listed; JTAG/supply-domain caveats.
    - hardware/README.md: stack-up cross-check on paper (M3x5 vs M3x6,
    measure the breakout before committing) and a "Shell controls vs
    firmware" table with a not-implemented proposal for PLAY, LOOP IN,
    LOOP OUT and the two LEDs.
    - docs/BRINGUP.md: new step 2c, prove REBOOT(bootloader) before
    closing the deck, since only native USB is reachab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
2026-11-03 Cut the faceplate window to the measured OLED glass.
    The opening is 30.5 by 11.85 mm. The 40 by 12.85 mm board is what keeps the glass from falling through.
    [faceplate.stl, field-jog.scad, top.stl]
2026-11-04 Cradle the 75 mm slide pot in place of the magnet fader.
    The slot is 66 mm for the 60 mm travel. The cap grips the metal tang, and the hall posts are gone.
    [bottom.stl, fader.stl, field-jog.scad, top.stl]
2026-11-04 Mount the 75 mm slide pot instead of the loose fader.
    The slot is narrowed to the 1.2 mm lever, the body gets 8.2 mm of height, and two M2 holes land on the pot's own threads.
    [bottom.stl, fader.stl, field-jog.scad, top.stl]
2026-11-04 Close the battery bay so the deck only opens for the OLED glass.
    The through-cut is 30.5 by 11.85 mm. The 40 by 12.85 mm board sits in a pocket behind the faceplate.
    [field-jog.scad, top.stl]
2026-11-04 Add 1:1 vinyl cut files for the deck and faceplate.
    Labels sit beside the buttons and on the faceplate. The screen, knob and platter stay clear.
2026-11-04 Open a real pouch well under the faceplate.
    The door was a plate over solid plastic. A 5 by 12 by 30 mm cell now sits on a pedestal left of the DevKit.
    [bottom.stl, field-jog.scad, top.stl]
2026-11-04 Raise the top end so a 2xAA holder fits under the door.
    The playing surface stays 16 mm. The top 52 mm is 22 mm, with a 60 by 34.5 mm pocket for a 59 by 33 by 15 mm holder.
    [bottom.stl, button.stl, faceplate.stl, field-jog.scad, loop.stl, top.stl]
2026-11-04 Retain the plungers with a clip and seat a 6x6 under each one.
    The stem is longer, necks down, and a clip snaps on from inside the tray. The tray has a nest for a 5 mm tactile.
    [bottom.stl, button.stl, field-jog.scad, flange.stl, loop.stl, top.stl]
2026-11-04 Guide the plungers so the click happens before the stop.
    A 2 mm boss lengthens the bore to 6.2 mm, and the travel is 0.45 mm so the dome is not crushed.
    [button.stl, field-jog.scad, flange.stl, loop.stl, top.stl]
2026-11-05 update readme/bringup. adds platter description and teswt
    [carrier.stl, platter-test.scad, stand.stl, wedge.stl, wedges.stl]
2026-11-05 update .3mf models
    [v4.3mf]
2026-11-05 Close the case on magnets and make the battery roof part of the top shell.
    Four 5x20x2 mm magnets in each half replace the corner screws. The raised end is no longer a separate door.
    [bottom.stl, field-jog.scad, top.stl]
2026-11-05 Add a handheld sleeve for the ECM-77B.
    96 by 18.8 mm, slot grille, orange cap. The capsule slides in from the tip and the cable leaves the back.
    [body.stl, button.stl, ecm-handy.scad]
2026-11-05 troubleshooting oled for firmware
    [long-print.3mf]
2026-11-06 Add wide Field Jog mockups at the measured K.O. II size.
    Twin 76 mm platters, or one 152 mm platter, on a 176 by 240.5 mm deck with the pitch faders and the other controls that did not fit in 88 mm.
2026-11-06 Add OpenSCAD for the twin and 6 inch wide decks.
    Both are the measured 176 by 240.5 mm body. Twin carries two 76 mm platters, Six one 152 mm platter.
    [wide-six-bottom.stl, wide-six-platter.stl, wide-six-top.stl, wide-twin-bottom.stl, wide-twin-platter.stl, wide-twin-top.stl, wide.scad]
2026-11-06 Clear the rear jacks and center the USB-C window on the wide decks.
    The corner magnet posts were filling the two outer ports. USB-C now sits in the middle of the rear wall, with the four jacks between the magnets.
    [wide-six-bottom.stl, wide-twin-bottom.stl, wide.scad]
2026-11-06 Press-fit the diametric magnet into the platter stem.
    The cup has a lip tighter than the 6 mm magnet, and a barbed stem snaps through the deck so the platter stays down without glue.
    [field-jog.scad, platter.stl, top.stl, wide-six-platter.stl, wide-six-top.stl, wide-twin-platter.stl, wide-twin-top.stl, wide.scad]
2026-11-06 Turn the 128x32 OLED on by sending SSD1306 commands intact.
    The 0.91 inch panels ignore a charge-pump argument that arrives in the next I2C start, so the glass stayed dark while every write still ACKed.
2026-11-06 working on oled support in firmware
    [v5.3mf]
2026-11-06 Add the Four recorder and split it for the resin plate.
    The face tiles fit a 153.36 x 77.76 x 165 mm build volume. The tray stays one FDM print.
    [cap-master.stl, cap.stl, caps-plate.stl, ear-r.stl, faders-12.stl, faders-34.stl, four.scad, key.stl]
2026-11-06 Rebuild the site so Four and the resin tiles are in the deployed bundle.
    [body.stl, bottom.stl, button.stl, cap-master.stl, cap.stl, caps-plate.stl, ear-r.stl, ecm-handy.scad]
2026-11-06 Let the wide decks isolate case, platter, fader, pads, and knob.
2026-11-07 Add a 1-bit microSD slot and a WAV browser that plays through the DAC.
    The socket sits on the underside, rear-left. CUE and REV browse and play while a card is in, and a held REV gives the buttons back to the deck.
2026-11-07 Show the magnet stem on the wide platters in the viewer.
2026-11-07 Seat the 12x12 toggles in the three jog decks.
    IN, OUT and the other small toggles take the round-cap switch. CUE and PLAY stay printed plungers.
    [field-jog.scad, top.stl, wide-six-top.stl, wide-twin-top.stl, wide.scad]
2026-11-07 Seat the MT6701 under the three jog platters.
    The board is 23 mm square with four M2 holes on a 17.5 mm square. The pad is 26 mm and still 3.5 mm high. The reader uses address 0x06 and keeps the top 12 of the 14-bit angle. The protocol name stays AS5600.
    [bottom.stl, field-jog.scad, wide-six-bottom.stl, wide-twin-bottom.stl, wide.scad]
2026-11-08 Clear the Twin and One 6 internals.
    Jack bodies stay between the magnet posts, the Twin headphone jack sits left of the crossfader, and the Six platter shifts left so the pitch fader has a lane.
    [wide-six-bottom.stl, wide-six-top.stl, wide-twin-bottom.stl, wide-twin-top.stl, wide.scad]
2026-11-08 Document the deck circuit and how it runs.
2026-11-08 Wire the twin deck: sixteen buttons, two pitch faders, two encoders.
2026-11-10 Brighten the Carry face and add parts views.
    Carry and Dual now isolate case, platter, fader, knob and buttons.
    Carry body is lighter stone, the screen arc is cyan, hardware stays orange.
    [carry.scad]
2026-11-10 Point the page at the Carry downloads.
    The featured unit is 214 × 300. The page links its SCAD and notes,
    and the slim and wide sources stay listed beside it.
    [carry.scad]
2026-11-10 Open the Carry glass hole and the switch holes.
    The center is a 35 mm through hole for the GC9A01 glass.
    The switch, fader, encoder and screw holes go through the skin.
    [carry.scad]
2026-11-10 Larger labels, a copper seat, and a captive ring.
    CUE and the cues are about twice the size. A shallow groove under
    the lid seats the copper tape. The ring skirt has a flange that
    hooks under a lip so it stays on while the magnet rides off-axis.
    [carry.scad]
2026-11-10 Gear on the platter, small magnet on the pinion.
    A 62 mm gear on the underside of the ring drives a 14 mm pinion.
    The diametric magnet is 6 mm, on the pinion, clear of the LCD.
    [carry.scad]
2026-11-10 Add charge, headphone and MIDI ports.
    USB-C is centered on the bottom edge. Two 3.5 mm jacks sit on the
    top edge: headphones on the left, TRS MIDI on the right.
    [carry.scad]
2026-11-10 Move the six pitch fader to the bottom row.
    The 125 mm fader sits horizontal, to the right of the two large
    buttons. Those buttons stack on the left. Each is a 16 mm through
    hole with a 3.125 mm LED hole 10 mm to its left.
    [wide.scad]
2026-11-10 Five 3.5 mm jacks and a USB-C panel mount.
    The jacks sit on the right long edge: MIDI in and out, line in
    and out, headphones. USB-C is a rectangular panel-mount cut on
    the bottom edge. All of them go through the wall.
    [carry.scad]
2026-11-10 Put the signal jacks and USB-C on the back.
    MIDI in and out, line in and out, and the centered USB-C sit on
    the back edge. The headphone jack is centered on the front.
    [carry.scad]
2026-11-10 Widen the Carry to 230 mm.
    The body grows 16 mm. The fader and the knob stay the same
    distance from the right edge. The back jacks recenter.
    [carry.scad]
2026-11-10 Export current Carry and wide meshes.
    Carry top, tray, ring, pinion and knob, plus the six and twin
    shells, are regenerated from the SCAD that is on main. The
    Carry downloads are on the page.
    [carry-bottom.stl, carry-knob.stl, carry-pinion.stl, carry-ring.stl, carry-top.stl, wide-six-bottom.stl, wide-six-platter.stl, wide-six-top.stl]
2026-11-10 Regenerate the 88 mm deck meshes.
    Every part of field-jog.scad is exported again: top, tray,
    platter, fader, lock, knob, buttons, clips, marks, faceplate,
    tab, bar and feet.
    [bottom.stl, button.stl, faceplate.stl, fader.stl, fader_lock.stl, field-jog.scad, flange.stl, knob.stl]
2026-11-12 Add the Go, a Mars 5 Ultra handheld.
    150 x 74 x 16, so each half prints flat on the plate. Round
    GC9A01, the 75 mm fader, encoder, cue and play, two utility
    buttons with 3 mm LEDs, USB-C and a headphone jack.
    [go-bezel.stl, go-bottom.stl, go-cap.stl, go-cue.stl, go-knob.stl, go-play.stl, go-top.stl, go-util.stl]
2026-11-13 Give the Go a platter around the screen.
    The ring is 72 mm and spins on a hub. The GC9A01 stays put.
    A gear under the ring turns a pinion with the magnet, clear
    of the board. The shell stands on its long edge to fit the
    Mars 5 Ultra. The platter still prints flat.
    [go-bezel.stl, go-bottom.stl, go-cap.stl, go-cue.stl, go-knob.stl, go-pinion.stl, go-ring.stl, go-top.stl]
